gligli/overcycler/manual/GliGli's Overcycler - Build manual/07b - Solder cable to LCD.JPG

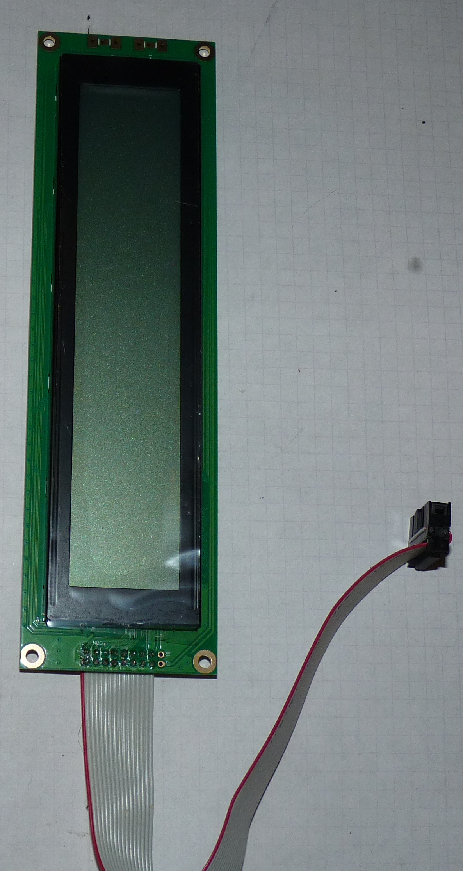
manual/GliGli's Overcycler - Build manual/07b - Solder cable to LCD.JPG
