gligli/overcycler/manual/GliGli's Overcycler - Build manual/12d - Screw panel onto enclosure top.JPG

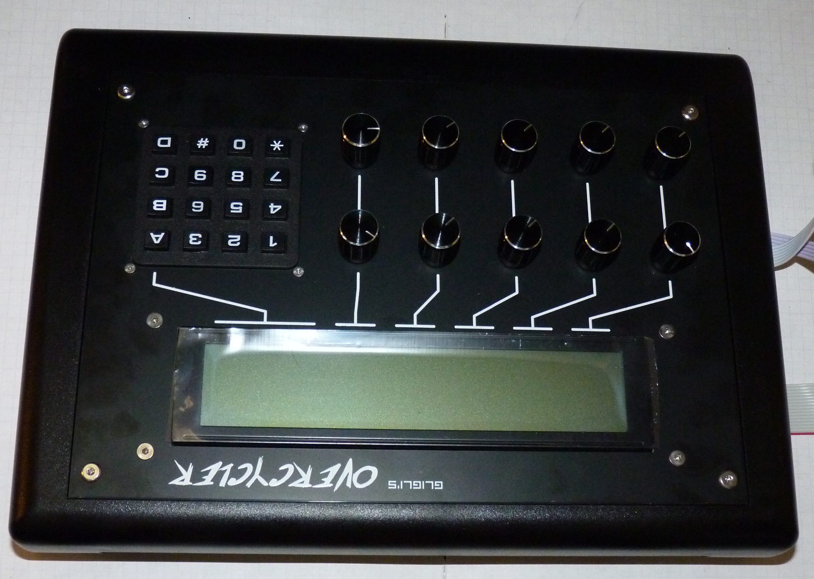
manual/GliGli's Overcycler - Build manual/12d - Screw panel onto enclosure top.JPG
