gligli/overcycler/hardware/spice/vca.ods

time | V(mid) |  | 256
0,00E+00 | -1,26E-03 | 0,00E+00 | 0,0133506639882813 | -1,26E-03 | 1,99999999495049E-06 | 3 | 0 | 3 | 15290 | #NUM! | 0
2,00E-06 | -1,26E-03 | 2,00E-06 |  | 0,0120926829882813 | 0,0233061874998386 | 30547 | 1 | 30577 | 32178,5 | 8722 | 8722
4,00E-06 | -1,26E-03 | 4,00E-06 |  | 0,0254433469765625 | 0,0257475937498386 | 33747 | 2 | 33780 | 34741 | 15828,6334113864 | 15829
8,00E-06 | -1,26E-03 | 8,00E-06 |  | 0,0387940109648438 | 0,0272124374998387 | 35667 | 3 | 35702 | 36374,5 | 19985,7474634195 | 19986
1,60E-05 | -1,26E-03 | 1,60E-05 |  | 0,052144674953125 | 0,0282378281248387 | 37011 | 4 | 37047 | 37559,5 | 22935,2668227728 | 22935
3,20E-05 | -1,26E-03 | 3,20E-05 |  | 0,0654953389414062 | 0,0290190781248387 | 38035 | 5 | 38072 | 38520,5 | 25223,0917779633 | 25223
6,40E-05 | -1,26E-03 | 6,40E-05 |  | 0,0788460029296875 | 0,0297026718748387 | 38931 | 6 | 38969 | 39321,5 | 27092,380874806 | 27092
1,13E-04 | -1,26E-03 | 1,13E-04 |  | 0,0921966669179687 | 0,0302397812498387 | 39635 | 7 | 39674 | 39994 | 28672,8422867147 | 28673
1,62E-04 | -1,26E-03 | 1,62E-04 |  | 0,10554733090625 | 0,0307280624998387 | 40275 | 8 | 40314 | 40602,5 | 30041,9002341592 | 30042
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
