gligli/overcycler/hardware/spice/vcnoise.ods

time | V(n011)
0,00E+00 | 3,08E+00 | 9,96E-04 | 5,06E-02 | 0,01209409729 | 0,0009964454 | 0,0009964454 | 0,0506104486 | 65535
1,00E-09 | 3,08E+00 | 9,96E-04 | 5,06E-02 | 13194 | 0,0130905427 | 0,0200915597 | 0,0235321181 | 30472
2,00E-09 | 3,08E+00 | 9,96E-04 | 5,06E-02 | 1 | 0,0251846400 | 0,0391119379 | 0,0211822659 | 27429
4,00E-09 | 3,08E+00 | 9,96E-04 | 5,06E-02 |  | 0,0372787373 | 0,0580578724 | 0,0198104485 | 25652
8,00E-09 | 3,08E+00 | 9,96E-04 | 5,06E-02 | -0,63212055883 | 0,0493728345 | 0,0769296546 | 0,0188324394 | 24386
1,60E-08 | 3,08E+00 | 9,96E-04 | 5,06E-02 |  | 0,0614669318 | 0,0957275748 | 0,0180711238 | 23400
3,20E-08 | 3,08E+00 | 9,96E-04 | 5,06E-02 |  | 0,0735610291 | 0,1144519220 | 0,0174522776 | 22599
6,40E-08 | 3,08E+00 | 9,96E-04 | 5,06E-02 |  | 0,0856551264 | 0,1331029841 | 0,0169208561 | 21911
1,28E-07 | 3,08E+00 | 9,96E-04 | 5,06E-02 |  | 0,0977492237 | 0,1516810481 | 0,0164647883 | 21320
2,56E-07 | 3,08E+00 | 9,96E-04 | 5,06E-02 |  | 0,1098433210 | 0,1701863995 | 0,0160561739 | 20791
5,12E-07 | 3,08E+00 | 9,96E-04 | 5,06E-02 |  | 0,1219374183 | 0,1886193231 | 0,0156963182 | 20325
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
