gligli/overcycler/enclosure/PT-10 Rear/PT-10 Rear.jpg

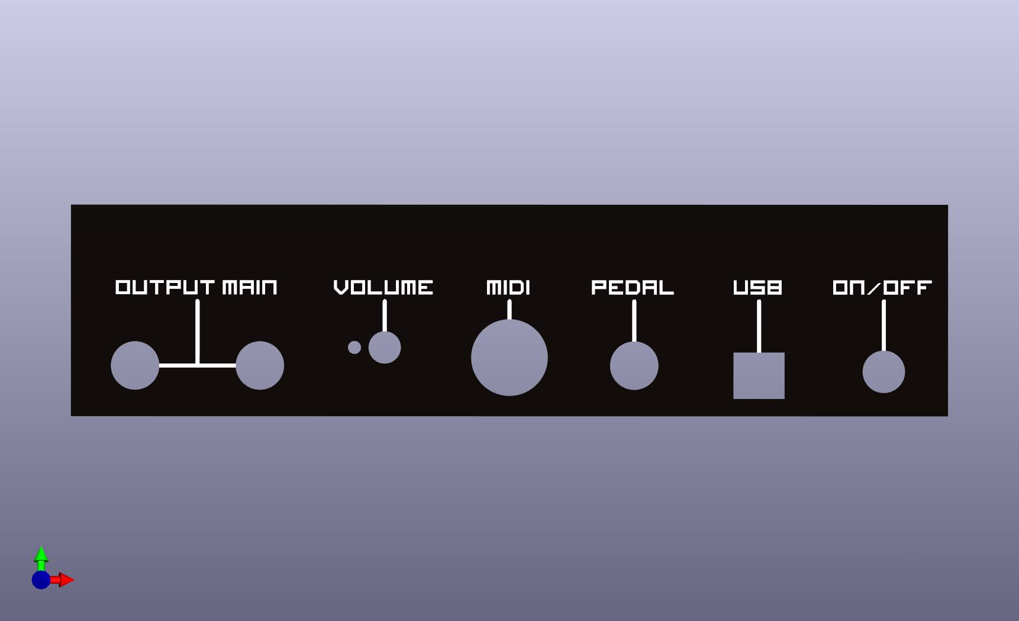
enclosure/PT-10 Rear/PT-10 Rear.jpg
