gligli/overcycler/enclosure/PT-10 Top/PT-10.jpg

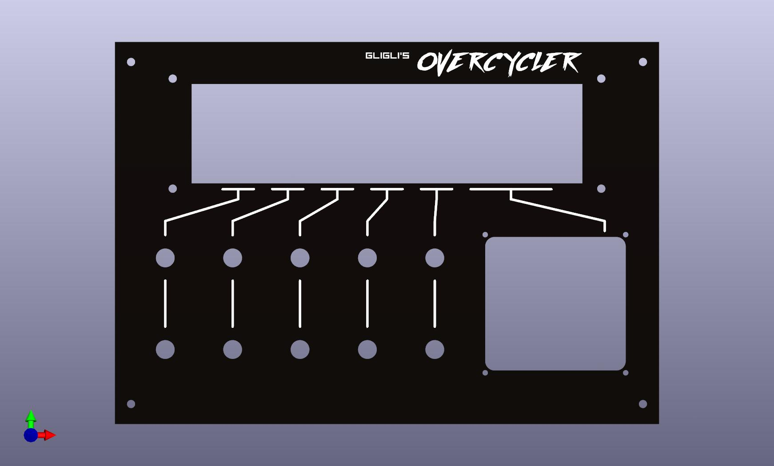
enclosure/PT-10 Top/PT-10.jpg
