gligli/overcycler/enclosure/PT-10 Rear/PT-10 Rear.FCStd

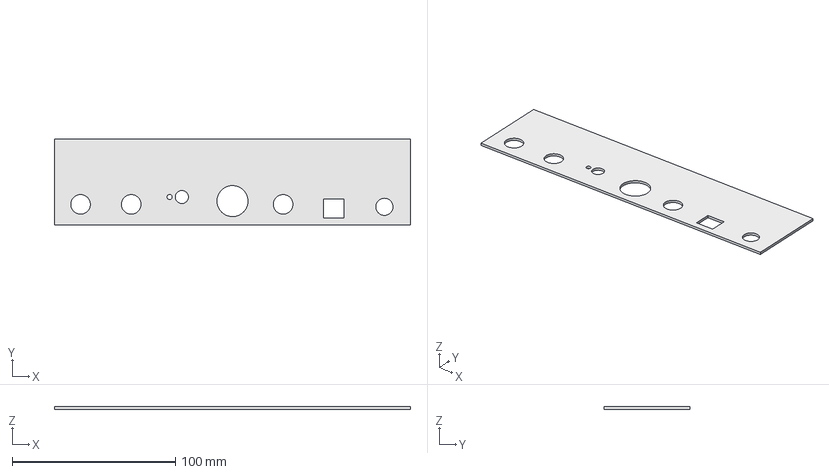
[picture p5: CAD file, 2024-06-20]
enclosure/PT-10 Rear/PT-10 Rear.FCStd
217.9 x 52.6 x 1.60 mm
