gligli/overcycler/enclosure/PT-10 Top/PT-10.dxf

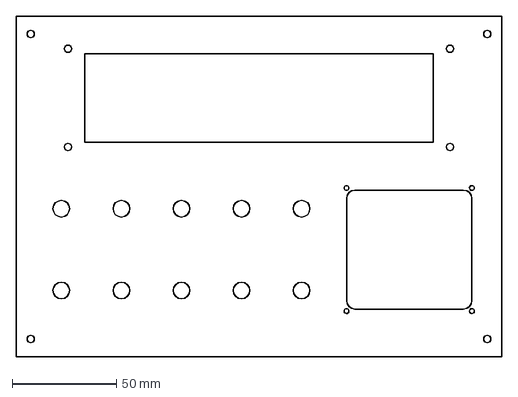
[picture p6: CAD file, 2024-05-10]
enclosure/PT-10 Top/PT-10.dxf
232.4 x 163.3 mm
