gligli/overcycler/enclosure/WH148/WH148.step

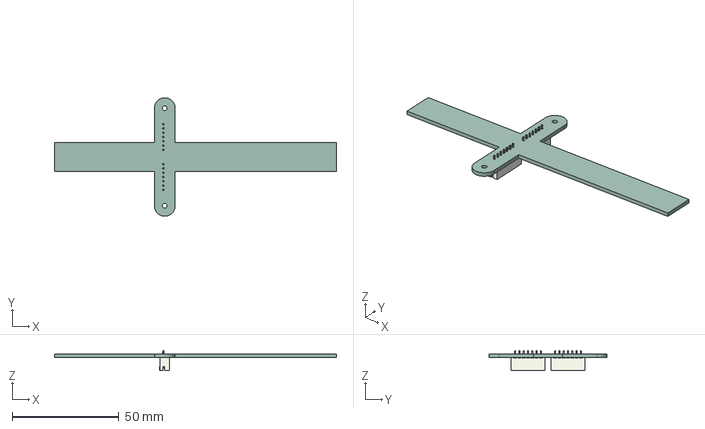
[picture p7: CAD file, 2024-08-11]
enclosure/WH148/WH148.step
132.1 x 55.5 x 9.40 mm
JST_B7B_PH_K x 2
_autosave-WH148_PCB
