gligli/overcycler/enclosure/WH148/PT-10 Top Potentiometer-CorpsPocket001.step

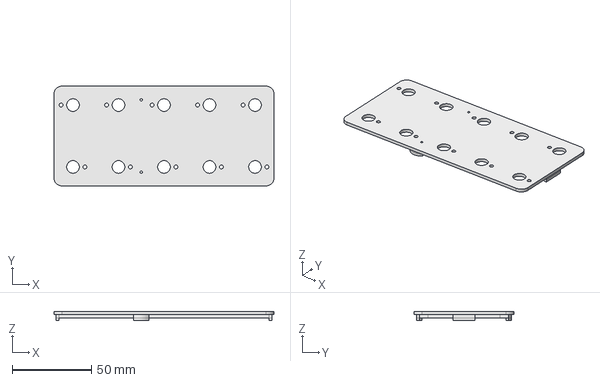
[picture p8: CAD file, 2024-08-11]
enclosure/WH148/PT-10 Top Potentiometer-CorpsPocket001.step
139.1 x 63.1 x 5.60 mm
