gligli/overcycler/enclosure/WH148/PT-10 Top Potentiometer.dxf

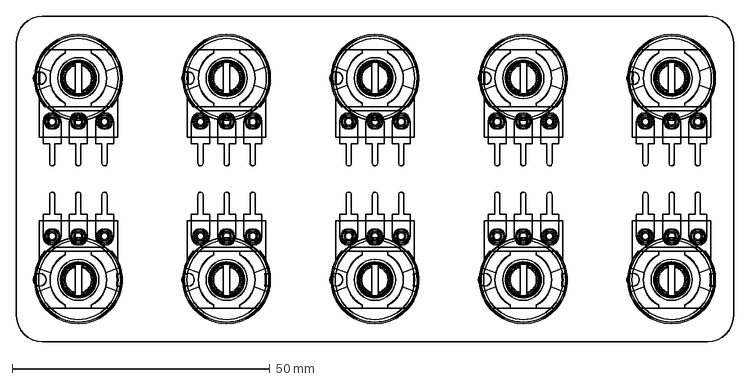
[picture p9: CAD file, 2024-08-11]
enclosure/WH148/PT-10 Top Potentiometer.dxf
139.1 x 63.1 mm
