gligli/overcycler/(list of files, cad)

Other CAD files:
enclosure/PT-10 Rear/PT-10 Rear.dxf
enclosure/PT-10 Top/PT-10 Top Silkscreen.dxf
enclosure/WH148/WH148.FCStd
