gligli/overcycler/manual/GliGli's Overcycler - Build manual/01a - Prepare PCB assembly.JPG

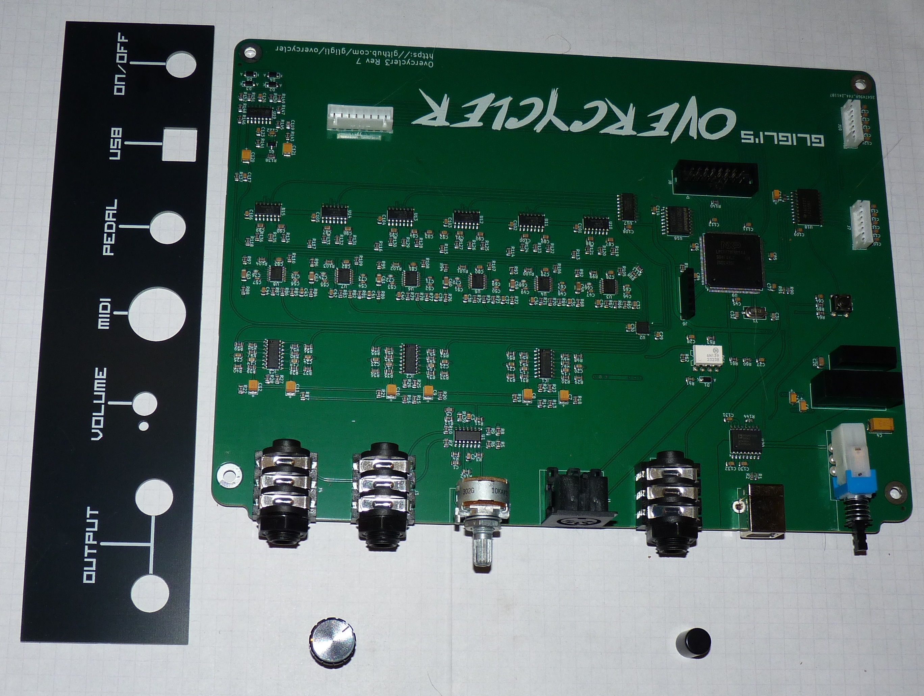
manual/GliGli's Overcycler - Build manual/01a - Prepare PCB assembly.JPG
