gligli/overcycler/manual/GliGli's Overcycler - Build manual/01b - Unscrew and put power knob.JPG

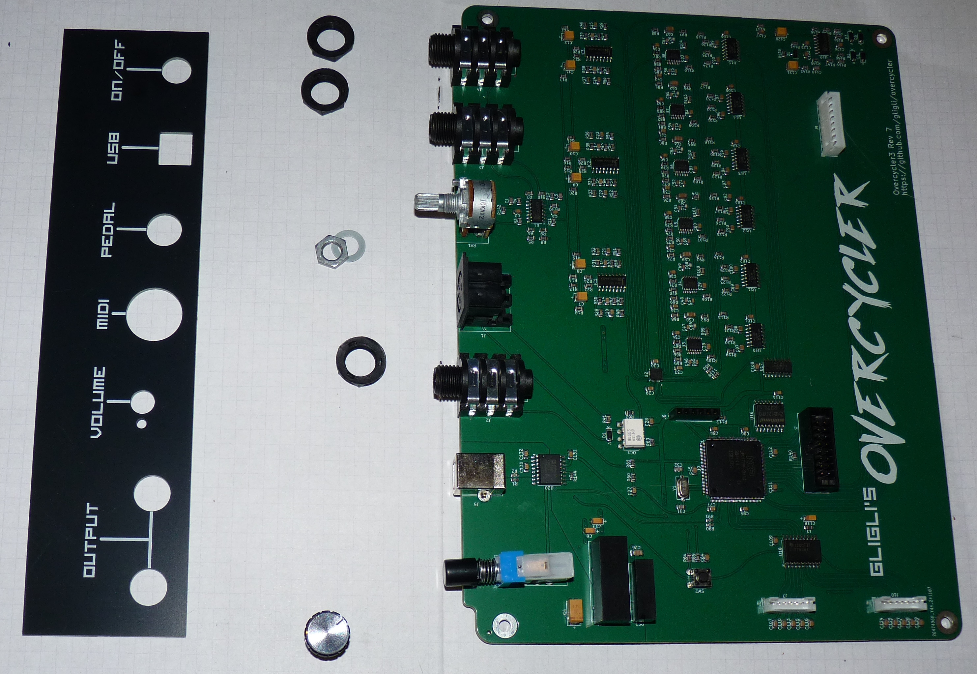
manual/GliGli's Overcycler - Build manual/01b - Unscrew and put power knob.JPG
