gligli/overcycler/manual/GliGli's Overcycler - Build manual/01c - Mount rear panel and put volume knob.JPG

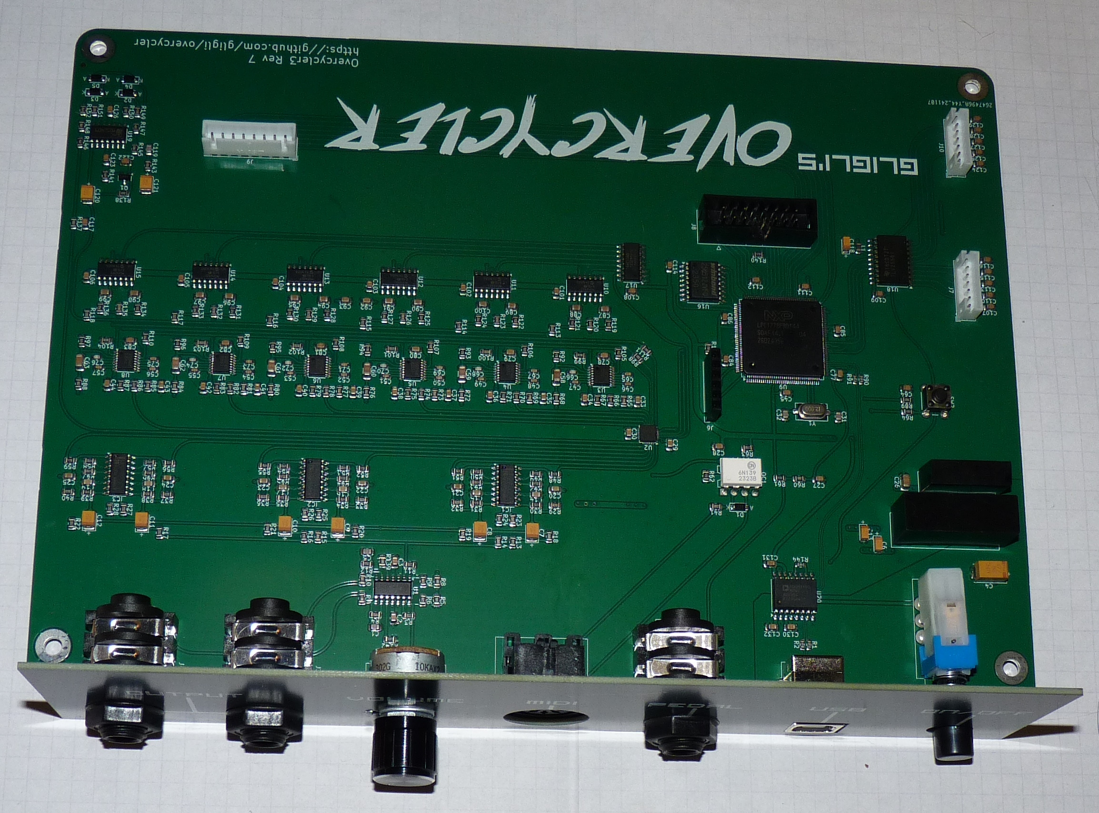
manual/GliGli's Overcycler - Build manual/01c - Mount rear panel and put volume knob.JPG
