gligli/overcycler/manual/GliGli's Overcycler - Build manual/02a - Prepare enclosure bottom assembly.JPG

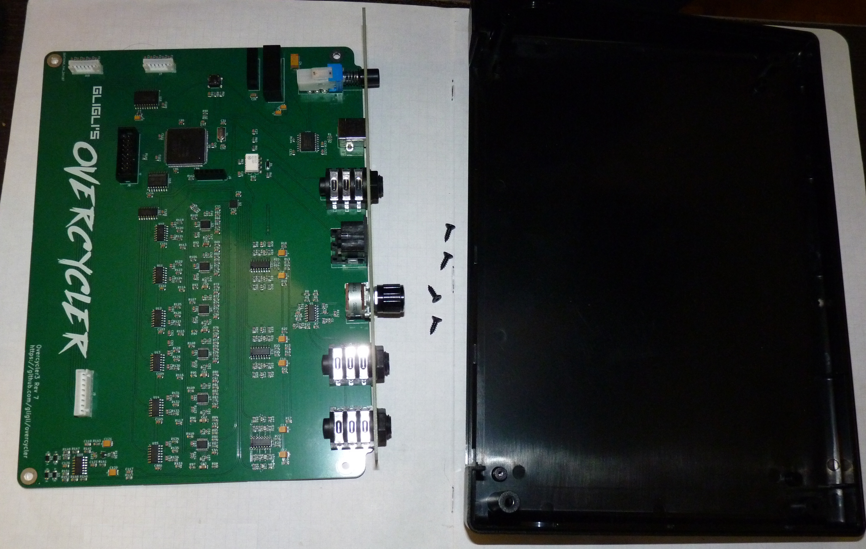
manual/GliGli's Overcycler - Build manual/02a - Prepare enclosure bottom assembly.JPG
