gligli/overcycler/manual/GliGli's Overcycler - Build manual/02b - Screw PCB in enclosure bottom.JPG

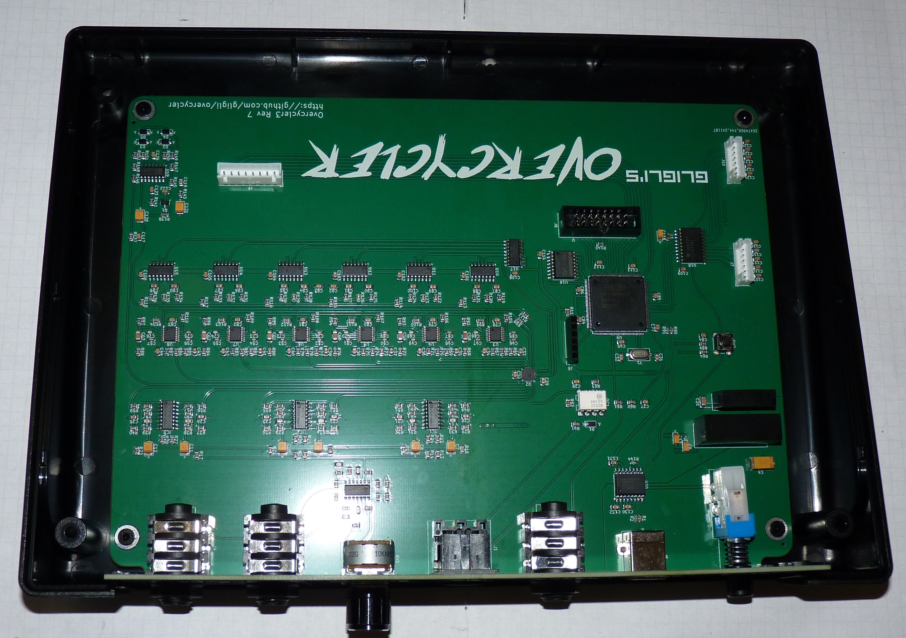
manual/GliGli's Overcycler - Build manual/02b - Screw PCB in enclosure bottom.JPG
