gligli/overcycler/manual/GliGli's Overcycler - Build manual/03a - Prepare potentiometers PCB.JPG

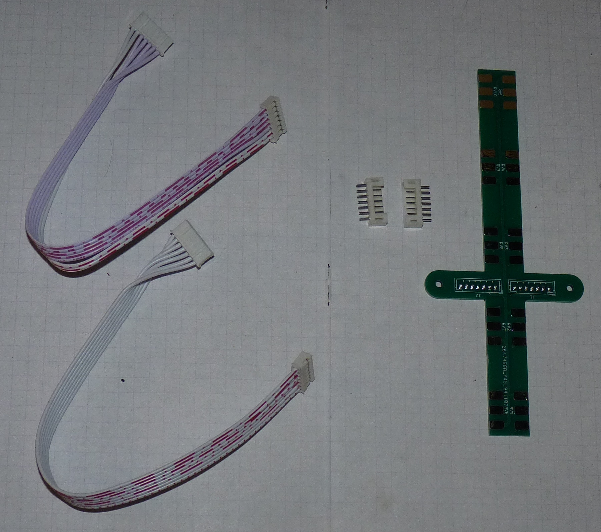
manual/GliGli's Overcycler - Build manual/03a - Prepare potentiometers PCB.JPG
