gligli/overcycler/manual/GliGli's Overcycler - Build manual/03b - Solder connectors and plug cables.JPG

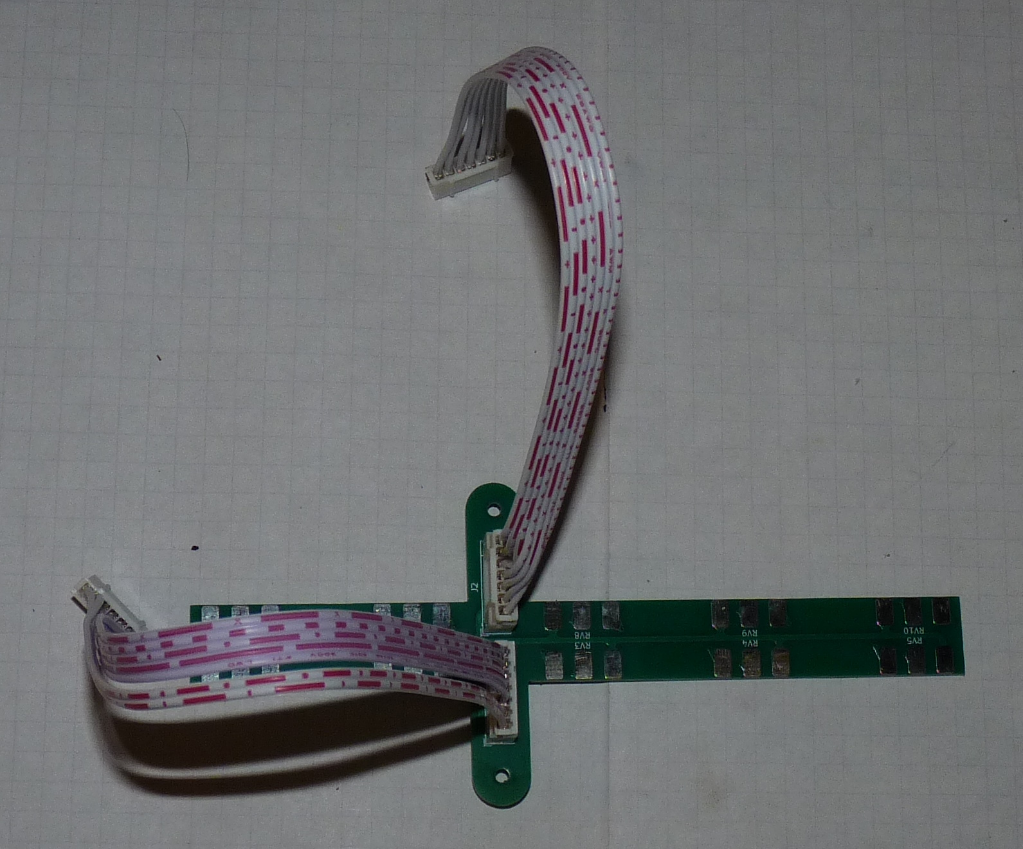
manual/GliGli's Overcycler - Build manual/03b - Solder connectors and plug cables.JPG
