gligli/overcycler/manual/GliGli's Overcycler - Build manual/04a - Prepare potentiometers spacer assembly.JPG

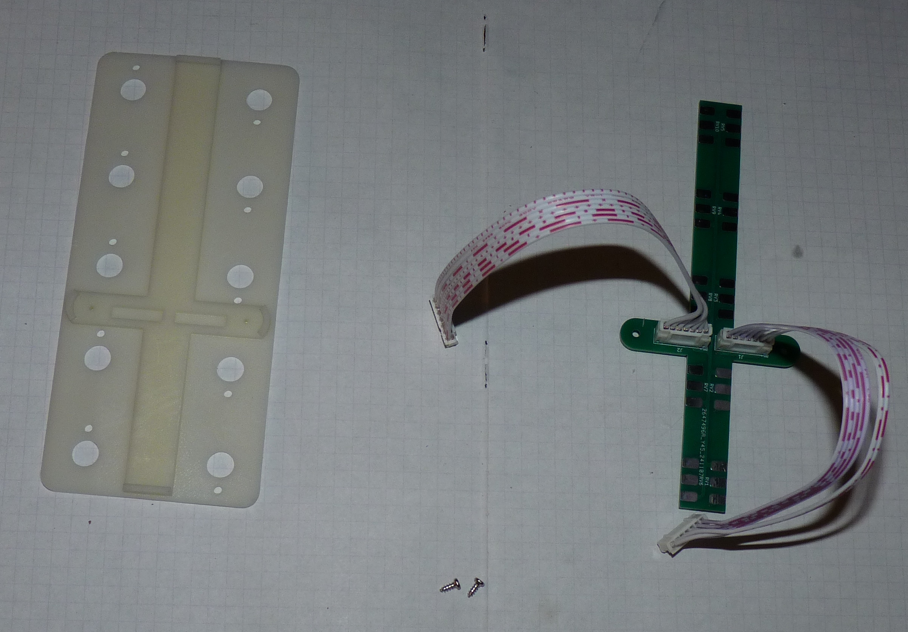
manual/GliGli's Overcycler - Build manual/04a - Prepare potentiometers spacer assembly.JPG
