gligli/overcycler/manual/GliGli's Overcycler - Build manual/04b - Screw PCB on spacer.JPG

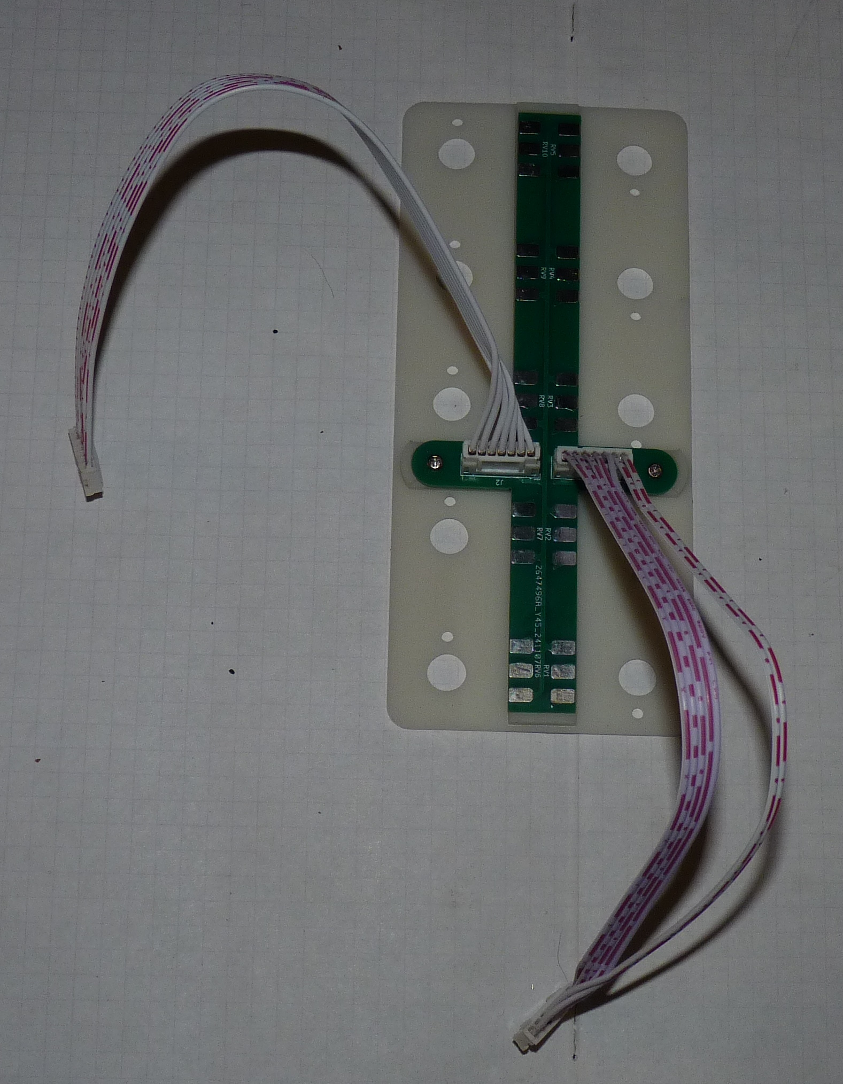
manual/GliGli's Overcycler - Build manual/04b - Screw PCB on spacer.JPG
