gligli/overcycler/manual/GliGli's Overcycler - Build manual/05a - Prepare keypad assembly.JPG

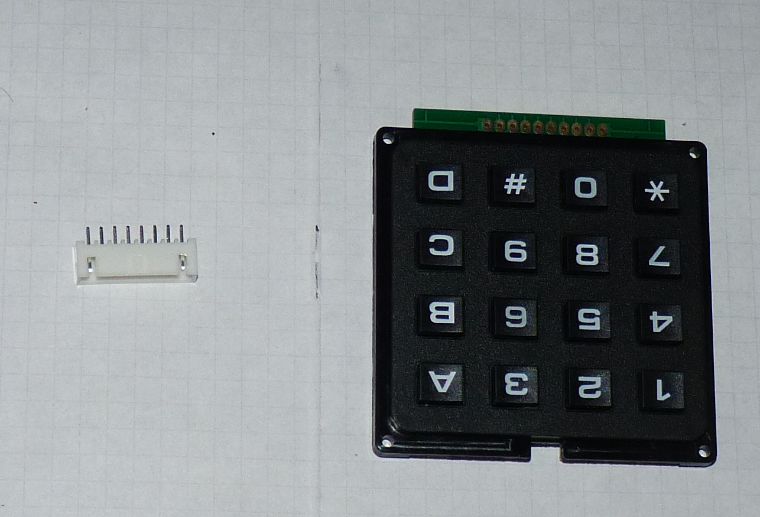
manual/GliGli's Overcycler - Build manual/05a - Prepare keypad assembly.JPG
