gligli/overcycler/manual/GliGli's Overcycler - Build manual/05b - Place connector on keypad.JPG

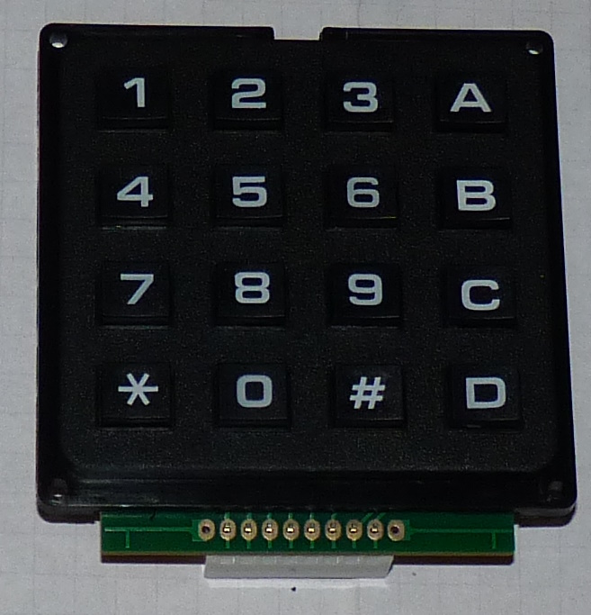
manual/GliGli's Overcycler - Build manual/05b - Place connector on keypad.JPG
