gligli/overcycler/manual/GliGli's Overcycler - Build manual/05c - Place connector on keypad (bis).JPG

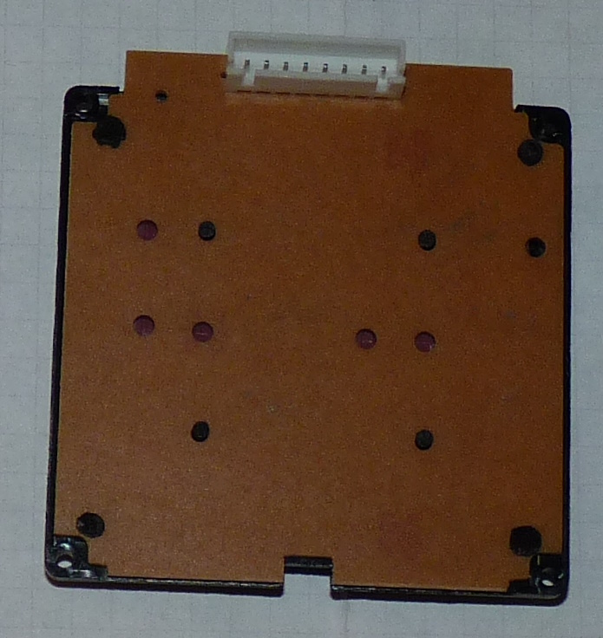
manual/GliGli's Overcycler - Build manual/05c - Place connector on keypad (bis).JPG
