gligli/overcycler/manual/GliGli's Overcycler - Build manual/05d - Solder connector on keypad.JPG

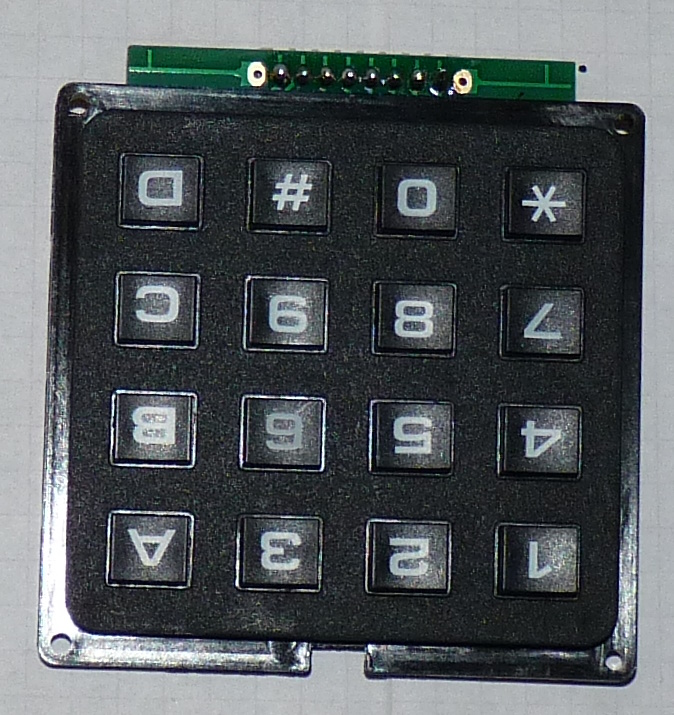
manual/GliGli's Overcycler - Build manual/05d - Solder connector on keypad.JPG
