gligli/overcycler/manual/GliGli's Overcycler - Build manual/06a - Prepare LCD modification.JPG

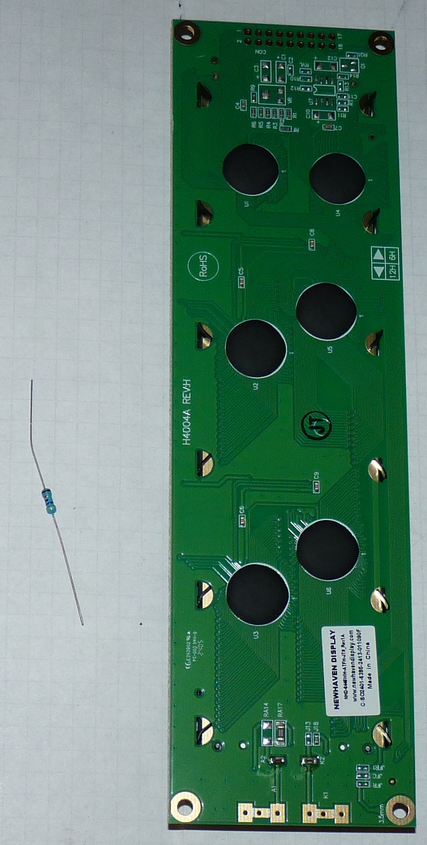
manual/GliGli's Overcycler - Build manual/06a - Prepare LCD modification.JPG
