gligli/overcycler/manual/GliGli's Overcycler - Build manual/06b - Desolder 2 SMT resistors (J18, RA17); solder through hole resistor (RA14); short pads (J13).JPG

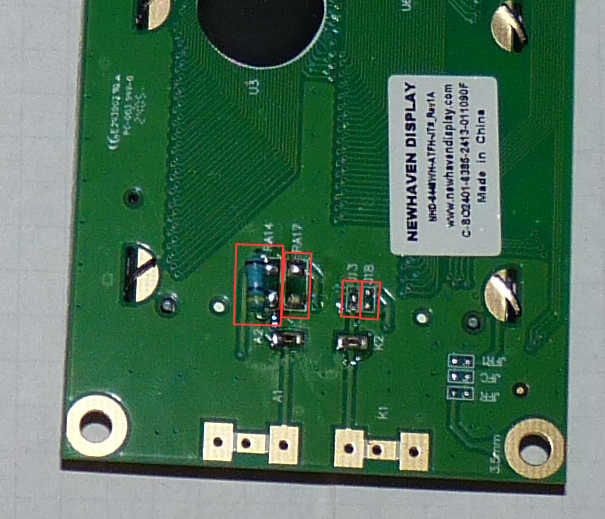
manual/GliGli's Overcycler - Build manual/06b - Desolder 2 SMT resistors (J18, RA17); solder through hole resistor (RA14); short pads (J13).JPG
