gligli/overcycler/manual/GliGli's Overcycler - Build manual/07a - Prepare LCD assembly.JPG

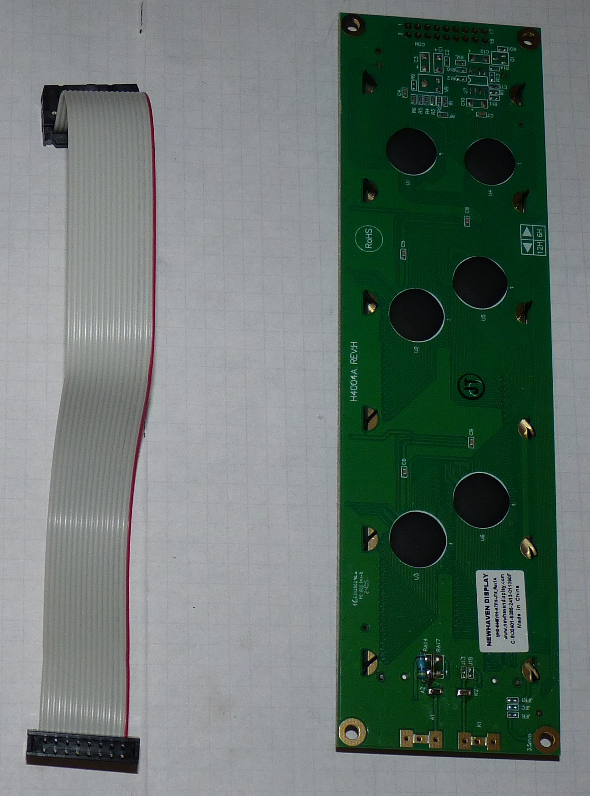
manual/GliGli's Overcycler - Build manual/07a - Prepare LCD assembly.JPG
