gligli/overcycler/manual/GliGli's Overcycler - Build manual/08a - Prepare panel potentiometers.JPG

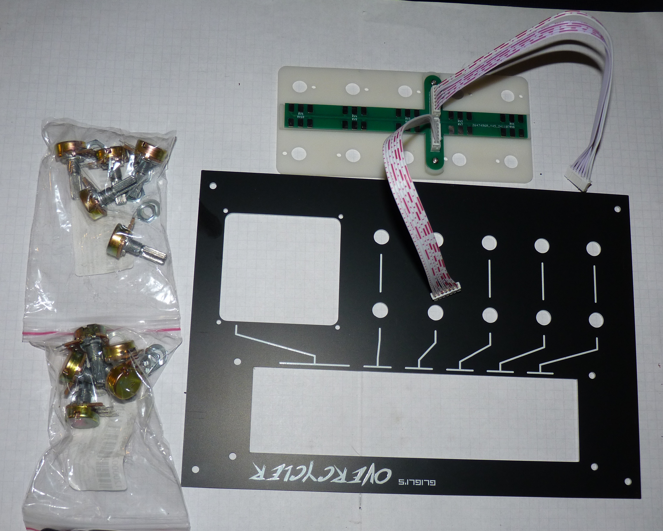
manual/GliGli's Overcycler - Build manual/08a - Prepare panel potentiometers.JPG
