gligli/overcycler/manual/GliGli's Overcycler - Build manual/08b - Position spacer, potentiometers.JPG

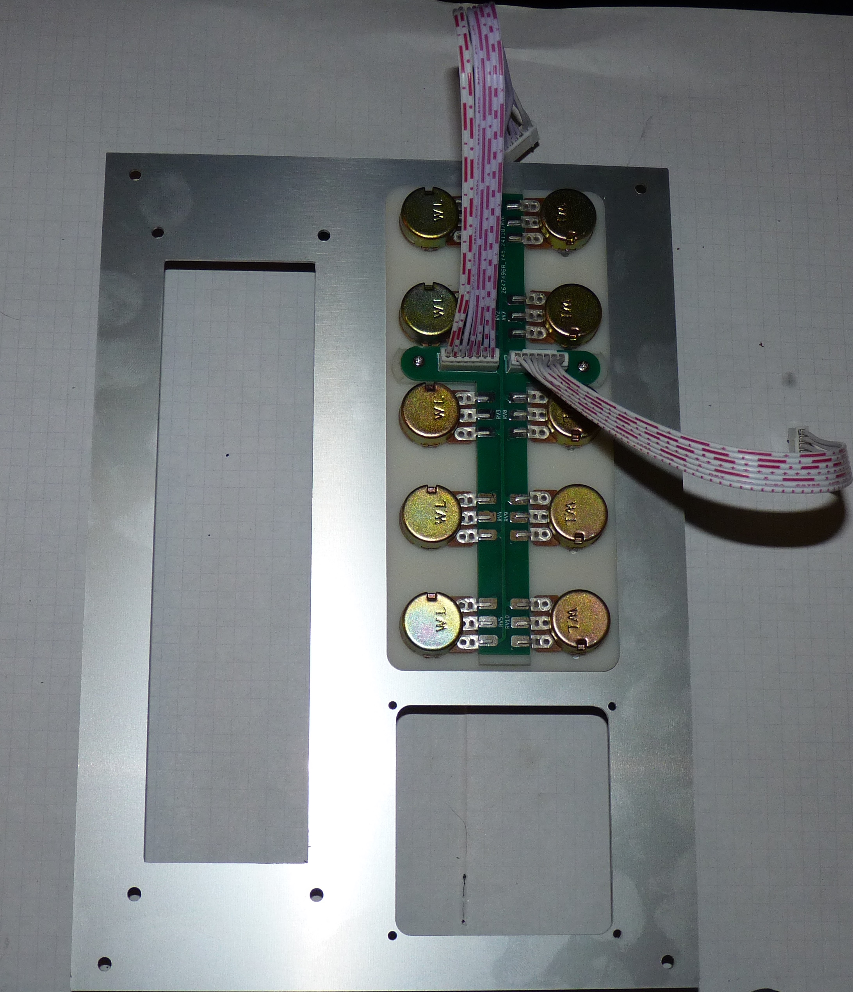
manual/GliGli's Overcycler - Build manual/08b - Position spacer, potentiometers.JPG
