gligli/overcycler/manual/GliGli's Overcycler - Build manual/08c - Screw potentiometers.JPG

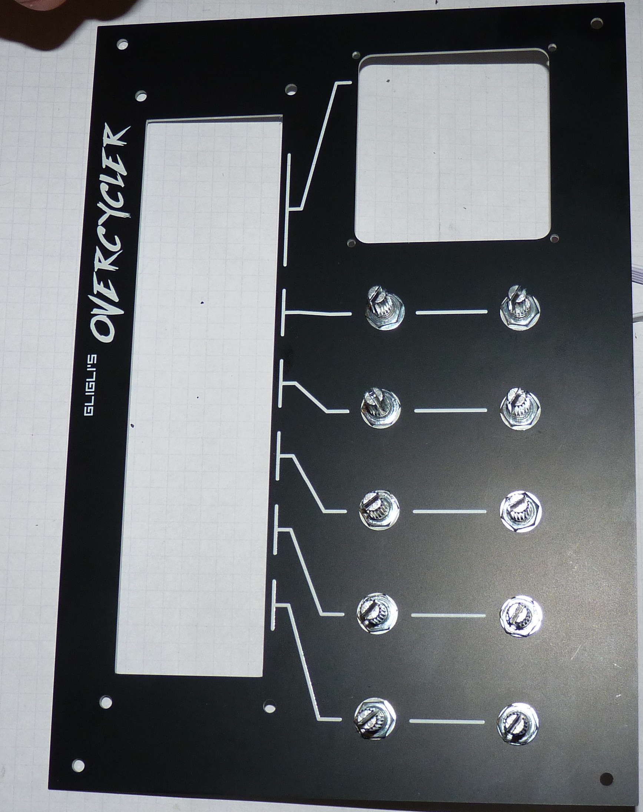
manual/GliGli's Overcycler - Build manual/08c - Screw potentiometers.JPG
