gligli/overcycler/manual/GliGli's Overcycler - Build manual/08d - Place potentiometers knobs.JPG

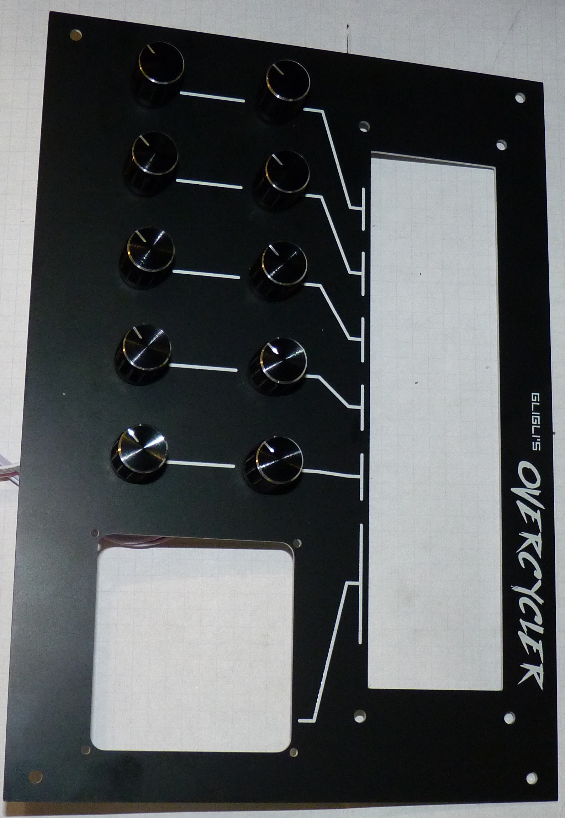
manual/GliGli's Overcycler - Build manual/08d - Place potentiometers knobs.JPG
