gligli/overcycler/manual/GliGli's Overcycler - Build manual/09a - Prepare panel keypad.JPG

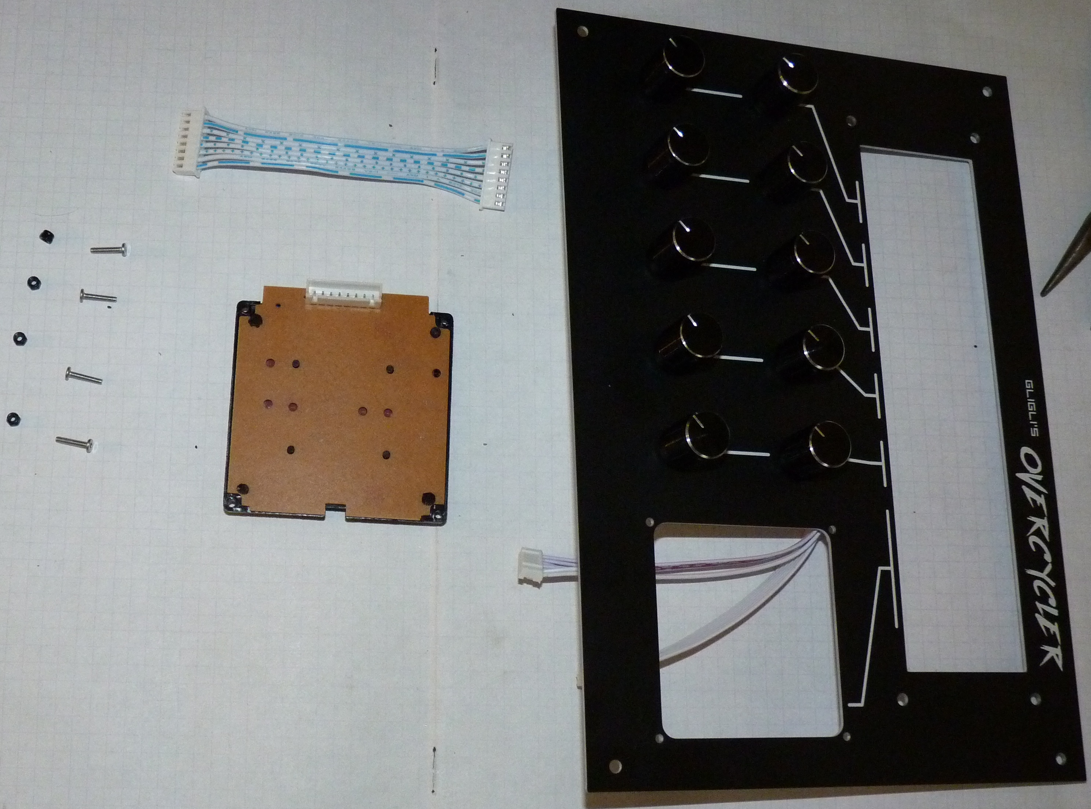
manual/GliGli's Overcycler - Build manual/09a - Prepare panel keypad.JPG
