gligli/overcycler/manual/GliGli's Overcycler - Build manual/09b - Screw keypad onto panel; plug cable.JPG

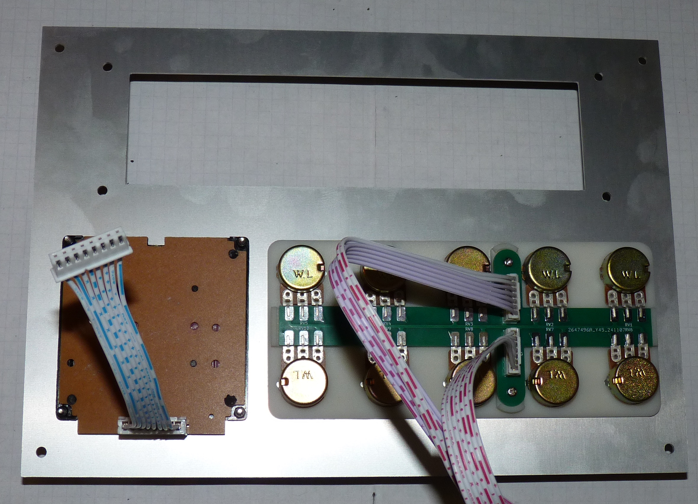
manual/GliGli's Overcycler - Build manual/09b - Screw keypad onto panel; plug cable.JPG
