gligli/overcycler/manual/GliGli's Overcycler - Build manual/09c - Screw keypad onto panel; plug cable (bis).JPG

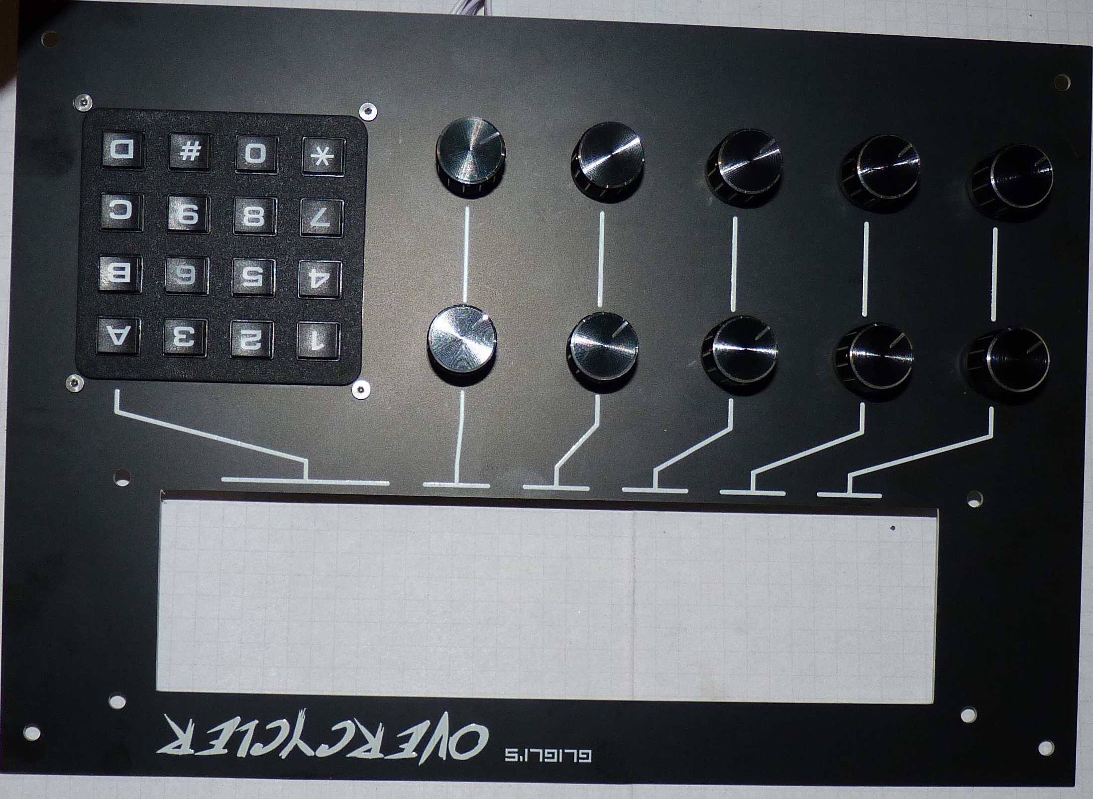
manual/GliGli's Overcycler - Build manual/09c - Screw keypad onto panel; plug cable (bis).JPG
