gligli/overcycler/manual/GliGli's Overcycler - Build manual/10a - Prepare panel LCD.JPG

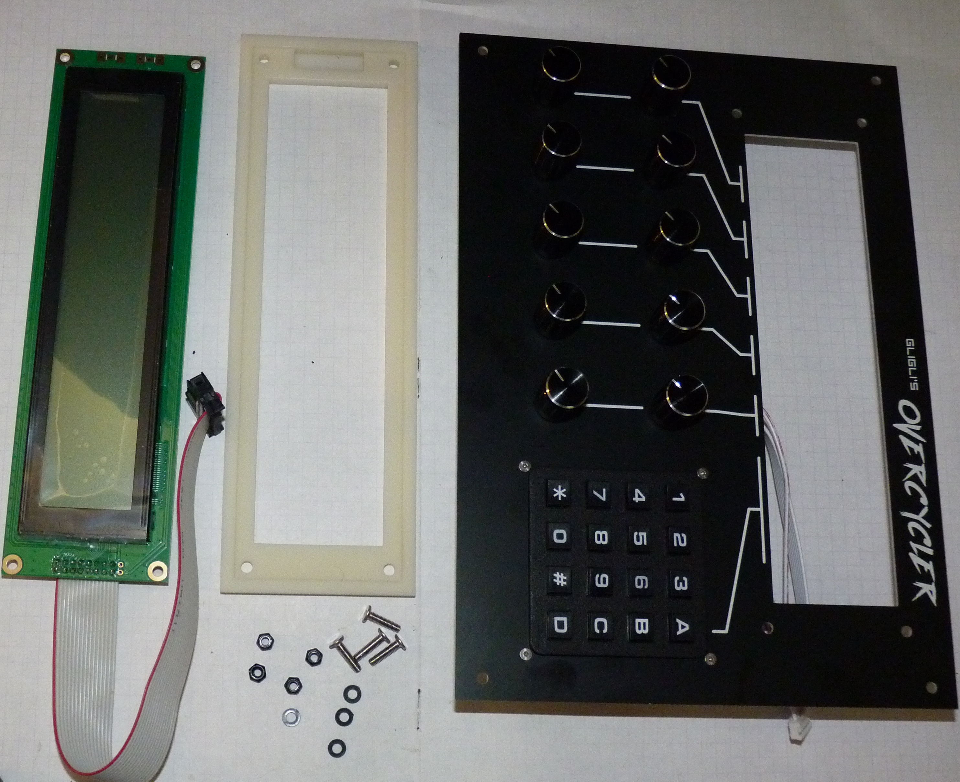
manual/GliGli's Overcycler - Build manual/10a - Prepare panel LCD.JPG
