gligli/overcycler/manual/GliGli's Overcycler - Build manual/10b - Screw LCD onto spacer onto panel.JPG

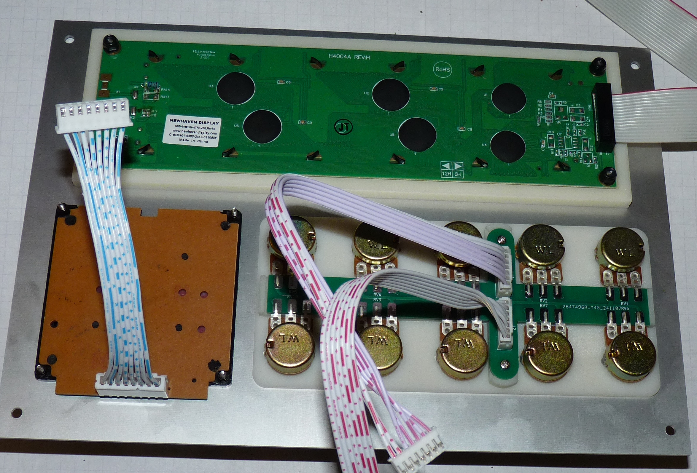
manual/GliGli's Overcycler - Build manual/10b - Screw LCD onto spacer onto panel.JPG
