gligli/overcycler/manual/GliGli's Overcycler - Build manual/10c - Screw LCD onto spacer onto panel (bis).JPG

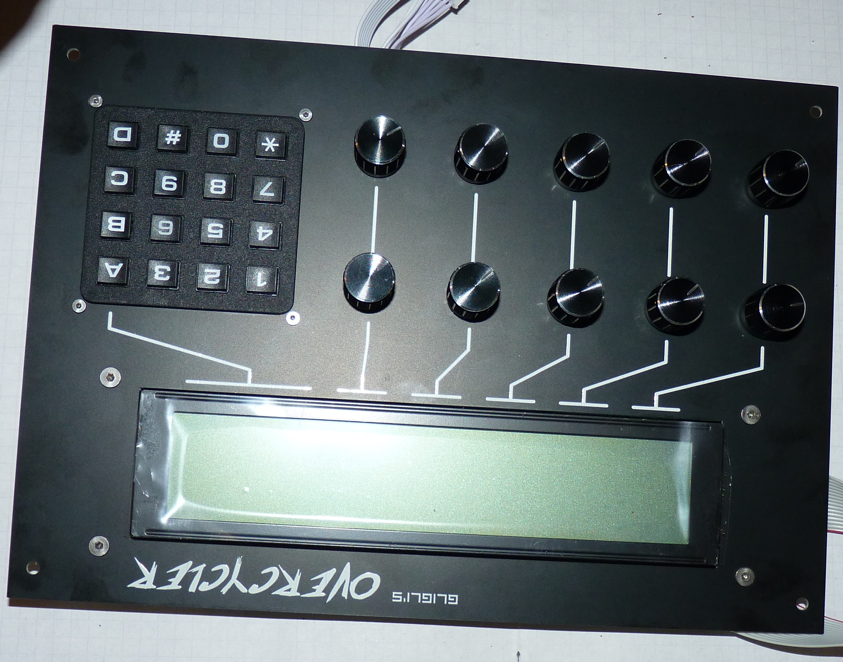
manual/GliGli's Overcycler - Build manual/10c - Screw LCD onto spacer onto panel (bis).JPG
