gligli/overcycler/manual/GliGli's Overcycler - Build manual/11 - Solder potentiometers onto PCB.JPG

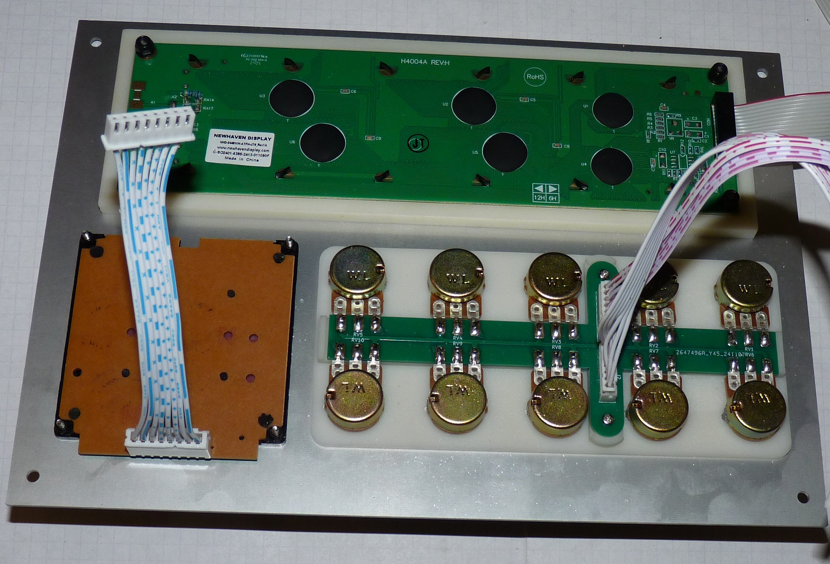
manual/GliGli's Overcycler - Build manual/11 - Solder potentiometers onto PCB.JPG
