gligli/overcycler/manual/GliGli's Overcycler - Build manual/12a - Prepare enclosure top assembly.JPG

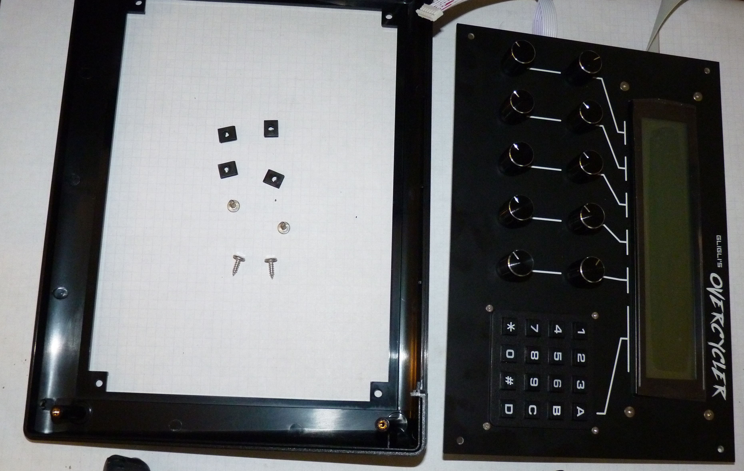
manual/GliGli's Overcycler - Build manual/12a - Prepare enclosure top assembly.JPG
