gligli/overcycler/manual/GliGli's Overcycler - Build manual/12b - Position fasteners.JPG

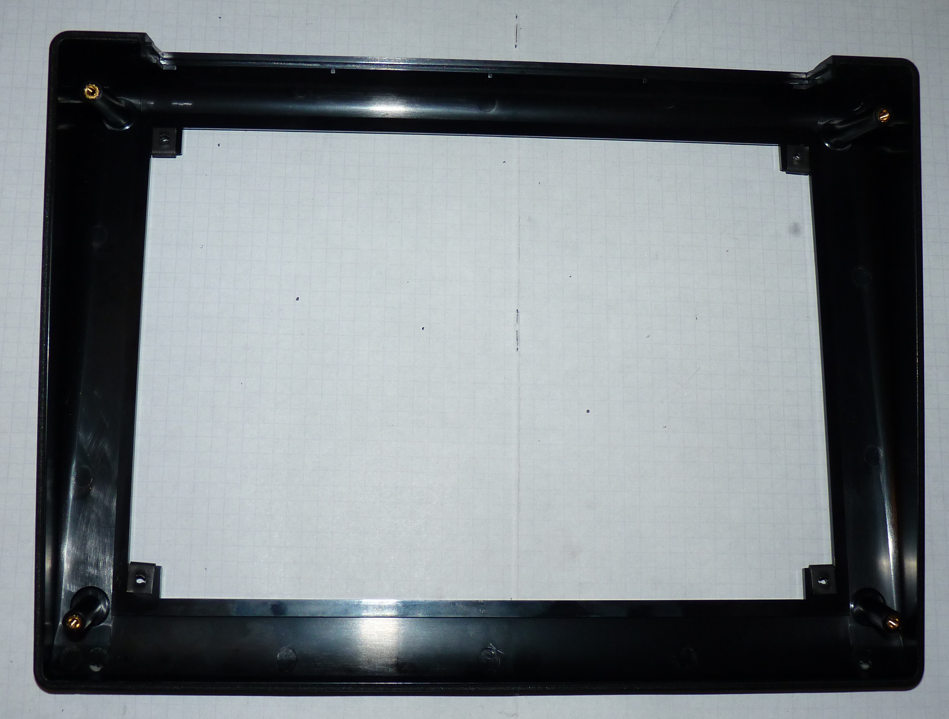
manual/GliGli's Overcycler - Build manual/12b - Position fasteners.JPG
