gligli/overcycler/manual/GliGli's Overcycler - Build manual/12c - Position fasteners (bis).JPG

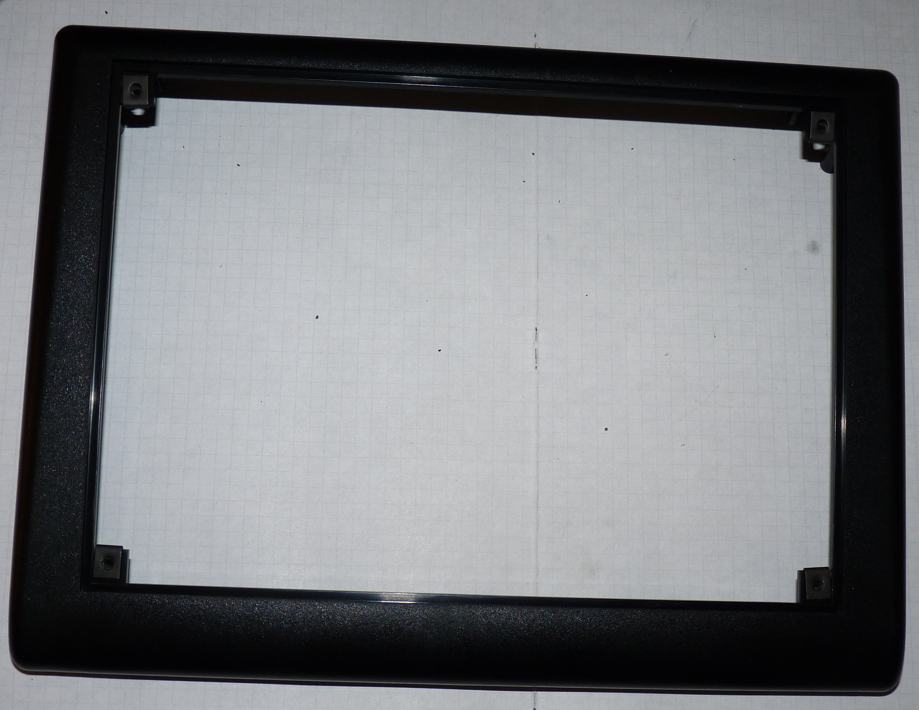
manual/GliGli's Overcycler - Build manual/12c - Position fasteners (bis).JPG
