gligli/overcycler/manual/GliGli's Overcycler - Build manual/13a - Prepare final assembly.JPG

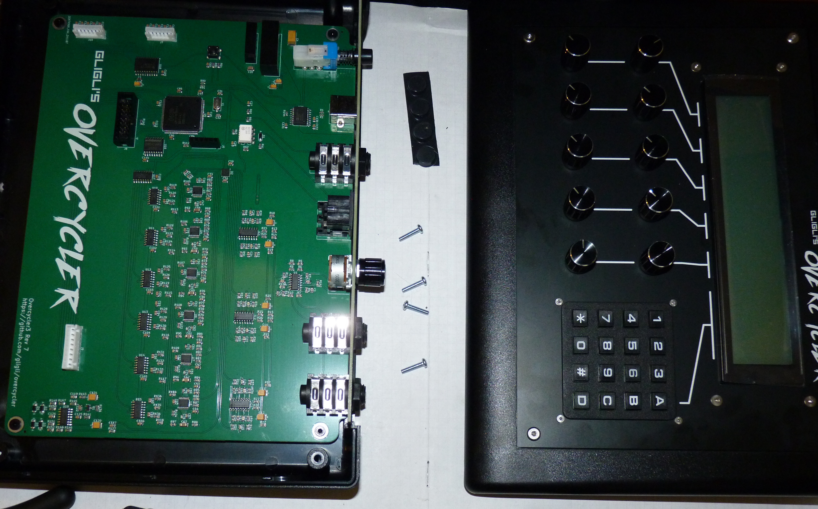
manual/GliGli's Overcycler - Build manual/13a - Prepare final assembly.JPG
