gligli/overcycler/manual/GliGli's Overcycler - Build manual/13b - Position enclosure top onto enclosure bottom.JPG

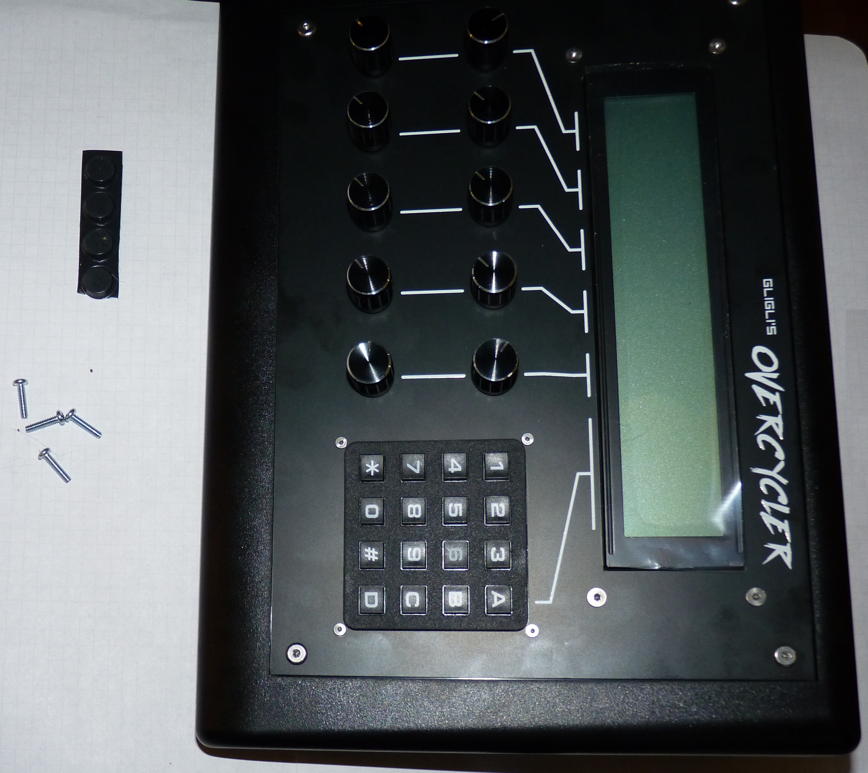
manual/GliGli's Overcycler - Build manual/13b - Position enclosure top onto enclosure bottom.JPG
