gligli/overcycler/manual/GliGli's Overcycler - Build manual/13c - Place rubber pads and screw both enclosure halves.JPG

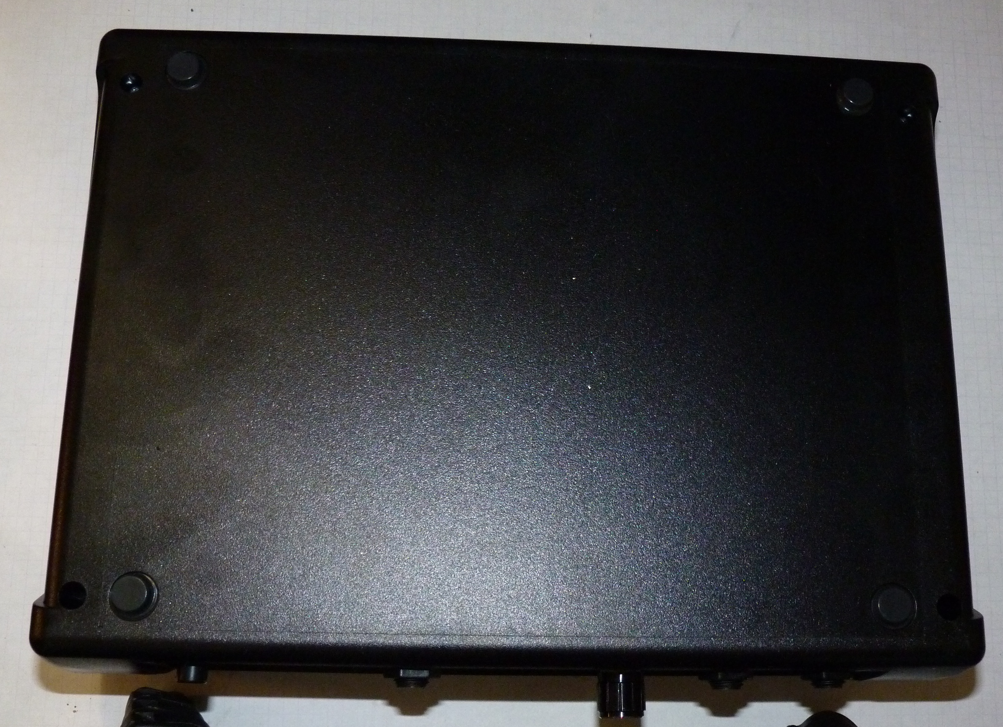
manual/GliGli's Overcycler - Build manual/13c - Place rubber pads and screw both enclosure halves.JPG
