gligli/overcycler/manual/GliGli's Overcycler - Build manual/14 - Enjoy finished GliGli's Overcycler =).JPG

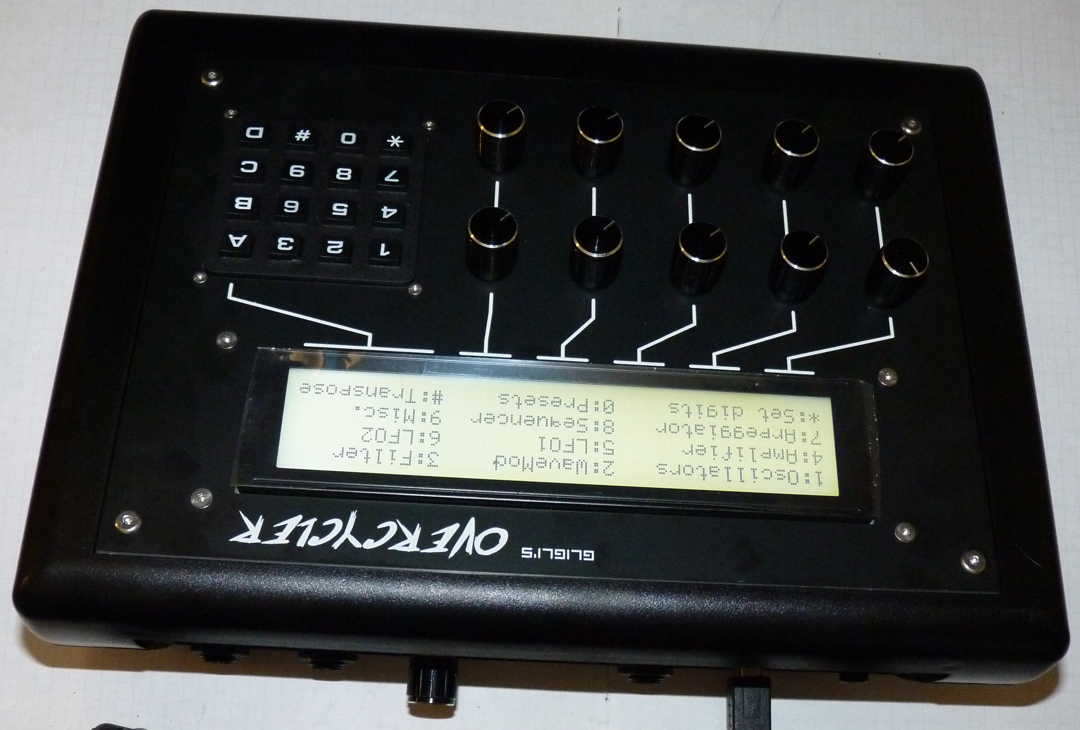
manual/GliGli's Overcycler - Build manual/14 - Enjoy finished GliGli's Overcycler =).JPG
