gligli/overcycler/doc/RK16312A0BKR.pdf

# A wide range of versatile products applicable for various types of control

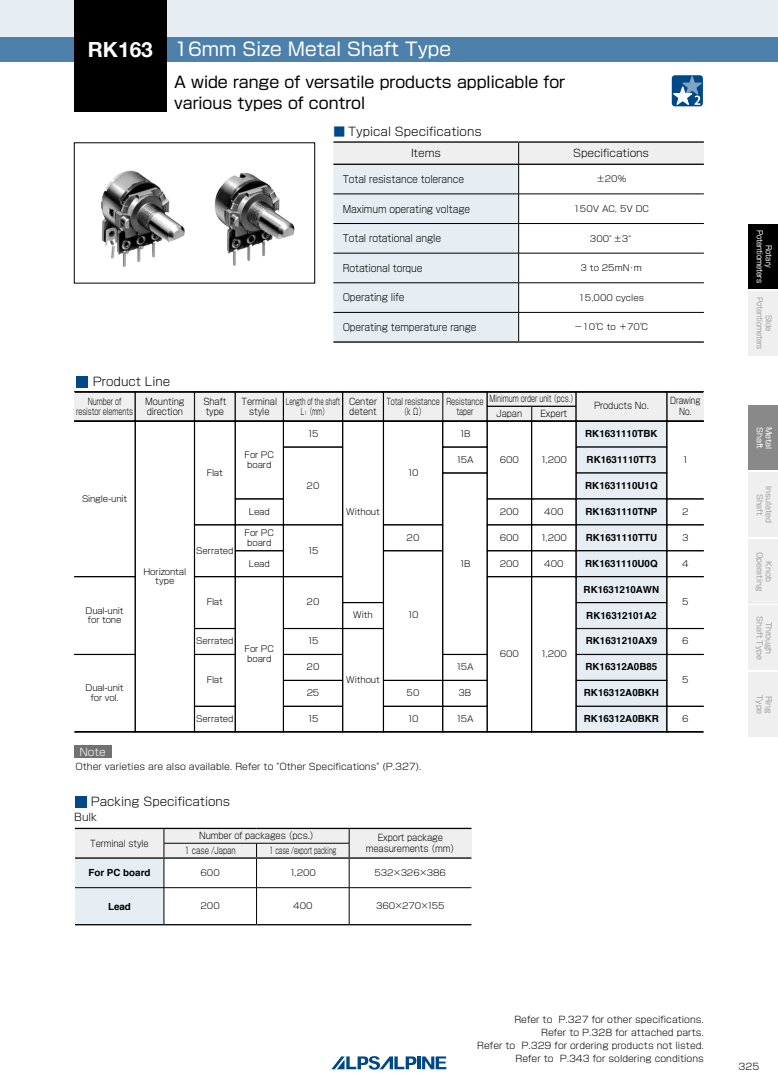
[picture p61: page 1]
Rotary; Potentiometers; Slide; Potentiometers Shaft; Metal Insulated; Shaft; Knob; Operating; Through; Ring; Product Line; Number of resistor elements; Mounting direction; Shaft type; Center detent; Total resistance （k Ω）; Resistance; Japan; Expert; Drawing No.; Single-unit; Dual-unit for tone; Dual-unit for vol.; Horizontal type; Flat; Serrated; Terminal style; For PC board; Lead; Without; With; Products No.; RK1631110TBK; RK1631110TNP; RK1631110TTU; RK1631210AWN; RK16312A0BKH; RK16312A0BKR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

RK163 16mm Size Metal Shaft Type

Minimum order unit （pcs.）
taper

Length of the shaft

Shaft Type Type

Note
Other varieties are also available. Refer to "Other Specifications" (P.327).

Refer to P.327 for other specifications.
Refer to P.328 for attached parts.

Refer to P.329 for ordering products not listed.
Refer to P.343 for soldering conditions

# 326 Rotary

Dimensions | Unit:mm

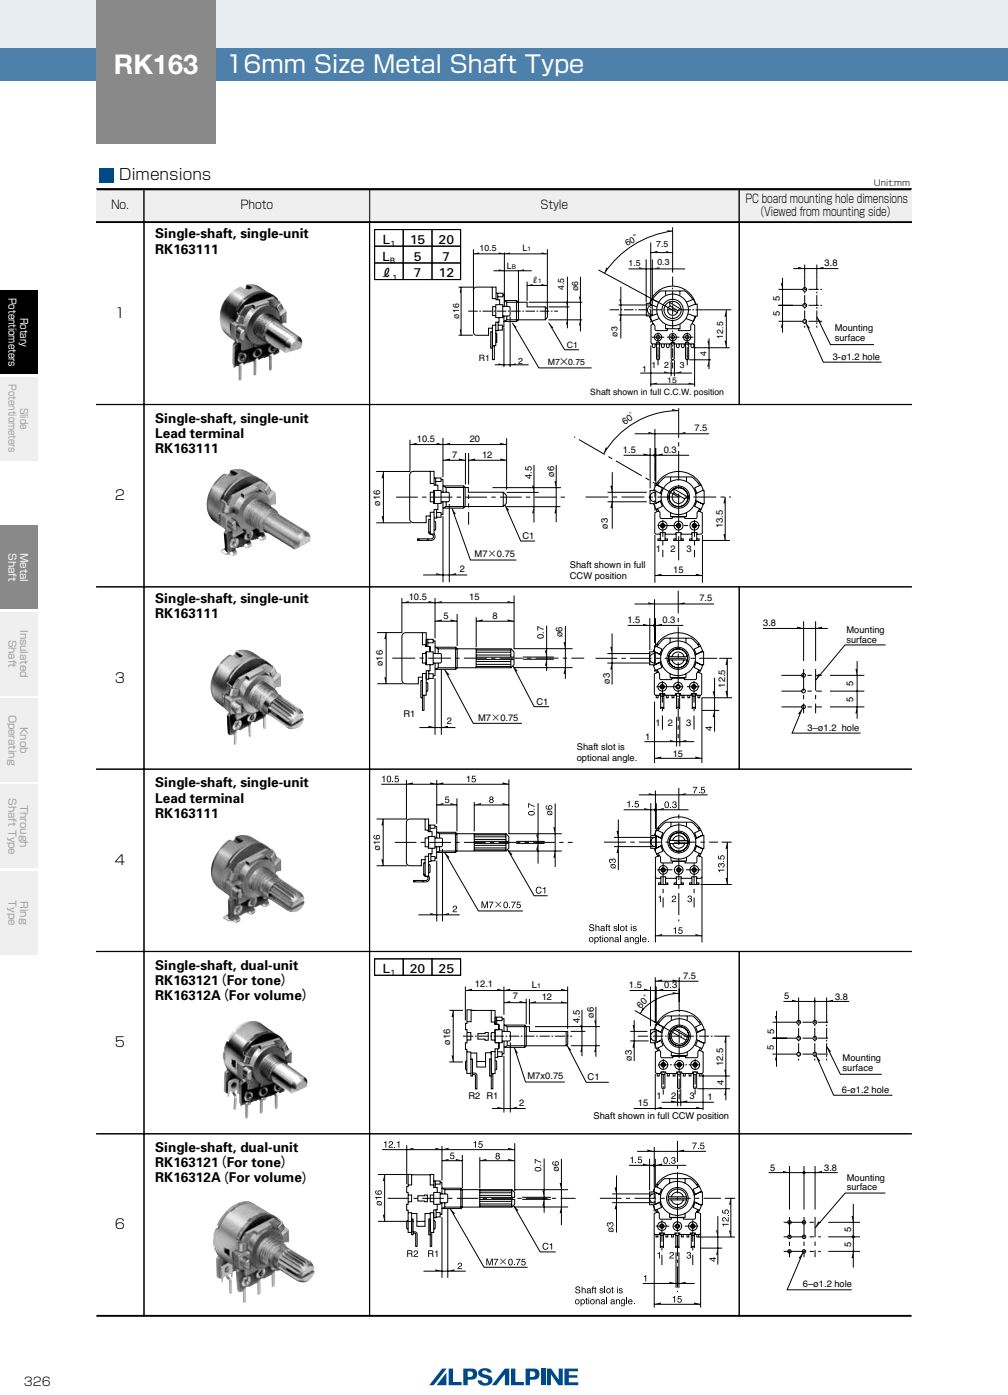
[picture p62: page 2]
Potentiometers; Slide; Potentiometers Shaft; Metal Insulated; Shaft; Knob; Operating; Through; Ring; Photo; Style; PC board mounting hole dimensions; Mounting surface 3-ø1.2 hole; Mounting surface 6-ø1.2 hole; 3–ø1.2 hole; Mounting surface; 6–ø1.2 hole

RK163 16mm Size Metal Shaft Type

Single-shaft, single-unit

（Viewed from mounting side）

Shaft shown in full C.C.W. position

Lead terminal

Shaft shown in full
CCW position

Shaft slot is
optional angle.

Shaft Type Type

Single-shaft, dual-unit
RK163121（For tone）
RK16312A（For volume）

Shaft shown in full CCW position

In addition to the products listed, we can accommodate the follow specifications.

### Total Resistance Variety

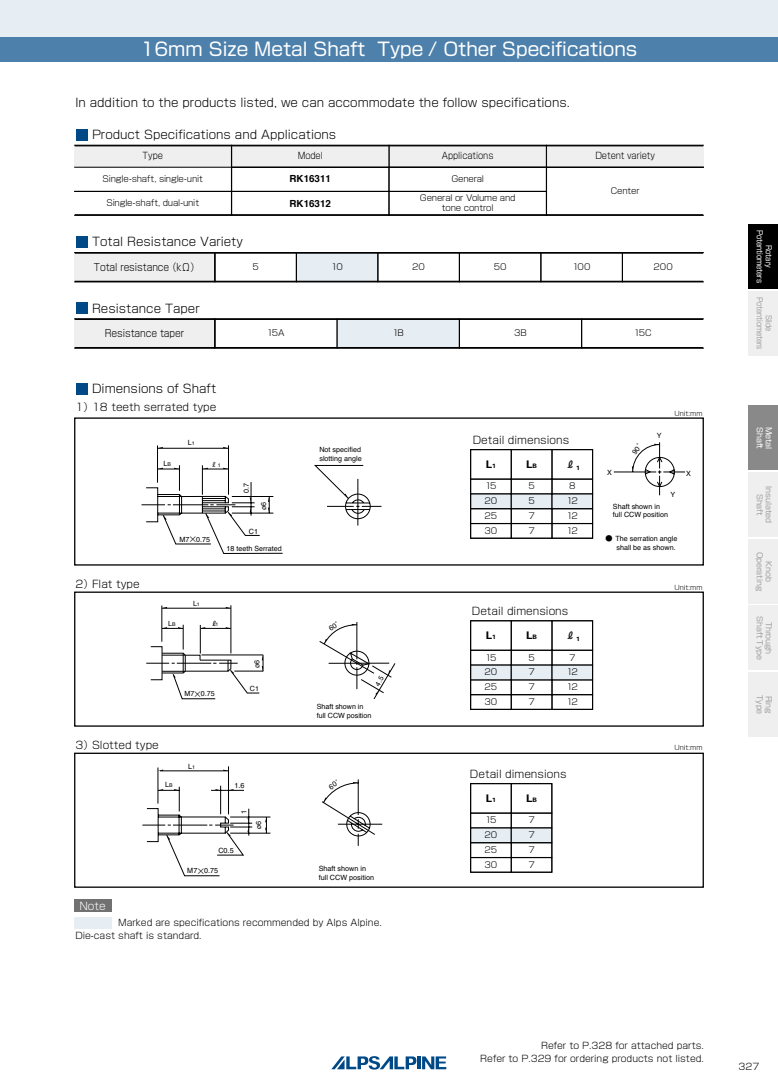
[picture p63: page 3]
Rotary; Potentiometers; Slide; Potentiometers Shaft; Metal Insulated; Shaft; Knob; Operating; Through; Ring; Applications; Total resistance （kΩ）; Center; Model; Detent variety; Resistance Taper; Resistance taper; 18 teeth Serrated ⁰.7; Not specified slotting angle; 2） Flat type; 3） Slotted type; Unit:mm; Detail dimensions; Type

16mm Size Metal Shaft Type / Other Specifications

Product Specifications and Applications

Single-shaft, single-unit

General
General or Volume and
tone control

Single-shaft, dual-unit

Dimensions of Shaft
1） 18 teeth serrated type

Shaft shown in
full CCW position
¡The serration angle
shall be as shown.

Shaft Type Type

Note
Marked are specifications recommended by Alps Alpine.

Die-cast shaft is standard.

Refer to P.328 for attached parts.

Refer to P.329 for ordering products not listed.

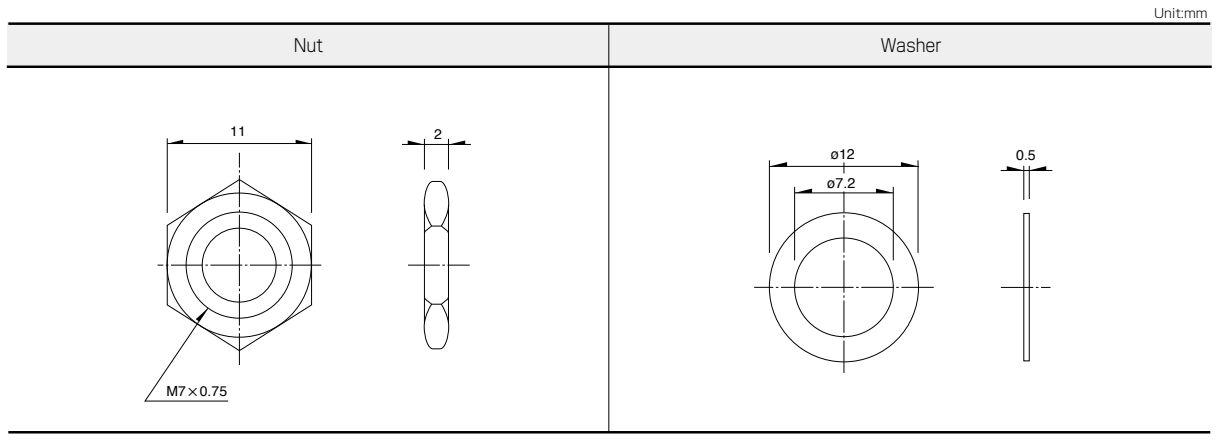
[picture p64: figure]
Nut; Washer; Unit:mm

# 328 Rotary

Potentiometers

Slide

Potentiometers Shaft

Metal Insulated

Shaft

Knob

Operating

Through

Shaft Type Type

Ring

# 16mm Size Metal Shaft Type / Attached Parts

The following parts are included with the product.

Rotary

Potentiometers

Slide

Potentiometers Shaft

Metal Insulated

Shaft

Knob

Operating

Through

Shaft Type Type

Ring

### Sample Part Number

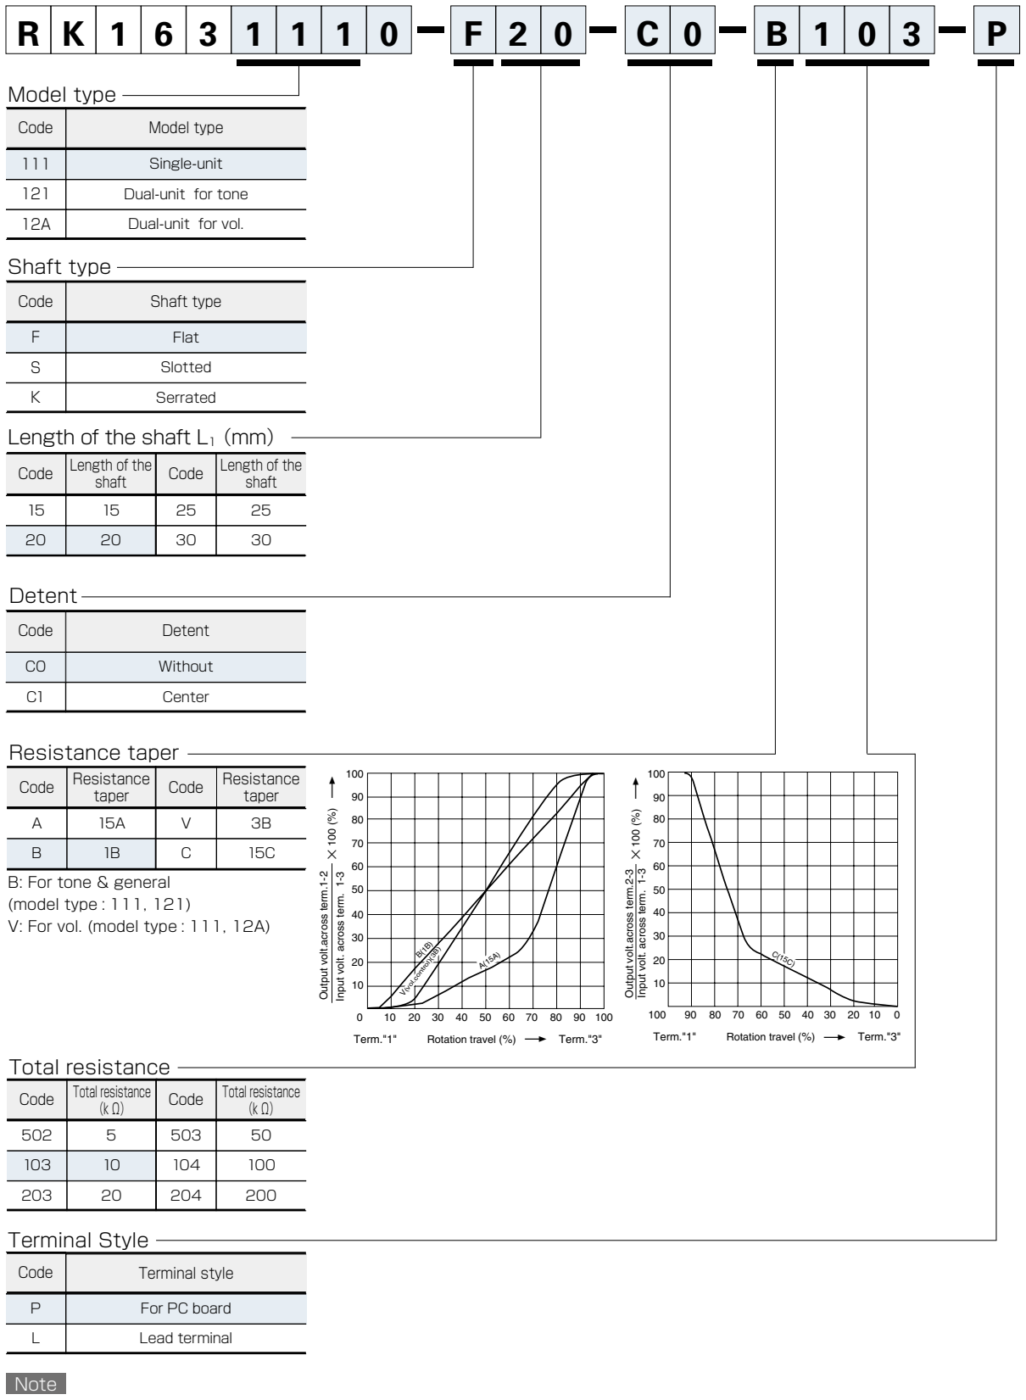
[picture p65: figure]
Detent; Model type; Code; Single-unit; Dual-unit for vol.; Dual-unit for tone; Shaft type; Flat; Slotted; Serrated; Terminal Style; Terminal style; For PC board; Lead terminal; Resistance taper; Resistance taper 15A; Resistance taper 3B; Length of the shaft L1 （mm）; Length of the shaft 15; Length of the shaft 25; Total resistance; Total resistance （k Ω） 5; Total resistance （k Ω） 50; B: For tone & general (model type : 111, 121) V: For vol. (model type : 111, 12A); Note; Output volt.across term.2-3; Input volt. across term. 1-3 100; Term."1"; Rotation travel (%); Term."3"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

Marked are specifications recommended by Alps Alpine.

G 100 (%) J Term."1" Rotation travel (%) J Term."3"

When ordering product varieties that are not listed, specify referring to the examples below.

# 16mm Size Metal Shaft Type / Ordering Products Not Listed

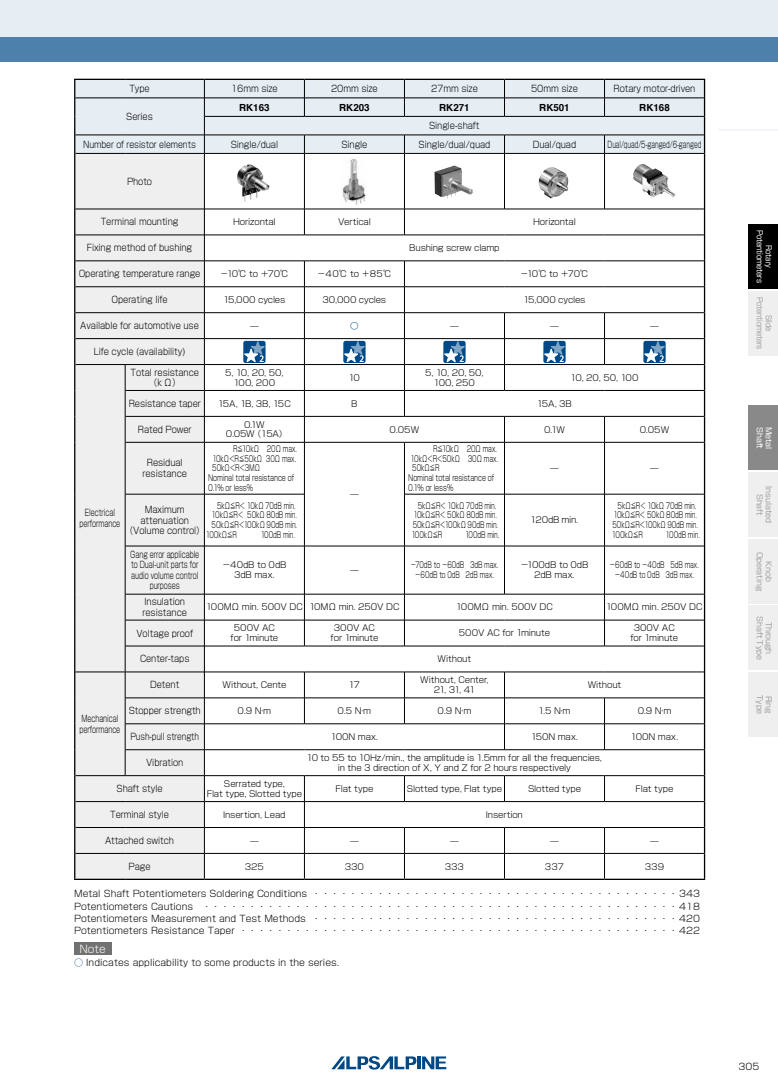
[picture p66: page 6]
Rotary; Potentiometers; Slide; Potentiometers Shaft; Metal Insulated; Shaft; Knob; Operating; Through; Ring; Single-shaft

Type | 16mm size | 20mm size | 27mm size | 50mm size | Rotary motor-driven
Series | RK163 | RK203 | RK271 | RK501 | RK168

Number of resistor elements | Single/dual | Single | Single/dual/quad | Dual/quad | Dual/quad/5-ganged/6-ganged

Photo

Terminal mounting | Horizontal | Vertical | Horizontal

Fixing method of bushing | Bushing screw clamp

Operating temperature range | −10℃ to ＋70℃ | −40℃ to ＋85℃ | −10℃ to ＋70℃

Operating life | 15,000 cycles | 30,000 cycles | 15,000 cycles

Available for automotive use | — | 〇 | — | — | —

Life cycle (availability)
Electrical performance | Total resistance （k Ω） | 5, 10, 20, 50, 100, 200 | 10 | 5, 10, 20, 50, 100, 250 | 10, 20, 50, 100

Resistance taper | 15A, 1B, 3B, 15C | B | 15A, 3B
Rated Power | 0.1W 0.05W （15A） | 0.05W | 0.1W | 0.05W
Residual resistance | R≦10kΩ 20Ω max. 10kΩ＜R≦50kΩ 30Ω max. 50kΩ＜R＜3MΩ Nominal total resistance of 0.1% or less% | — | R≦10kΩ 20Ω max. 10kΩ＜R＜50kΩ 30Ω max. 50kΩ≦R Nominal total resistance of 0.1% or less% | — | —

Maximum attenuation （Volume control） | 5kΩ≦R＜ 10kΩ 70dB min. 10kΩ≦R＜ 50kΩ 80dB min. 50kΩ≦R＜100kΩ 90dB min. 100kΩ≦R 100dB min. | | 5kΩ≦R＜ 10kΩ 70dB min. 10kΩ≦R＜ 50kΩ 80dB min. 50kΩ≦R＜100kΩ 90dB min. 100kΩ≦R 100dB min. | 120dB min. | 5kΩ≦R＜ 10kΩ 70dB min. 10kΩ≦R＜ 50kΩ 80dB min. 50kΩ≦R＜100kΩ 90dB min. 100kΩ≦R 100dB min.

Gang error applicable to Dual-unit parts for audio volume control purposes | −40dB to 0dB 3dB max. | — | −70dB to −60dB　3dB max. −60dB to 0dB　2dB max. | −100dB to 0dB 2dB max. | −60dB to −40dB　5dB max. −40dB to 0dB　3dB max.

Insulation resistance | 100MΩ min. 500V DC | 10MΩ min. 250V DC | 100MΩ min. 500V DC | | 100MΩ min. 250V DC

Voltage proof | 500V AC for 1minute | for 1minute 300V AC | 500V AC for 1minute | | 300V AC for 1minute

Shaft Type Type

Center-taps | Without

Mechanical performance | Detent | Without, Cente | 17 | Without, Center, 21, 31, 41 | Without

Stopper strength | 0.9 N・m | 0.5 N・m | 0.9 N・m | 1.5 N・m | 0.9 N・m

Push-pull strength | 100N max. | | | 150N max. | 100N max.
Vibration | 10 to 55 to 10Hz/min., the amplitude is 1.5mm for all the frequencies, in the 3 direction of X, Y and Z for 2 hours respectively

Shaft style | Serrated type, Flat type, Slotted type | Flat type | Slotted type, Flat type | Slotted type | Flat type

Terminal style | Insertion, Lead | Insertion

Attached switch | — | — | — | — | —

Page | 325 | 330 | 333 | 337 | 339

Metal Shaft Potentiometers Soldering Conditions ・・・・・・・・・・・・・・・・・・・・・・・・・・・・・・・・・・・・・・・・343
Potentiometers Cautions ・・・・・・・・・・・・・・・・・・・・・・・・・・・・・・・・・・・・・・・・・・・・・・・・・・・・418
Potentiometers Measurement and Test Methods ・・・・・・・・・・・・・・・・・・・・・・・・・・・・・・・・・・・・・・・・420
Potentiometers Resistance Taper ・・・・・・・・・・・・・・・・・・・・・・・・・・・・・・・・・・・・・・・・・・・・・・・・422
Note
○ Indicates applicability to some products in the series.

### Reference for Manual Soldering

# Metal Shaft Potentiometers / Soldering Conditions

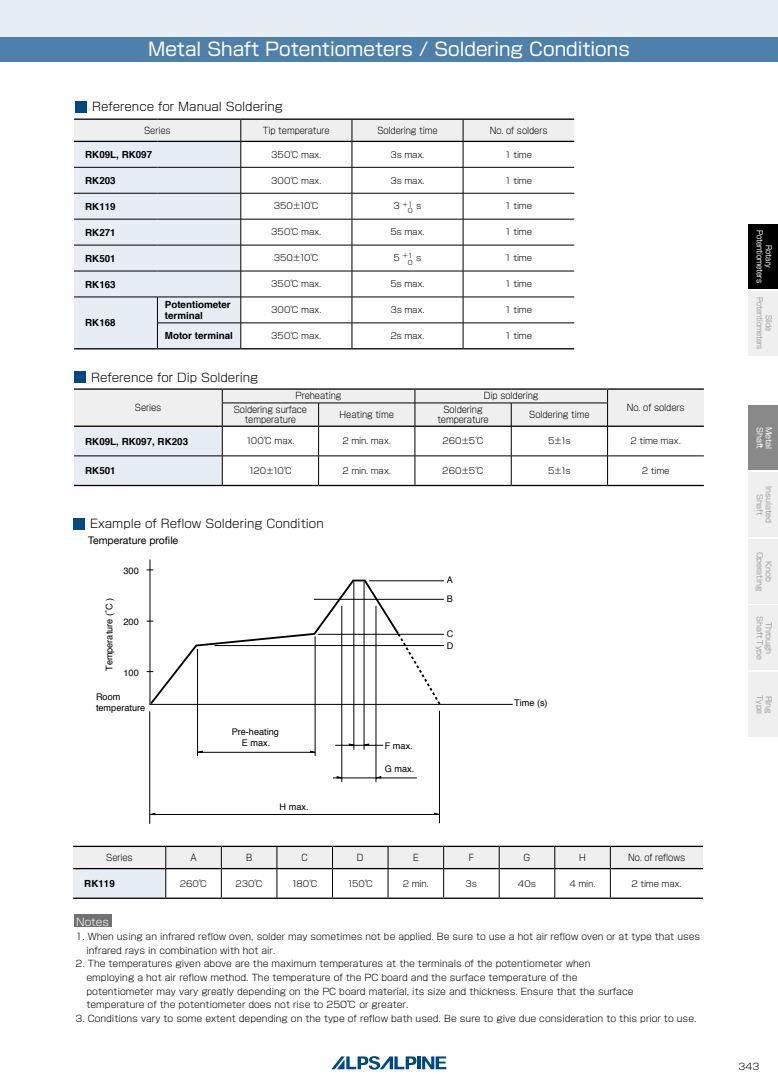
[picture p67: page 7]
Rotary; Potentiometers; Slide; Potentiometers Shaft; Metal Insulated; Shaft; Knob; Operating; Through; Ring; Time (s); G max.; F max.; H max.; E max.; Room; Pre-heating; Series; Tip temperature; Soldering time; No. of solders; 350℃ max.; 3s max.; 1 time; 300℃ max.; 5s max.; Potentiometer; terminal; Motor terminal; 2s max.; 100℃ max.; 2 min. max.; 2 time max.; 2 time; No. of reflows; 2 min.; 4 min.

Reference for Dip Soldering

Series | Preheating | Dip soldering | No. of solders

Soldering surface temperature | Heating time | Soldering temperature | Soldering time

Example of Reflow Soldering Condition
Temperature profile
temperature Temperature ⁽˚C ⁾

Shaft Type Type

Notes
1. When using an infrared reflow oven, solder may sometimes not be applied. Be sure to use a hot air reflow oven or at type that uses
infrared rays in combination with hot air.
2. The temperatures given above are the maximum temperatures at the terminals of the potentiometer when
employing a hot air reflow method. The temperature of the PC board and the surface temperature of the
potentiometer may vary greatly depending on the PC board material, its size and thickness. Ensure that the surface
temperature of the potentiometer does not rise to 250℃ or greater.
3. Conditions vary to some extent depending on the type of reflow bath used. Be sure to give due consideration to this prior to use.
