gligli/overcycler/doc/drw_PT-10.pdf

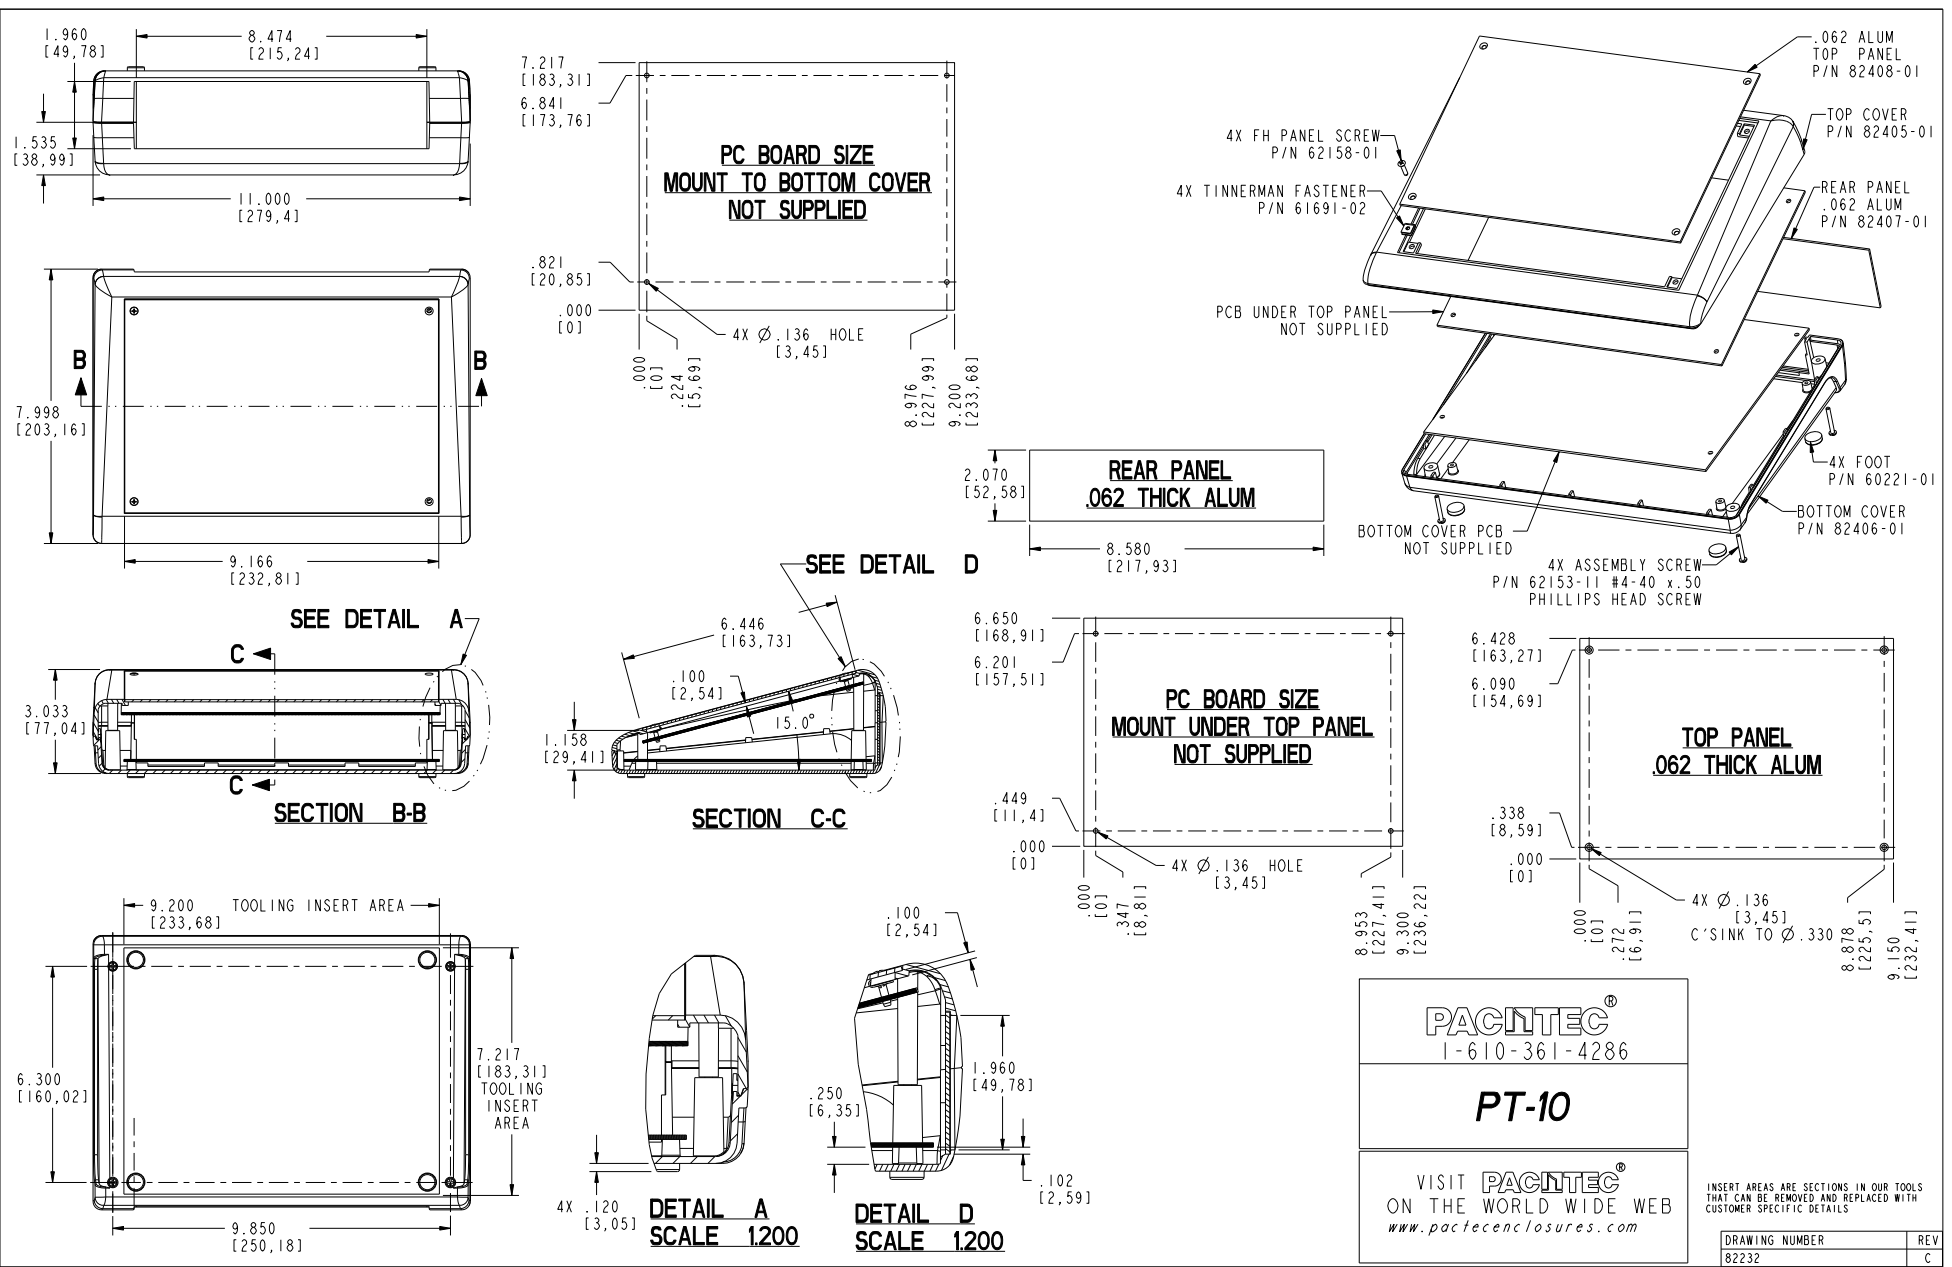
[picture p68: page 1]
