gligli/overcycler/doc/DIN-504-M10.pdf

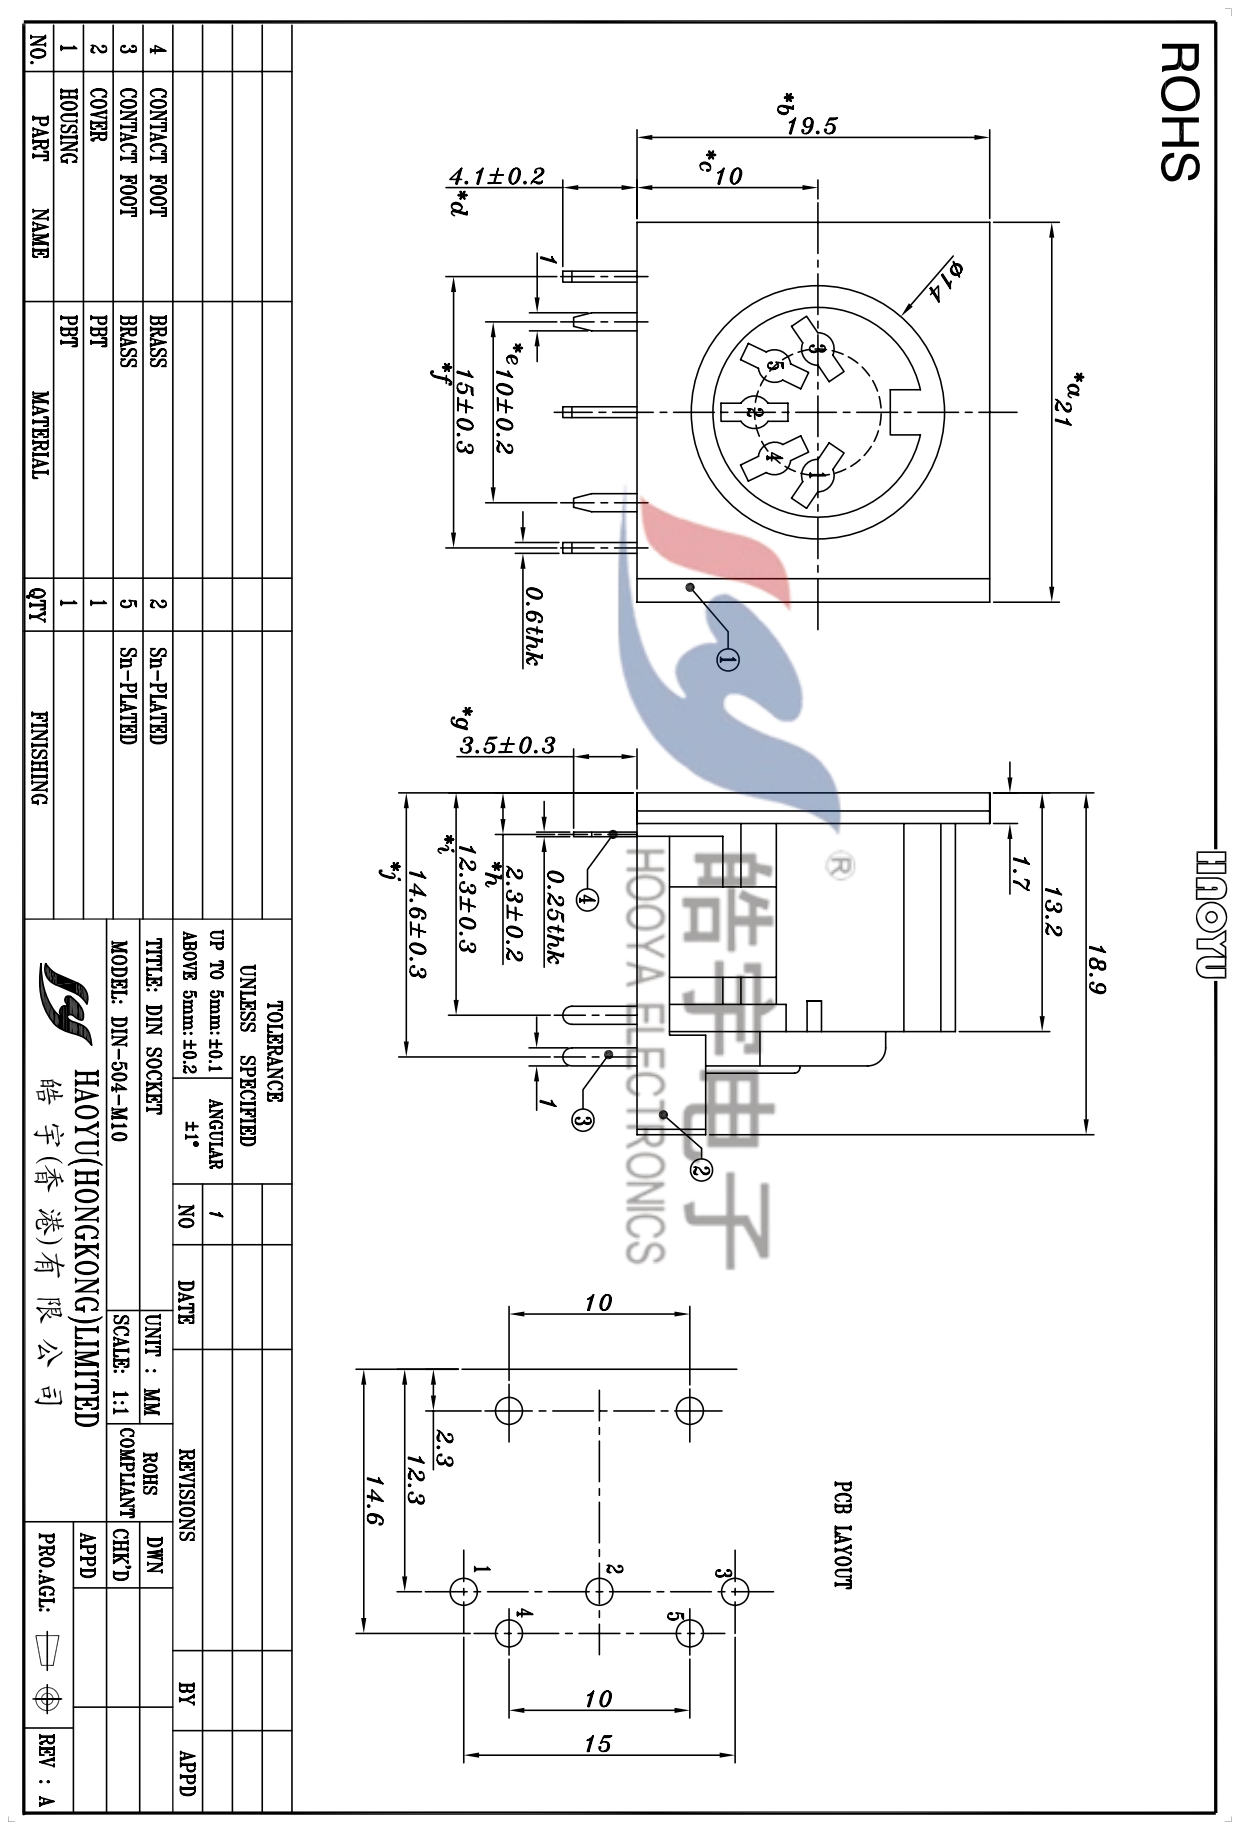
[picture p69: page 1]
