gligli/overcycler/hardware/spice/adcref.asc

C1: cap; 10µ
L1: ind; 10µ
R1: res; 6k
V1: voltage; SINE(3.3 0.15 80000); Rser=2.5
Named nets: 0
.tran 10m
