gligli/overcycler/hardware/spice/out.asc

C1: cap; 100p
C2: cap; 100p
R1: res; 33k
R2: res; 2k2
R3: res; 2k2
R4: res; 47k
R5: res; 47k
R6: res; 47k
R7: res; 120k
R8: res; 56k
R9: res; 82k
R10: res; 82k
R11: res; 56k
R12: res; 120k
R13: res; 47k
R14: res; 33k
R15: res; 10k
R16: res; 10k
R17: res; 1k
R18: res; 1k
R19: res; 330
R20: res; 330
U1: TL072
U2: TL072
U3: TL072
U4: TL072
U5: potentiometer; Rtot=10K wiper=1
U6: potentiometer; Rtot=10K wiper=1
V1: voltage; 5
V2: voltage; 5
V3: voltage; PULSE(-3 3 0 0.0005 0.0005 0 0.0001)
V4: voltage; PULSE(-3 3 0 0.0005 0.0005 0 0.0001)
V5: voltage; PULSE(-3 3 0 0.0005 0.0005 0 0.0001)
V6: voltage; PULSE(-3 3 0 0.0005 0.0005 0 0.0001)
V7: voltage; PULSE(-3 3 0 0.0005 0.0005 0 0.0001)
V8: voltage; PULSE(-3 3 0 0.0005 0.0005 0 0.0001)
Named nets: 0, OUTL, OUTR, ADC_MIX
.tran 0.01
