gligli/overcycler/hardware/spice/vca.asc

C1: cap; 470n
R1: res; 470
R2: res; 470
R3: res; 22k
R4: res; 4k7
R6: res; 10k
R7: res; 820
R8: res; 4k7
U1: LM13700_NS
V1: voltage; 5
V2: voltage; 5
V3: signal; SINE(0 1 10000)
V4: signal; PULSE(0 5 0.05 0.05 0.05 0 0.1)
Named nets: 0, out, mod, in, mid
.tran 0.25
