gligli/overcycler/hardware/spice/vcnoise.asc

B1: bv; V=white(time*100000)*4.2m
C1: cap; 100µ
C2: cap; 100n
C3: cap; 100µ
D1: diode; 1N4148
D2: diode; 1N4148
D3: diode; 1N4148
D4: diode; 1N4148
Q1: BC547B
R1: res; 220k
R2: res; 10k
R3: res; 27k
R4: res; 470
R5: res; 3Meg3
R6: res; 470
R7: res; 10k
R8: res; 10k
R9: res; 100k
R10: res; 4k7
R11: res; 1k
R12: res; 100k
R13: res; 1Meg
R14: res; 10k
U1: TL072
U2: TL072
U3: TL072
U4: TL072
V1: voltage; 5
V2: voltage; 5
V3: voltage; PULSE(0 5 0 0.05 0.05 0 0.1)
V4: voltage; SINE(0 2.1m 10000)
V5: voltage; SINE(175m 0 10000)
Named nets: 0
.tran 0.15
