gligli/overcycler/(list of files, drawings)

Other design files:
hardware/overcycler3.dsn
