gligli/overcycler/enclosure/WH148/WH148.kicad_pcb

## KiCad design enclosure/WH148/WH148.kicad_pcb (2024-08-11)

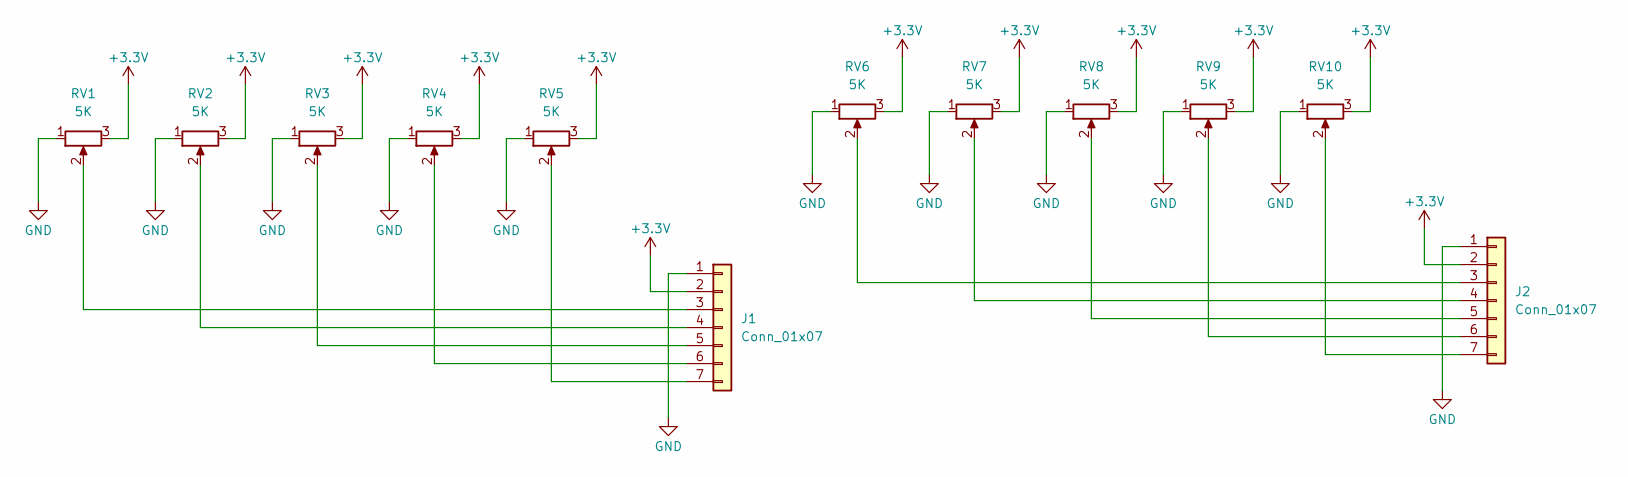
[picture p70: schematic WH148.kicad_sch]

Parts:
J1, J2: Conn_01x07; JST_PH_B7B-PH-K_1x07_P2.00mm_Vertical
RV1, RV2, RV3, RV4, RV5, RV6, RV7, RV8, RV9, RV10: 5K; WH148

Connections:
+3.3V: J1.2, J2.2, RV1.3, RV2.3, RV3.3, RV4.3, RV5.3, RV6.3, RV7.3, RV8.3, RV9.3, RV10.3
GND: J1.1, J2.1, RV1.1, RV2.1, RV3.1, RV4.1, RV5.1, RV6.1, RV7.1, RV8.1, RV9.1, RV10.1
unnamed: J1.3, RV1.2
unnamed: J1.4, RV2.2
unnamed: J1.5, RV3.2
unnamed: J1.6, RV4.2
unnamed: J1.7, RV5.2
unnamed: J2.3, RV6.2
unnamed: J2.4, RV7.2
unnamed: J2.5, RV8.2
unnamed: J2.6, RV9.2
unnamed: J2.7, RV10.2

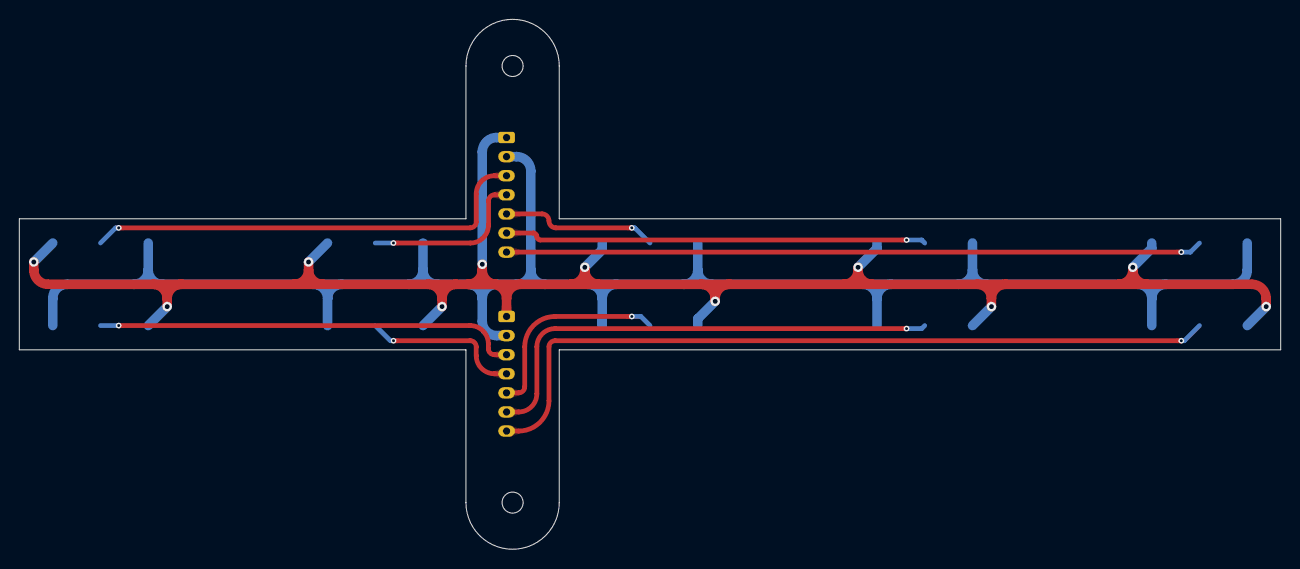
[picture p71: board WH148.kicad_pcb from above]

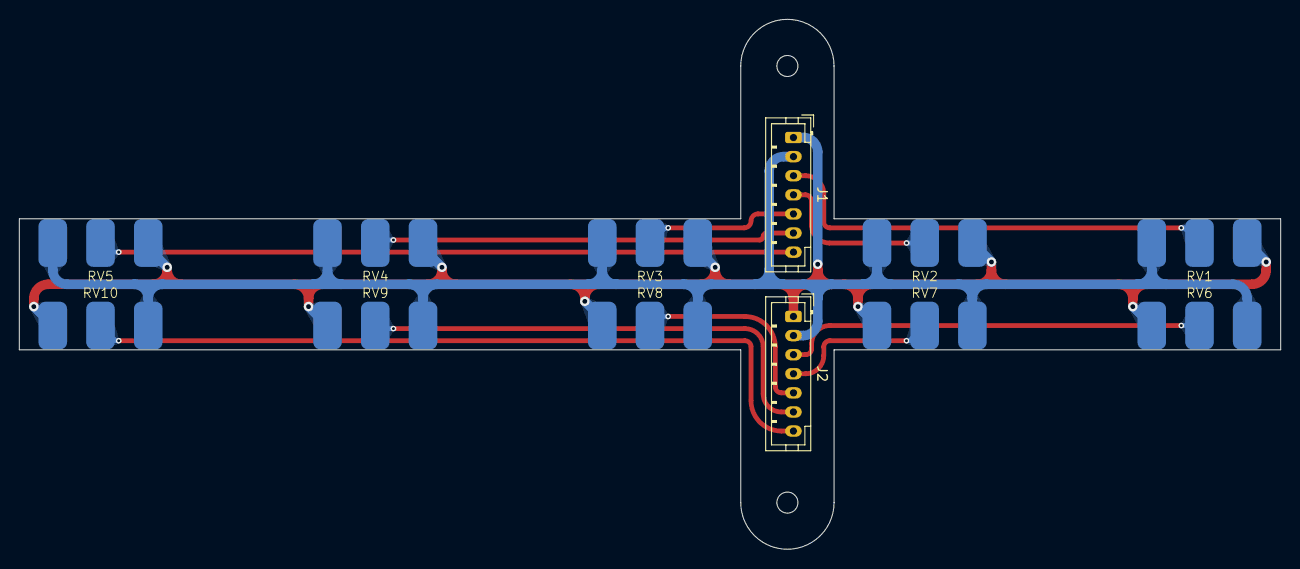
[picture p72: board WH148.kicad_pcb from below]

Board: 2 copper layers, 132.1 x 55.5 mm, 12 parts (12 on the bottom side), 12 nets.
