gligli/overcycler/firmware_17xx/synth/synth.c

///////////////////////////////////////////////////////////////////////////////
// Synthesizer
///////////////////////////////////////////////////////////////////////////////

#include "synth.h"
#include "wtosc.h"
#include "dacspi.h"
#include "scan.h"
#include "ui.h"
#include "uart_midi.h"
#include "midi.h"
#include "adsr.h"
#include "lfo.h"
#include "tuner.h"
#include "assigner.h"
#include "arp.h"
#include "seq.h"
#include "clock.h"
#include "storage.h"
#include "vca_curves.h"
#include "vcnoise_curves.h"
#include "../xnormidi/midi.h"
#include "lpc177x_8x_gpio.h"
#include "lpc177x_8x_pinsel.h"
#include "wave_reader.h"

#define BIT_INPUT_FOOTSWITCH (1<<26)

#define MAX_BANKS 128
#define MAX_BANK_WAVES 256

volatile uint32_t currentTick=0; // 500hz

static struct
{
	int bankCount;
	int curWaveCount;
	char bankNames[MAX_BANKS][MAX_FILENAME];
	char curWaveNames[MAX_BANK_WAVES][MAX_FILENAME];
	
	int8_t bankSorted;
	int8_t curWaveSorted;
	abx_t curWaveABX;
	char curWaveBank[128];
	
	uint16_t sampleData[abxCount][WTOSC_SAMPLE_COUNT];

	DIR curDir;
	FILINFO curFile;
	char lfname[MAX_FILENAME];
} waveData;

static struct
{
	struct wtosc_s osc[SYNTH_VOICE_COUNT][2];
	struct adsr_s filEnvs[SYNTH_VOICE_COUNT];
	struct adsr_s ampEnvs[SYNTH_VOICE_COUNT];
	struct adsr_s wmodEnvs[SYNTH_VOICE_COUNT];
	struct lfo_s lfo[2];
	
	uint16_t oscANoteCV[SYNTH_VOICE_COUNT];
	uint16_t oscBNoteCV[SYNTH_VOICE_COUNT];
	uint16_t filterNoteCV[SYNTH_VOICE_COUNT]; 
	
	uint16_t oscATargetCV[SYNTH_VOICE_COUNT];
	uint16_t oscBTargetCV[SYNTH_VOICE_COUNT];
	uint16_t filterTargetCV[SYNTH_VOICE_COUNT];

	struct
	{
		int16_t benderAmount;
		uint16_t modwheelAmount;
		uint16_t pressureAmount;
		int16_t glideAmount;
		int8_t gliding;

		uint32_t modulationDelayStart;
		uint16_t modulationDelayTickCount;

		syncMode_t syncModeMaster,syncModeSlave;
		int16_t syncPositions[DACSPI_BUFFER_COUNT/2];
	} partState;
} synth;

extern const uint16_t attackCurveLookup[]; // for modulation delay

const uint16_t extClockDividers[16] = {192,168,144,128,96,72,48,36,24,18,12,9,6,4,3,2};

const uint8_t abx2bsp[abxCount] = {spABank_Unsaved, spBBank_Unsaved, spAXOvrBank_Unsaved, spBXOvrBank_Unsaved};
const uint8_t abx2wsp[abxCount] = {spAWave_Unsaved, spBWave_Unsaved, spAXOvrWave_Unsaved, spBXOvrWave_Unsaved};

const abx_t sp2abx[spCount] = 
{
	/*ABank*/abxAMain,
	/*AWave*/abxAMain,
	
	/*ABaseWMod*/abxNone,/*AFilWMod*/abxNone,
	
	/*BBank*/abxBMain,
	/*BWave*/abxBMain,
	
	/*BBaseWMod*/abxNone,/*BWFilMod*/abxNone,/*LFOShape*/abxNone,/*LFOShift*/abxNone,/*LFOTargets*/abxNone,
	/*FilEnvSlow*/abxNone,/*AmpEnvSlow*/abxNone,/*BenderRange*/abxNone,	/*BenderTarget*/abxNone,
	/*ModwheelRange*/abxNone,/*ModwheelTarget*/abxNone,/*Unison*/abxNone,/*AssignerPriority*/abxNone,
	/*ChromaticPitch*/abxNone,/*Sync*/abxNone,
	
	/*AXOvrBank*/abxACrossover,
	/*AXOvrWave*/abxACrossover,
	
	/*FilEnvLin*/abxNone,/*LFO2Shape*/abxNone,/*LFO2Shift*/abxNone,/*LFO2Targets*/abxNone,/*VoiceCount*/abxNone,
	/*PresetType*/abxNone,/*PresetStyle*/abxNone,/*AmpEnvLin*/abxNone,/*FilEnvLoop*/abxNone,/*AmpEnvLoop*/abxNone,
	/*WModEnvSlow*/abxNone,/*WModEnvLin*/abxNone,/*WModEnvLoop*/abxNone,/*PressureRange*/abxNone,/*PressureTarget*/abxNone,
	
	/*BXOvrBank*/abxBCrossover,
	/*BXOvrWave*/abxBCrossover,
};

const char * notesNames[12]=
{
	"C ","C#","D ","Eb","E ","F ","F#","G ","G#","A ","Bb","B "
};

////////////////////////////////////////////////////////////////////////////////
// Non speed critical internal code
////////////////////////////////////////////////////////////////////////////////

static int32_t getStaticCV(cv_t cv)
{
	static const modulationTarget_t cv2mod[cvCount]={modVolume,modVolume,modFilter,modNone,modPitch,modPitch,modWaveMod,modNone,modVolume};
	modulationTarget_t mod=cv2mod[cv];
	int32_t res=0;
	
	if(mod!=modNone)
	{
		if(currentPreset.steppedParameters[spBenderTarget]==mod)
			res+=synth.partState.benderAmount;
		if(currentPreset.steppedParameters[spPressureTarget]==mod)
			res+=(int32_t)synth.partState.pressureAmount*(mod==modPitch?-1:1); // pressure to pitch goes downwards
	}
	
	return __SSAT(res,16);
}

static void handleFinishedVoices(void)
{
	int8_t v;
	
	for(v=0;v<SYNTH_VOICE_COUNT;++v)
	{
		// when amp env finishes, voice is done
		if(assigner_getAssignment(v,NULL) && adsr_getStage(&synth.ampEnvs[v])==sWait)
			assigner_voiceDone(v);
	
		// if voice isn't assigned, silence it
		if(!assigner_getAssignment(v,NULL) && adsr_getStage(&synth.ampEnvs[v])!=sWait)
		{
			adsr_reset(&synth.ampEnvs[v]);
			adsr_reset(&synth.filEnvs[v]);
			adsr_reset(&synth.wmodEnvs[v]);
		}
	}
}

static void refreshTunedCVs(void)
{
	uint16_t cva,cvb,cvf;
	uint8_t note,baseCutoffNote,baseANote,baseBNote,trackingNote;
	int8_t v;

	uint16_t baseAPitch,baseBPitch,baseCutoff;
	int16_t mTune,detune,unisonDetune;

	uint16_t baseCutoffRaw,mTuneRaw,detuneRaw,unisonDetuneRaw,trackRaw;
	uint8_t chrom;
	
	int32_t add;
	
	// get raw values

	mTuneRaw=currentPreset.continuousParameters[cpMasterTune];
	detuneRaw=currentPreset.continuousParameters[cpDetune];
	baseCutoffRaw=currentPreset.continuousParameters[cpCutoff];
	baseAPitch=currentPreset.continuousParameters[cpAFreq]>>2;
	baseBPitch=currentPreset.continuousParameters[cpBFreq]>>2;
	unisonDetuneRaw=currentPreset.continuousParameters[cpUnisonDetune];
	trackRaw=currentPreset.continuousParameters[cpFilKbdAmt];
	chrom=currentPreset.steppedParameters[spChromaticPitch];

	// compute for oscs & filters

	mTune=(mTuneRaw>>7)+INT8_MIN*2;
	detune=(detuneRaw>>8)+INT8_MIN;
	baseCutoff=((uint32_t)baseCutoffRaw*144)>>8; // tuning in C

	baseCutoffNote=baseCutoff>>8;
	baseANote=baseAPitch>>8; // 64 semitones
	baseBNote=baseBPitch>>8;

	baseCutoff&=0xff;

	if(chrom>0)
	{
		baseAPitch=0;
		baseBPitch=0;

		if(chrom>1)
		{
			baseANote-=baseANote%12;
			baseBNote-=baseBNote%12;
		}
	}
	else
	{
		baseAPitch&=0xff;
		baseBPitch&=0xff;
	}

	for(v=0;v<SYNTH_VOICE_COUNT;++v)
	{
		if(!assigner_getAssignment(v,&note))
			continue;
		
		// oscs
		
		add=getStaticCV(cvAPitch)+mTune-(detune>>1);
		cva=satAddU16S32(tuner_computeCVFromNote(v,baseANote+note,baseAPitch,cvAPitch),add);
		
		add=getStaticCV(cvBPitch)+mTune+(detune>>1);
		cvb=satAddU16S32(tuner_computeCVFromNote(v,baseBNote+note,baseBPitch,cvBPitch),add);
		
		unisonDetune=(1+(v>>1))*(v&1?-1:1)*(unisonDetuneRaw>>9);
		cva=satAddU16S16(cva,unisonDetune);
		cvb=satAddU16S16(cvb,unisonDetune);
		
		// filter
		
		trackingNote=MAX(0,baseCutoffNote+((((int8_t)note-MIDDLE_C_NOTE)*(trackRaw>>8))>>8));
			
		add=getStaticCV(cvCutoff);
		cvf=satAddU16S32(tuner_computeCVFromNote(v,trackingNote,baseCutoff,cvCutoff),add);
		
		// glide
		
		if(synth.partState.gliding)
		{
			synth.oscATargetCV[v]=cva;
			synth.oscBTargetCV[v]=cvb;
			synth.filterTargetCV[v]=cvf;

			if(trackRaw<SCAN_POT_DEAD_ZONE)
				synth.filterNoteCV[v]=cvf; // no glide if no tracking for filter
		}
		else			
		{
			synth.oscANoteCV[v]=cva;
			synth.oscBNoteCV[v]=cvb;
			synth.filterNoteCV[v]=cvf;
		}
				
	}
}

static void refreshAssignerSettings(void)
{
	static const uint8_t vc2msk[7]={1,3,7,15,31,63};
 
	assigner_setPattern(currentPreset.voicePattern,currentPreset.steppedParameters[spUnison]);
	assigner_setPriority(currentPreset.steppedParameters[spAssignerPriority]);
	assigner_setVoiceMask(vc2msk[currentPreset.steppedParameters[spVoiceCount]]&settings.voiceMask);
}

static void refreshEnvSettings(int8_t type)
{
	uint16_t atk,dec,sus,rel;
	int8_t slow,lin,loop;
	int8_t i;
	struct adsr_s * a;
		
	for(i=0;i<SYNTH_VOICE_COUNT;++i)
	{
		switch(type)
		{
		case 0:
			a=&synth.ampEnvs[i];
			slow=currentPreset.steppedParameters[spAmpEnvSlow];
			lin=currentPreset.steppedParameters[spAmpEnvLin];
			loop=currentPreset.steppedParameters[spAmpEnvLoop];

			atk=currentPreset.continuousParameters[cpAmpAtt];
			dec=currentPreset.continuousParameters[cpAmpDec];
			sus=currentPreset.continuousParameters[cpAmpSus];
			rel=currentPreset.continuousParameters[cpAmpRel];
			break;
		case 1:
			a=&synth.filEnvs[i];
			slow=currentPreset.steppedParameters[spFilEnvSlow];
			lin=currentPreset.steppedParameters[spFilEnvLin];
			loop=currentPreset.steppedParameters[spFilEnvLoop];

			atk=currentPreset.continuousParameters[cpFilAtt];
			dec=currentPreset.continuousParameters[cpFilDec];
			sus=currentPreset.continuousParameters[cpFilSus];
			rel=currentPreset.continuousParameters[cpFilRel];
			break;
		case 2:
			a=&synth.wmodEnvs[i];
			slow=currentPreset.steppedParameters[spWModEnvSlow];
			lin=currentPreset.steppedParameters[spWModEnvLin];
			loop=currentPreset.steppedParameters[spWModEnvLoop];

			atk=currentPreset.continuousParameters[cpWModAtt];
			dec=currentPreset.continuousParameters[cpWModDec];
			sus=currentPreset.continuousParameters[cpWModSus];
			rel=currentPreset.continuousParameters[cpWModRel];
			break;
		default:
			return;
		}
		
		adsr_setSpeedShift(a,(slow)?4:2);
		adsr_setShape(a,(lin)?0:1,loop);
		adsr_setCVs(a,atk,dec,sus,rel,0,0x0f);
	}
}

static void refreshLfoSettings(void)
{
	static const uint8_t lt2per[] = {0,0,1,2,4,8,16};
	uint16_t lfoAmt,lfo2Amt,dlyAmt;
	uint32_t elapsed;

	lfo_setShape(&synth.lfo[0],currentPreset.steppedParameters[spLFOShape],lt2per[currentPreset.steppedParameters[spLFOTrig]]);
	lfo_setShape(&synth.lfo[1],currentPreset.steppedParameters[spLFO2Shape],lt2per[currentPreset.steppedParameters[spLFO2Trig]]);
	
	lfo_setSpeedShift(&synth.lfo[0],currentPreset.steppedParameters[spLFOSpeed]);
	lfo_setSpeedShift(&synth.lfo[1],currentPreset.steppedParameters[spLFO2Speed]);

	// wait modulationDelayTickCount then progressively increase over
	// modulationDelayTickCount time, following an exponential curve
	dlyAmt=0;
	if(synth.partState.modulationDelayStart!=UINT32_MAX)
	{
		if(currentPreset.continuousParameters[cpModDelay]<SCAN_POT_DEAD_ZONE)
		{
			dlyAmt=UINT16_MAX;
		}
		else if(currentTick>=synth.partState.modulationDelayStart+synth.partState.modulationDelayTickCount)
		{
			elapsed=currentTick-(synth.partState.modulationDelayStart+synth.partState.modulationDelayTickCount);
			if(elapsed>=synth.partState.modulationDelayTickCount)
				dlyAmt=UINT16_MAX;
			else
				dlyAmt=attackCurveLookup[(elapsed<<8)/synth.partState.modulationDelayTickCount];
		}
	}

	lfoAmt=currentPreset.continuousParameters[cpLFOAmt];
	if(currentPreset.steppedParameters[spPressureTarget]==modLFO1)
		lfoAmt=satAddU16U16(lfoAmt,synth.partState.pressureAmount);

	lfo2Amt=currentPreset.continuousParameters[cpLFO2Amt];
	if(currentPreset.steppedParameters[spPressureTarget]==modLFO2)
		lfo2Amt=satAddU16U16(lfo2Amt,synth.partState.pressureAmount);

	if(currentPreset.steppedParameters[spModwheelTarget]==0) // targeting lfo1?
	{
		lfo_setCVs(&synth.lfo[0],
				currentPreset.continuousParameters[cpLFOFreq],
				satAddU16U16(lfoAmt,synth.partState.modwheelAmount));
		lfo_setCVs(&synth.lfo[1],
				 currentPreset.continuousParameters[cpLFO2Freq],
				 scaleU16U16(lfo2Amt,dlyAmt));
	}
	else
	{
		lfo_setCVs(&synth.lfo[0],
				currentPreset.continuousParameters[cpLFOFreq],
				scaleU16U16(lfoAmt,dlyAmt));
		lfo_setCVs(&synth.lfo[1],
				currentPreset.continuousParameters[cpLFO2Freq],
				satAddU16U16(lfo2Amt,synth.partState.modwheelAmount));
	}
}

static void refreshModulationDelay(int8_t refreshTickCount)
{
	int8_t anyPressed, anyAssigned;
	static int8_t prevAnyPressed=0;
	
	anyPressed=assigner_getAnyPressed();	
	anyAssigned=assigner_getAnyAssigned();	

	if(!anyAssigned)
	{
		synth.partState.modulationDelayStart=UINT32_MAX;
	}

	if(anyPressed && !prevAnyPressed)
	{
		synth.partState.modulationDelayStart=currentTick;
	}

	prevAnyPressed=anyPressed;

	if(refreshTickCount)
		synth.partState.modulationDelayTickCount=exponentialCourse(UINT16_MAX-currentPreset.continuousParameters[cpModDelay],12000.0f,2500.0f);
}

static void refreshMisc(void)
{
	// clock

	clock_updateSpeed();

	// glide

	synth.partState.glideAmount=exponentialCourse(currentPreset.continuousParameters[cpGlide],11000.0f,2100.0f);
	synth.partState.gliding=synth.partState.glideAmount<2000;

	// waveforms
	
	for(int i=0;i<SYNTH_VOICE_COUNT;++i)
	{
		if (currentPreset.continuousParameters[cpAVol]>SCAN_POT_DEAD_ZONE)
			wtosc_setSampleData(&synth.osc[i][0],waveData.sampleData[abxAMain],waveData.sampleData[abxACrossover]);
		else
			wtosc_setSampleData(&synth.osc[i][0],NULL,NULL);
			
		if (currentPreset.continuousParameters[cpBVol]>SCAN_POT_DEAD_ZONE)
			wtosc_setSampleData(&synth.osc[i][1],waveData.sampleData[abxBMain],waveData.sampleData[abxBCrossover]);
		else
			wtosc_setSampleData(&synth.osc[i][1],NULL,NULL);
	}
}

static void handleBitInputs(void)
{
	uint32_t cur;
	static uint32_t last=0;
	
	cur=GPIO_ReadValue(3);
	
	// control footswitch 
	 
	if(arp_getMode()==amOff && currentPreset.steppedParameters[spUnison] && !(cur&BIT_INPUT_FOOTSWITCH) && last&BIT_INPUT_FOOTSWITCH)
	{
		assigner_latchPattern();
		assigner_getPattern( currentPreset.voicePattern,NULL);
	}
	else if((cur&BIT_INPUT_FOOTSWITCH)!=(last&BIT_INPUT_FOOTSWITCH))
	{
		if(arp_getMode()!=amOff)
		{
			arp_setMode(arp_getMode(),(cur&BIT_INPUT_FOOTSWITCH)?0:1);
		}
		else
		{
			assigner_holdEvent((cur&BIT_INPUT_FOOTSWITCH)?0:1);
		}
	}

	// this must stay last
	
	last=cur;
}

void synth_refreshFullState(int8_t refreshWaveforms)
{
	if(refreshWaveforms)
		for(abx_t abx=0;abx<abxCount;++abx)
			synth_refreshWaveforms(abx);
	
	refreshModulationDelay(1);
	refreshAssignerSettings();
	refreshLfoSettings();
	refreshEnvSettings(0);
	refreshEnvSettings(1);
	refreshEnvSettings(2);
	refreshMisc();
	refreshTunedCVs();
}

int32_t synth_getVisualEnvelope(int8_t voice)
{
	if(assigner_getAssignment(voice,NULL))
		return synth.ampEnvs[voice].output;
	else
		return -1;
}

uint16_t * synth_getWaveformData(abx_t abx)
{
	return &waveData.sampleData[abx][0];
}

int synth_getBankCount(void)
{
	return waveData.bankCount;
}

int synth_getCurWaveCount(void)
{
	return waveData.curWaveCount;
}

int8_t synth_getBankName(int bankIndex, char * res)
{
	if(bankIndex<0 || bankIndex>=waveData.bankCount)
	{
		res[0]=0;
		return 0;
	}
	
	strcpy(res,waveData.bankNames[bankIndex]);
	return 1;
}

int8_t synth_getWaveName(int waveIndex, char * res)
{
	if(waveIndex<0 || waveIndex>=waveData.curWaveCount)
	{
		res[0]=0;
		return 0;
	}
	
	strcpy(res,waveData.curWaveNames[waveIndex]);
	return 1;
}

int8_t synth_refreshBankNames(int8_t sort, int8_t force)
{
	FRESULT res;
	
	if(waveData.bankSorted==sort && !force) // already loaded and same state
		return 1;
	
	waveData.bankCount=0;

	if((res=f_opendir(&waveData.curDir,SYNTH_WAVEDATA_PATH)))
	{
		rprintf(0,"f_opendir res=%d\n",res);
		return 0;
	}

	if((res=f_readdir(&waveData.curDir,&waveData.curFile)))
		rprintf(0,"f_readdir res=%d\n",res);

	while(!res)
	{
		if(strcmp(waveData.curFile.fname,".") && strcmp(waveData.curFile.fname,".."))
		{
			if(strlen(waveData.curFile.lfname))
				strncpy(waveData.bankNames[waveData.bankCount],waveData.curFile.lfname,MAX_FILENAME);
			else
				strncpy(waveData.bankNames[waveData.bankCount],waveData.curFile.fname,MAX_FILENAME);
			
			++waveData.bankCount;
		}
		
		res=f_readdir(&waveData.curDir,&waveData.curFile);
		if (!waveData.curFile.fname[0] || waveData.bankCount>=MAX_BANKS)
			break;
	}
	
	if(sort)
		qsort(waveData.bankNames,waveData.bankCount,sizeof(waveData.bankNames[0]),stringCompare);
	
	waveData.bankSorted=sort;
	
#ifdef DEBUG
	rprintf(0,"bankCount %d\n",waveData.bankCount);
#endif		
	
	return 1;
}

void synth_refreshCurWaveNames(abx_t abx, int8_t sort)
{
	FRESULT res;
	char fn[128];
	
	strcpy(fn,SYNTH_WAVEDATA_PATH "/");
	strcat(fn,currentPreset.oscBank[abx]);
	
	if(!strcmp(waveData.curWaveBank,fn) && waveData.curWaveSorted==sort && waveData.curWaveABX==abx) // already loaded and same state
		return;
	
	waveData.curWaveCount=0;

#ifdef DEBUG
	rprintf(0,"loading %s\n",fn);
#endif		
	
	if((res=f_opendir(&waveData.curDir,fn)))
	{
		rprintf(0,"f_opendir res=%d\n",res);
		return;
	}

	if((res=f_readdir(&waveData.curDir,&waveData.curFile)))
		rprintf(0,"f_readdir res=%d\n",res);

	while(!res)
	{
		if(strstr(waveData.curFile.fname,".WAV") || strstr(waveData.curFile.fname,".wav"))
		{
			if(strlen(waveData.curFile.lfname))
				strncpy(waveData.curWaveNames[waveData.curWaveCount],waveData.curFile.lfname,MAX_FILENAME);
			else
				strncpy(waveData.curWaveNames[waveData.curWaveCount],waveData.curFile.fname,MAX_FILENAME);
			
			++waveData.curWaveCount;
		}
		
		res=f_readdir(&waveData.curDir,&waveData.curFile);
		if (!waveData.curFile.fname[0] || waveData.curWaveCount>=MAX_BANK_WAVES)
			break;
	}

	if(sort)
		qsort(waveData.curWaveNames,waveData.curWaveCount,sizeof(waveData.curWaveNames[0]),stringCompare);

	waveData.curWaveSorted=sort;
	waveData.curWaveABX=abx;
	strcpy(waveData.curWaveBank,fn);

#ifdef DEBUG
	rprintf(0,"curWaveCount %d %d\n",abx,waveData.curWaveCount);
#endif		
}

void synth_refreshWaveforms(abx_t abx)
{
	int i, chanOffset,bankNum,waveNum;
	char fn[256];
	wave_reader wr;
	int32_t d;
	int32_t smpCnt=0, chanCnt=0;
	int16_t data[WTOSC_SAMPLE_COUNT];
	
	strcpy(fn,SYNTH_WAVEDATA_PATH "/");
	strcat(fn,currentPreset.oscBank[abx]);
	strcat(fn,"/");
	strcat(fn,currentPreset.oscWave[abx]);

#ifdef DEBUG
	rprintf(0,"loading %s\n",fn);
#endif		
	
	if(wave_reader_open(fn,&wr)==WR_NO_ERROR)
	{
		if(wave_reader_get_format(&wr)==1 && wave_reader_get_sample_bits(&wr)==16) // linear 16Bits PCM
		{
			smpCnt=wave_reader_get_num_samples(&wr);
			smpCnt=MIN(smpCnt,WTOSC_SAMPLE_COUNT);
		}
	
		chanCnt=wave_reader_get_num_channels(&wr);
		
		wave_reader_get_samples(&wr,smpCnt,data);
		wave_reader_close(&wr);
		
#ifdef DEBUG
		rprintf(0,"smpCnt %d chanCnt %d\n",smpCnt,chanCnt);
#endif		
		
		smpCnt/=chanCnt; // we want only one channel
		chanOffset=(chanCnt>1 && abx>=abxACrossover)?1:0;

		for(i=0;i<smpCnt;++i)
		{
			d=data[i*chanCnt+chanOffset];
			d=(d*(INT16_MAX-WTOSC_SAMPLES_GUARD_BAND))>>15;
			d-=INT16_MIN;
			data[i]=d;
		}
		
		resample(data,waveData.sampleData[abx],smpCnt,WTOSC_SAMPLE_COUNT);
	}
	
	// also recompute bank/wave indexes

	bankNum=0;
	synth_refreshBankNames(1,0);
	for(i=0;i<synth_getBankCount();++i)
		if(!strcmp(currentPreset.oscBank[abx],waveData.bankNames[i]))
		{
			bankNum=i;
			break;
		}

	waveNum=0;
	synth_refreshCurWaveNames(abx,1);
	for(i=0;i<synth_getCurWaveCount();++i)
		if(!strcmp(currentPreset.oscWave[abx],waveData.curWaveNames[i]))
		{
			waveNum=i;
			break;
		}

	currentPreset.steppedParameters[abx2bsp[abx]]=bankNum;
	currentPreset.steppedParameters[abx2wsp[abx]]=waveNum;
}	

void synth_updateAssignerPattern(void)
{
	if(currentPreset.steppedParameters[spUnison])
		assigner_latchPattern();
	else
		assigner_setPoly();

	assigner_getPattern(currentPreset.voicePattern,NULL);
}

void synth_silenceSynth(void)
{
	// temporarily silence voices
	for(int8_t v=0;v<SYNTH_VOICE_COUNT;++v)
		synth_refreshCV(v,cvAmp,0,1);
	
	assigner_setVoiceMask(0);
	handleFinishedVoices();
}

////////////////////////////////////////////////////////////////////////////////
// Speed critical internal code
////////////////////////////////////////////////////////////////////////////////

static inline void computeGlide(uint16_t * out, const uint16_t target, const uint16_t amount)
{
	uint16_t diff;
	
	if(*out<target)
	{
		diff=target-*out;
		*out+=MIN(amount,diff);
	}
	else if(*out>target)
	{
		diff=*out-target;
		*out-=MIN(amount,diff);
	}
}

static FORCEINLINE uint16_t adjustCV(cv_t cv, uint32_t value)
{
	uint32_t phase;
	
	switch(cv)
	{
	case cvCutoff:
		value=UINT16_MAX-value;
		break;
	case cvAmp:
		phase=value<<8;
		value=computeShape(phase,vcaLinearizationCurve,2);
		break;
	case cvNoiseVol:
		phase=value<<8;
		value=computeShape(phase,vcNoiseLinearizationCurve,1);
		break;
	default:
		/* nothing */;
	}
	
	return value;
}

FORCEINLINE void synth_refreshCV(int8_t voice, cv_t cv, uint32_t value, int8_t noDblBuf)
{
	static const uint8_t ampVoice2CV[SYNTH_VOICE_COUNT]={0,1,2,3,8,9};
	static const uint8_t cutoffVoice2CV[SYNTH_VOICE_COUNT]={4,15,14,13,12,11};
	uint16_t v,channel;
	
	value=__USAT(value,16);
	v=adjustCV(cv,value);

	switch(cv)
	{
	case cvAmp:
		channel=ampVoice2CV[voice];
		break;
	case cvNoiseVol:
		channel=10;
		break;
	case cvResonance:
		channel=5;
		break;
	case cvCutoff:
		channel=cutoffVoice2CV[voice];
		break;
	case cvAVol:
		channel=6;
		break;
	case cvBVol:
		channel=7;
		break;
	default:
		return;
	}
	
	dacspi_setCVValue(channel,v,noDblBuf);
}

static FORCEINLINE void refreshVoice(int8_t v,int32_t wmodAEnvAmt,int32_t wmodBEnvAmt,int32_t filEnvAmt,int32_t pitchAVal,int32_t pitchBVal,int32_t wmodAVal,int32_t wmodBVal,int32_t filterVal,int32_t ampVal)
{
	int32_t vpa,vpb,vma,vmb,vf,vamp;

	// envs

	adsr_update(&synth.ampEnvs[v]);
	adsr_update(&synth.filEnvs[v]);
	adsr_update(&synth.wmodEnvs[v]);

	// filter

	vf=filterVal;
	vf+=scaleU16S16(synth.filEnvs[v].output,filEnvAmt);
	vf+=synth.filterNoteCV[v];
	synth_refreshCV(v,cvCutoff,vf,0);

	// oscs
	
	vma=wmodAVal;
	vma+=scaleU16S16(synth.wmodEnvs[v].output,wmodAEnvAmt);
	vma=__USAT(vma,16);

	vmb=wmodBVal;
	vmb+=scaleU16S16(synth.wmodEnvs[v].output,wmodBEnvAmt);
	vmb=__USAT(vmb,16);

	vpa=pitchAVal;
	if(currentPreset.steppedParameters[spAWModType]==wmFrequency)
		vpa+=vma-HALF_RANGE;

	vpb=pitchBVal;
	if(currentPreset.steppedParameters[spBWModType]==wmFrequency)
		vpb+=vmb-HALF_RANGE;

	// osc A

	vpa+=synth.oscANoteCV[v];
	vpa=__USAT(vpa,16);
	wtosc_setParameters(&synth.osc[v][0],vpa,currentPreset.steppedParameters[spAWModType],vma);

	// osc B

	vpb+=synth.oscBNoteCV[v];
	vpb=__USAT(vpb,16);
	wtosc_setParameters(&synth.osc[v][1],vpb,currentPreset.steppedParameters[spBWModType],vmb);

	// amplifier
	
	vamp=scaleU16U16(synth.ampEnvs[v].output,ampVal);
	synth_refreshCV(v,cvAmp,vamp,0);
}

////////////////////////////////////////////////////////////////////////////////
// Synth main code
////////////////////////////////////////////////////////////////////////////////

void synth_init(void)
{
	int i;
	
	srandom(0x42381337);

	memset(&synth,0,sizeof(synth));
	memset(&waveData,0,sizeof(waveData));
	for(i=0;i<DACSPI_BUFFER_COUNT/2;++i)
		synth.partState.syncPositions[i]=INT16_MIN;
	waveData.bankSorted=-1;
	waveData.curWaveSorted=-1;
	waveData.curWaveABX=-1;

	// init footswitch in

	GPIO_SetDir(3,1<<26,0);
	PINSEL_SetPinMode(3,26,PINSEL_BASICMODE_PLAINOUT);
	PINSEL_SetOpenDrainMode(3,26,DISABLE);
	
	// init wavetable oscs
	for(i=0;i<SYNTH_VOICE_COUNT;++i)
	{
		wtosc_init(&synth.osc[i][0],i*2);
		wtosc_init(&synth.osc[i][1],i*2+1);
	}

	// give it some memory
	waveData.curFile.lfname=waveData.lfname;
	waveData.curFile.lfsize=sizeof(waveData.lfname);

	// init subsystems
	// ui_init() done in main.c
	dacspi_init();
	scan_init();
	tuner_init();
	assigner_init();
	uartMidi_init();
	seq_init();
	arp_init();
	midi_init();
	clock_init();
	
	for(i=0;i<SYNTH_VOICE_COUNT;++i)
	{
		adsr_init(&synth.ampEnvs[i]);
		adsr_init(&synth.filEnvs[i]);
		adsr_init(&synth.wmodEnvs[i]);
	}

	lfo_init(&synth.lfo[0]);
	lfo_init(&synth.lfo[1]);

	// rest the synth on scale middle (prevents analog glitches)
	for(i=0;i<SYNTH_VOICE_COUNT;++i)
	{
		synth.oscANoteCV[i]=synth.oscATargetCV[i]=tuner_computeCVFromNote(i,MIDDLE_C_NOTE,0,cvAPitch);
		synth.oscBNoteCV[i]=synth.oscBTargetCV[i]=tuner_computeCVFromNote(i,MIDDLE_C_NOTE,0,cvBPitch);
		synth.filterNoteCV[i]=synth.filterTargetCV[i]=tuner_computeCVFromNote(i,MIDDLE_C_NOTE,0,cvCutoff);
	}
	
	// load settings from storage & load static stuff

	settings_load();
	synth_refreshBankNames(1,1);

	// load last preset & do a full refresh

	preset_loadCurrent(settings.presetNumber);
	ui_setPresetModified(0);

	synth_refreshFullState(1);

	// set USB mode
	
	usb_setMode(settings.usbMIDI?umMIDI:umPowerOnly,NULL);
}


void synth_update(void)
{
#if 0
	putc_serial0('.');	
#else
	static int32_t frc=0,prevTick=0;
	++frc;
	if(currentTick-prevTick>=TICKER_HZ)
	{
		rprintf(0,"%d u/s\n",frc);
		frc=0;
		prevTick+=TICKER_HZ;
	}
#endif

	scan_update();
	ui_update();
	midi_update();
}

////////////////////////////////////////////////////////////////////////////////
// Synth internal events
////////////////////////////////////////////////////////////////////////////////

// @ 500Hz on 4 phases from from dacspi update
void synth_tickTimerEvent(uint8_t phase)
{
	switch(phase)
	{
		case 0:
			// bit inputs (footswitch)
			handleBitInputs();
			// midi
			midi_processInput();
			break;
		case 1:
			// assigner
			handleFinishedVoices();
			// clocking
			clock_update();
			break;
		case 2:
			// glide
			for(int8_t v=0;v<SYNTH_VOICE_COUNT;++v)
			{
				int16_t amt=synth.partState.glideAmount;

				if(synth.partState.gliding)
				{
					computeGlide(&synth.oscANoteCV[v],synth.oscATargetCV[v],amt);
					computeGlide(&synth.oscBNoteCV[v],synth.oscBTargetCV[v],amt);
					computeGlide(&synth.filterNoteCV[v],synth.filterTargetCV[v],amt);
				}
			}
			break;
		case 3:
			refreshLfoSettings();
			synth.partState.syncModeMaster=currentPreset.steppedParameters[spOscSync]?osmMaster:osmNone;
			synth.partState.syncModeSlave=currentPreset.steppedParameters[spOscSync]?osmSlave:osmNone;
			// 500hz tick counter
			++currentTick;
			break;
		default:
			/* nothing */;
	}
}

// @ 4Khz from dacspi update
void synth_updateCVsEvent(void)
{
	int32_t val,pitchAVal,pitchBVal,wmodAVal,wmodBVal,filterVal,ampVal,wmodAEnvAmt,wmodBEnvAmt,filEnvAmt;
	int32_t resoFactor=0, resVal=0;
	
	// global CVs update

	auto uint32_t getResonanceCompensatedCV(continuousParameter_t cp, cv_t cv)
	{
		return scaleU16U16(currentPreset.continuousParameters[cp],(getStaticCV(cv)-INT16_MIN))*resoFactor/256;
	}
		
	resVal=currentPreset.continuousParameters[cpResonance];
	resVal+=scaleU16S16(currentPreset.continuousParameters[cpLFOResAmt],synth.lfo[0].output);
	resVal+=scaleU16S16(currentPreset.continuousParameters[cpLFO2ResAmt],synth.lfo[1].output);
	resVal=__USAT(resVal,16);

		// compensate resonance lowering volume by abjusting pre filter mixer level
	resoFactor=(35*UINT16_MAX+170*(uint32_t)MAX(0,resVal-2500))/(100*256);
	
	synth_refreshCV(-1,cvResonance,resVal>>1,0); // half scale is already oscillating
	synth_refreshCV(-1,cvAVol,getResonanceCompensatedCV(cpAVol,cvAVol),0);
	synth_refreshCV(-1,cvBVol,getResonanceCompensatedCV(cpBVol,cvBVol),0);
	synth_refreshCV(-1,cvNoiseVol,getResonanceCompensatedCV(cpNoiseVol,cvNoiseVol),0);

	// lfos
		
	lfo_update(&synth.lfo[0]);
	lfo_update(&synth.lfo[1]);
		
	// global computations
	
		// pitch

	pitchAVal=pitchBVal=0;

	val=scaleU16S16(currentPreset.continuousParameters[cpLFOPitchAmt],synth.lfo[0].output>>1);
	if(currentPreset.steppedParameters[spLFOTargets]&otA)
		pitchAVal+=val;
	if(currentPreset.steppedParameters[spLFOTargets]&otB)
		pitchBVal+=val;

	val=scaleU16S16(currentPreset.continuousParameters[cpLFO2PitchAmt],synth.lfo[1].output>>1);
	if(currentPreset.steppedParameters[spLFO2Targets]&otA)
		pitchAVal+=val;
	if(currentPreset.steppedParameters[spLFO2Targets]&otB)
		pitchBVal+=val;

		// filter

	filterVal=scaleU16S16(currentPreset.continuousParameters[cpLFOFilAmt],synth.lfo[0].output);
	filterVal+=scaleU16S16(currentPreset.continuousParameters[cpLFO2FilAmt],synth.lfo[1].output);
	
		// amplifier

	ampVal=UINT16_MAX;

	ampVal-=scaleU16U16(currentPreset.continuousParameters[cpLFOAmpAmt],synth.lfo[0].levelCV>>1);
	ampVal+=scaleU16S16(currentPreset.continuousParameters[cpLFOAmpAmt],synth.lfo[0].output);

	ampVal-=scaleU16U16(currentPreset.continuousParameters[cpLFO2AmpAmt],synth.lfo[1].levelCV>>1);
	ampVal+=scaleU16S16(currentPreset.continuousParameters[cpLFO2AmpAmt],synth.lfo[1].output);

	ampVal=scaleU16U16(ampVal,currentPreset.continuousParameters[cpAmpLevel]);

		// misc

	filEnvAmt=currentPreset.continuousParameters[cpFilEnvAmt];
	filEnvAmt+=INT16_MIN;

	wmodAVal=currentPreset.continuousParameters[cpABaseWMod];
	if(currentPreset.steppedParameters[spAWModType]==wmFrequency)
		wmodAVal=((wmodAVal-HALF_RANGE)>>1)+HALF_RANGE; // half scale for freq mod
	if(currentPreset.steppedParameters[spLFOTargets]&otA)
		wmodAVal+=scaleU16S16(currentPreset.continuousParameters[cpLFOWModAmt],synth.lfo[0].output);
	if(currentPreset.steppedParameters[spLFO2Targets]&otA)
		wmodAVal+=scaleU16S16(currentPreset.continuousParameters[cpLFO2WModAmt],synth.lfo[1].output);
	wmodAVal+=getStaticCV(cvWaveMod);

	wmodBVal=currentPreset.continuousParameters[cpBBaseWMod];
	if(currentPreset.steppedParameters[spBWModType]==wmFrequency)
		wmodBVal=((wmodBVal-HALF_RANGE)>>1)+HALF_RANGE; // half scale for freq mod
	if(currentPreset.steppedParameters[spLFOTargets]&otB)
		wmodBVal+=scaleU16S16(currentPreset.continuousParameters[cpLFOWModAmt],synth.lfo[0].output);
	if(currentPreset.steppedParameters[spLFO2Targets]&otB)
		wmodBVal+=scaleU16S16(currentPreset.continuousParameters[cpLFO2WModAmt],synth.lfo[1].output);
	wmodBVal+=getStaticCV(cvWaveMod);

	wmodAEnvAmt=currentPreset.continuousParameters[cpWModAEnv];
	wmodBEnvAmt=currentPreset.continuousParameters[cpWModBEnv];
	wmodAEnvAmt+=INT16_MIN;
	wmodBEnvAmt+=INT16_MIN;

		// restrict range

	pitchAVal=__SSAT(pitchAVal,16);
	pitchBVal=__SSAT(pitchBVal,16);
	wmodAVal=__USAT(wmodAVal,16);
	wmodBVal=__USAT(wmodBVal,16);
	filterVal=__SSAT(filterVal,16);
	ampVal=__USAT(ampVal,16);

	// voices computations

	for(int8_t v=0;v<SYNTH_VOICE_COUNT;++v)
		refreshVoice(v,wmodAEnvAmt,wmodBEnvAmt,filEnvAmt,pitchAVal,pitchBVal,wmodAVal,wmodBVal,filterVal,ampVal);
}

#define PROC_UPDATE_OSCS_VOICE(v) \
FORCEINLINE static void updateOscsVoice##v(int32_t start, int32_t end) \
{ \
	wtosc_update(&synth.osc[v][0],start,end,synth.partState.syncModeMaster,synth.partState.syncPositions); \
	wtosc_update(&synth.osc[v][1],start,end,synth.partState.syncModeSlave,synth.partState.syncPositions); \
}

PROC_UPDATE_OSCS_VOICE(0);
PROC_UPDATE_OSCS_VOICE(1);
PROC_UPDATE_OSCS_VOICE(2);
PROC_UPDATE_OSCS_VOICE(3);
PROC_UPDATE_OSCS_VOICE(4);
PROC_UPDATE_OSCS_VOICE(5);

void synth_updateOscsEvent(int32_t start, int32_t count)
{
	int32_t end=start+count-1;

	updateOscsVoice0(start,end);
	updateOscsVoice1(start,end);
	updateOscsVoice2(start,end);
	updateOscsVoice3(start,end);
	updateOscsVoice4(start,end);
	updateOscsVoice5(start,end);
}

void synth_assignerEvent(uint8_t note, int8_t gate, int8_t voice, uint16_t velocity, uint8_t flags)
{
#ifdef DEBUG
	rprintf(0,"assign note %d gate %d voice %d velocity %d flags %d\n",note,gate,voice,velocity,flags);
#endif

	uint16_t velAmt;
	
	// mod delay
	refreshModulationDelay(0);

	// prepare CVs
	refreshTunedCVs();

	// set gates (don't retrigger gate, unless we're arpeggiating)
	if(!(flags&ASSIGNER_EVENT_FLAG_LEGATO) || arp_getMode()!=amOff)
	{
		adsr_setGate(&synth.wmodEnvs[voice],gate);
		adsr_setGate(&synth.filEnvs[voice],gate);
		adsr_setGate(&synth.ampEnvs[voice],gate);
	}

	if(gate)
	{
		// handle velocity
		velAmt=currentPreset.continuousParameters[cpWModVelocity];
		adsr_setCVs(&synth.wmodEnvs[voice],0,0,0,0,(UINT16_MAX-velAmt)+scaleU16U16(velocity,velAmt),0x10);
		velAmt=currentPreset.continuousParameters[cpFilVelocity];
		adsr_setCVs(&synth.filEnvs[voice],0,0,0,0,(UINT16_MAX-velAmt)+scaleU16U16(velocity,velAmt),0x10);
		velAmt=currentPreset.continuousParameters[cpAmpVelocity];
		adsr_setCVs(&synth.ampEnvs[voice],0,0,0,0,(UINT16_MAX-velAmt)+scaleU16U16(velocity,velAmt),0x10);
		
		// handle LFOs trigger
		if(currentPreset.steppedParameters[spLFOTrig])
			lfo_reset(&synth.lfo[0]);
		if(currentPreset.steppedParameters[spLFO2Trig])
			lfo_reset(&synth.lfo[1]);
	}
}

void synth_uartMIDIEvent(uint8_t data)
{
#ifdef DEBUG_
	rprintf(0,"uart midi %x\n",data);
#endif

	midi_newData(mpUART, data);
}

void synth_usbMIDIEvent(uint8_t data)
{
#ifdef DEBUG_
	rprintf(0,"usb midi %x\n",data);
#endif

	midi_newData(mpUSB, data);
}

void synth_wheelEvent(int16_t bend, uint16_t modulation, uint8_t mask)
{
	static const int8_t br[]={4,7,12,0};
	static const int8_t mr[]={5,3,1,0};

#ifdef DEBUG_
	rprintf(0,"wheel bend %d mod %d mask %d\n",bend,modulation,mask);
#endif

	if(mask&1)
	{
		uint8_t range=br[currentPreset.steppedParameters[spBenderRange]];
		
		switch(currentPreset.steppedParameters[spBenderTarget])
		{
			case modPitch:
				bend=scaleU16S16(tuner_computeCVFromNote(0,range*2,0,cvAPitch)-tuner_computeCVFromNote(0,0,0,cvAPitch),bend);
				break;
			case modFilter:
				bend=scaleU16S16(tuner_computeCVFromNote(0,range*8,0,cvCutoff)-tuner_computeCVFromNote(0,0,0,cvCutoff),bend);
				break;
			case modVolume:
			case modWaveMod:
				bend=(bend/12)*range;
				break;
		}

		synth.partState.benderAmount=bend;

		if(currentPreset.steppedParameters[spBenderTarget]==modPitch ||
				currentPreset.steppedParameters[spBenderTarget]==modFilter)
			refreshTunedCVs();
	}
	
	if(mask&2)
	{
		synth.partState.modwheelAmount=modulation>>mr[currentPreset.steppedParameters[spModwheelRange]];
		refreshLfoSettings();
	}
}

void synth_pressureEvent(uint16_t pressure)
{
	static const int8_t pr[]={5,3,1,0};

#ifdef DEBUG_
	rprintf(0,"pressure %d\n",pressure);
#endif
	
	synth.partState.pressureAmount=pressure>>pr[currentPreset.steppedParameters[spPressureRange]];

	switch(currentPreset.steppedParameters[spPressureTarget])
	{
		case modPitch:
			synth.partState.pressureAmount>>=2; // less modulation for pitch
			refreshTunedCVs();
			break;
		case modFilter:
			refreshTunedCVs();
			break;
		case modLFO1:
		case modLFO2:
			refreshLfoSettings();
			break;
	}
	
}

void synth_realtimeEvent(midiPort_t port, uint8_t midiEvent)
{
	if(!(port==mpUART && settings.syncMode==symMIDI || port==mpUSB && settings.syncMode==symUSB))
		return;
	
	switch(midiEvent)
	{
		case MIDI_CLOCK:
			clock_extClockTick();
			break;
		case MIDI_START:
			seq_resetCounter(0,0);
			seq_resetCounter(1,0);
			arp_resetCounter(0);
			clock_reset(); // always do a beat reset on MIDI START
			break;
		case MIDI_STOP:
			seq_silence(0);
			seq_silence(1);
			break;
	}
}

void synth_clockEvent(void)
{
	// sequencer

	if(seq_getMode(0)!=smOff || seq_getMode(1)!=smOff)
		seq_update();

	// arpeggiator

	if(arp_getMode()!=amOff)
		arp_update();
}
