gligli/overcycler/firmware_17xx/usb/usbhw_lpc.c

/*
    LPCUSB, an USB device driver for LPC microcontrollers   
    Copyright (C) 2006 Bertrik Sikken (bertrik@sikken.nl)

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
    1. Redistributions of source code must retain the above copyright
       notice, this list of conditions and the following disclaimer.
    2. Redistributions in binary form must reproduce the above copyright
       notice, this list of conditions and the following disclaimer in the
       documentation and/or other materials provided with the distribution.
    3. The name of the author may not be used to endorse or promote products
       derived from this software without specific prior written permission.

    THIS SOFTWARE IS PROVIDED BY THE AUTHOR ``AS IS'' AND ANY EXPRESS OR
    IMPLIED WARRANTIES, INCLUDING, BUT NOT LIMITED TO, THE IMPLIED WARRANTIES
    OF MERCHANTABILITY AND FITNESS FOR A PARTICULAR PURPOSE ARE DISCLAIMED.
    IN NO EVENT SHALL THE AUTHOR BE LIABLE FOR ANY DIRECT, INDIRECT, 
    INCIDENTAL, SPECIAL, EXEMPLARY, OR CONSEQUENTIAL DAMAGES (INCLUDING, BUT
    NOT LIMITED TO, PROCUREMENT OF SUBSTITUTE GOODS OR SERVICES; LOSS OF USE,
    DATA, OR PROFITS; OR BUSINESS INTERRUPTION) HOWEVER CAUSED AND ON ANY
    THEORY OF LIABILITY, WHETHER IN CONTRACT, STRICT LIABILITY, OR TORT
    (INCLUDING NEGLIGENCE OR OTHERWISE) ARISING IN ANY WAY OUT OF THE USE OF
    THIS SOFTWARE, EVEN IF ADVISED OF THE POSSIBILITY OF SUCH DAMAGE.
*/


/** @file
    USB hardware layer
 */

#include "usb_type.h"
#include "usb_debug.h"

#ifdef LPC1778
#include "synth/utils.h"
#include "system/main.h"
#include "drivers/LPC177x_8x.h"
#endif
#ifdef LPC214x
#include "lpc214x.h"
#endif
#ifdef LPC23xx
#include "lpc23xx.h"
#endif
#include "usbhw_lpc.h"
#include "usbapi.h"

#ifdef DEBUG
// comment out the following line if you don't want to use debug LEDs
//#define DEBUG_LED
#endif

#ifdef DEBUG_LED
#ifdef LPC214x
#define DEBUG_LED_ON(x)     IOCLR0 = (1 << x);
#define DEBUG_LED_OFF(x)    IOSET0 = (1 << x);
#define DEBUG_LED_INIT(x)   PINSEL0 &= ~(0x3 << (2*x)); IODIR0 |= (1 << x); DEBUG_LED_OFF(x);
#else
#define DEBUG_LED_ON(x)     FIO2SET = (1 << (x-8));
#define DEBUG_LED_OFF(x)    FIO2CLR = (1 << (x-8));
#define DEBUG_LED_INIT(x)   SCS |= 1; PINSEL10 = 0; FIO2DIR |= (1 << (x-8)); DEBUG_LED_OFF(x);
#endif
#else
#define DEBUG_LED_INIT(x)   /**< LED initialisation macro */
#define DEBUG_LED_ON(x)     /**< turn LED on */
#define DEBUG_LED_OFF(x)    /**< turn LED off */
#endif

/** Installed device interrupt handler */
static TFnDevIntHandler *_pfnDevIntHandler = NULL;
/** Installed endpoint interrupt handlers */
static TFnEPIntHandler  *_apfnEPIntHandlers[16];
/** Installed frame interrupt handlers */
static TFnFrameHandler  *_pfnFrameHandler = NULL;

/** convert from endpoint address to endpoint index */
#define EP2IDX(bEP) ((((bEP)&0xF)<<1)|(((bEP)&0x80)>>7))
/** convert from endpoint index to endpoint address */
#define IDX2EP(idx) ((((idx)<<7)&0x80)|(((idx)>>1)&0xF))



/**
    Local function to wait for a device interrupt (and clear it)
        
    @param [in] dwIntr      Bitmask of interrupts to wait for   
 */
static void Wait4DevInt(U32 dwIntr)
{
    // wait for specific interrupt
    while ((LPC_USB->USBDevIntSt & dwIntr) != dwIntr);
    // clear the interrupt bits
    LPC_USB->USBDevIntClr = dwIntr;
}


/**
    Local function to send a command to the USB protocol engine
        
    @param [in] bCmd        Command to send
 */
static void USBHwCmd(U8 bCmd)
{
    // clear CDFULL/CCEMTY
    LPC_USB->USBDevIntClr = CDFULL | CCEMTY;
    // write command code
    LPC_USB->USBCmdCode = 0x00000500 | (bCmd << 16);
	Wait4DevInt(CCEMTY);
}


/**
    Local function to send a command + data to the USB protocol engine
        
    @param [in] bCmd        Command to send
    @param [in] bData       Data to send
 */
static void USBHwCmdWrite(U8 bCmd, U16 bData)
{
    // write command code
    USBHwCmd(bCmd);

    // write command data
    LPC_USB->USBCmdCode = 0x00000100 | (bData << 16);
    Wait4DevInt(CCEMTY);
}


/**
    Local function to send a command to the USB protocol engine and read data
        
    @param [in] bCmd        Command to send

    @return the data
 */
static U8 USBHwCmdRead(U8 bCmd)
{
    // write command code
    USBHwCmd(bCmd);
    
    // get data
    LPC_USB->USBCmdCode = 0x00000200 | (bCmd << 16);
    Wait4DevInt(CDFULL);
    return LPC_USB->USBCmdData;
}


/**
    'Realizes' an endpoint, meaning that buffer space is reserved for
    it. An endpoint needs to be realised before it can be used.
        
    From experiments, it appears that a USB reset causes USBReEp to
    re-initialise to 3 (= just the control endpoints).
    However, a USB bus reset does not disturb the USBMaxPSize settings.
        
    @param [in] idx         Endpoint index
    @param [in] wMaxPSize   Maximum packet size for this endpoint
 */
static void USBHwEPRealize(int idx, U16 wMaxPSize)
{
    LPC_USB->USBReEp |= (1 << idx);
    LPC_USB->USBEpInd = idx;
    LPC_USB->USBMaxPSize = wMaxPSize;
    Wait4DevInt(EP_RLZED);
}


/**
    Enables or disables an endpoint
        
    @param [in] idx     Endpoint index
    @param [in] fEnable TRUE to enable, FALSE to disable
 */
static void USBHwEPEnable(int idx, BOOL fEnable)
{
    USBHwCmdWrite(CMD_EP_SET_STATUS | idx, fEnable ? 0 : EP_DA);
}


/**
    Configures an endpoint and enables it
        
    @param [in] bEP             Endpoint number
    @param [in] wMaxPacketSize  Maximum packet size for this EP
 */
void USBHwEPConfig(U8 bEP, U16 wMaxPacketSize)
{
    int idx;
    
    idx = EP2IDX(bEP);
    
    // realise EP
    USBHwEPRealize(idx, wMaxPacketSize);

    // enable EP
    USBHwEPEnable(idx, TRUE);
}


/**
    Registers an endpoint event callback
        
    @param [in] bEP             Endpoint number
    @param [in] pfnHandler      Callback function
 */
void USBHwRegisterEPIntHandler(U8 bEP, TFnEPIntHandler *pfnHandler)
{
    int idx;
    
    idx = EP2IDX(bEP);

    ASSERT(idx<32);

    /* add handler to list of EP handlers */
    _apfnEPIntHandlers[idx / 2] = pfnHandler;
    
    /* enable EP interrupt */
    LPC_USB->USBEpIntEn |= (1 << idx);
    LPC_USB->USBDevIntEn |= EP_SLOW;
    
    DBG("Registered handler for EP 0x%x\n", bEP);
}


/**
    Registers an device status callback
        
    @param [in] pfnHandler  Callback function
 */
void USBHwRegisterDevIntHandler(TFnDevIntHandler *pfnHandler)
{
    _pfnDevIntHandler = pfnHandler;
    
    // enable device interrupt
    LPC_USB->USBDevIntEn |= DEV_STAT;

    DBG("Registered handler for device status\n");
}


/**
    Registers the frame callback
        
    @param [in] pfnHandler  Callback function
 */
void USBHwRegisterFrameHandler(TFnFrameHandler *pfnHandler)
{
    _pfnFrameHandler = pfnHandler;
    
    // enable device interrupt
    LPC_USB->USBDevIntEn |= FRAME;

    DBG("Registered handler for frame\n");
}


/**
    Sets the USB address.
        
    @param [in] bAddr       Device address to set
 */
void USBHwSetAddress(U8 bAddr)
{
    USBHwCmdWrite(CMD_DEV_SET_ADDRESS, DEV_EN | bAddr);
}


/**
    Connects or disconnects from the USB bus
        
    @param [in] fConnect    If TRUE, connect, otherwise disconnect
 */
void USBHwConnect(BOOL fConnect)
{
#ifdef LPC1778
  if(fConnect)
  {
	/* P0.29 D1+, P0.30 D1- */
	LPC_IOCON->P0_29 = 0x1;
	LPC_IOCON->P0_30 = 0x1;
  }
#endif

#ifdef LPC23xx
#ifndef LPC2378_PORTB
  if(fConnect)
    FIO2CLR = (1<<9);
  else
    FIO2SET = (1<<9);
#else
  if(fConnect)
    FIO0CLR = (1<<14);
  else
    FIO0SET = (1<<14);
#endif
#endif
    USBHwCmdWrite(CMD_DEV_STATUS, fConnect ? CON : 0);

#ifdef LPC1778
  if(!fConnect)
  {
	delay_ms(5);
	
	/* P0.29, P0.30 pulled low to disconnect */
	LPC_GPIO0->FIODIR |= (1<<29) | (1<<30); // GPIO as output
	LPC_IOCON->P0_29 = 0x400; // GPIO mode / open drain mode
	LPC_IOCON->P0_30 = 0x400;
  }
#endif
}


/**
    Enables interrupt on NAK condition
        
    For IN endpoints a NAK is generated when the host wants to read data
    from the device, but none is available in the endpoint buffer.
    For OUT endpoints a NAK is generated when the host wants to write data
    to the device, but the endpoint buffer is still full.
    
    The endpoint interrupt handlers can distinguish regular (ACK) interrupts
    from NAK interrupt by checking the bits in their bEPStatus argument.
    
    @param [in] bIntBits    Bitmap indicating which NAK interrupts to enable
 */
void USBHwNakIntEnable(U8 bIntBits)
{
    USBHwCmdWrite(CMD_DEV_SET_MODE, bIntBits);
}


/**
    Gets the status from a specific endpoint.
        
    @param [in] bEP     Endpoint number
    @return Endpoint status byte (containing EP_STATUS_xxx bits)
 */
U8  USBHwEPGetStatus(U8 bEP)
{
    int idx = EP2IDX(bEP);

    return USBHwCmdRead(CMD_EP_SELECT | idx);
}


/**
    Sets the stalled property of an endpoint
        
    @param [in] bEP     Endpoint number
    @param [in] fStall  TRUE to stall, FALSE to unstall
 */
void USBHwEPStall(U8 bEP, BOOL fStall)
{
    int idx = EP2IDX(bEP);

    USBHwCmdWrite(CMD_EP_SET_STATUS | idx, fStall ? EP_ST : 0);
}


/**
    Writes data to an endpoint buffer
        
    @param [in] bEP     Endpoint number
    @param [in] pbBuf   Endpoint data
    @param [in] iLen    Number of bytes to write
            
    @return number of bytes written into the endpoint buffer
*/
int USBHwEPWrite(U8 bEP, U8 *pbBuf, int iLen)
{
    int idx;
    
    idx = EP2IDX(bEP);
    
    // set write enable for specific endpoint
    LPC_USB->USBCtrl = WR_EN | ((bEP & 0xF) << 2);
    
    // set packet length
    LPC_USB->USBTxPLen = iLen;
    
    // write data
    while (LPC_USB->USBCtrl & WR_EN) {
        LPC_USB->USBTxData = (pbBuf[3] << 24) | (pbBuf[2] << 16) | (pbBuf[1] << 8) | pbBuf[0];
        pbBuf += 4;
    }

    LPC_USB->USBCtrl = 0;

    // select endpoint and validate buffer
    USBHwCmd(CMD_EP_SELECT | idx);
    USBHwCmd(CMD_EP_VALIDATE_BUFFER);
    
    return iLen;
}


/**
    Reads data from an endpoint buffer
        
    @param [in] bEP     Endpoint number
    @param [in] pbBuf   Endpoint data
    @param [in] iMaxLen Maximum number of bytes to read
            
    @return the number of bytes available in the EP (possibly more than iMaxLen),
    or <0 in case of error.
 */
int USBHwEPRead(U8 bEP, U8 *pbBuf, int iMaxLen)
{
    int i, idx;
    U32 dwData, dwLen;
    
    idx = EP2IDX(bEP);
    
    // set read enable bit for specific endpoint
    LPC_USB->USBCtrl = RD_EN | ((bEP & 0xF) << 2);
    
    // wait for PKT_RDY
    do {
        dwLen = LPC_USB->USBRxPLen;
    } while ((dwLen & PKT_RDY) == 0);
    
    // packet valid?
    if ((dwLen & DV) == 0) {
        return -1;
    }
    
    // get length
    dwLen &= PKT_LNGTH_MASK;
    
    // get data
    dwData = 0;
    for (i = 0; i < dwLen; i++) {
        if ((i % 4) == 0) {
            dwData = LPC_USB->USBRxData;
        }
        if ((pbBuf != NULL) && (i < iMaxLen)) {
            pbBuf[i] = dwData & 0xFF;
        }
        dwData >>= 8;
    }

    // make sure RD_EN is clear
    LPC_USB->USBCtrl = 0;

    // select endpoint and clear buffer
    USBHwCmd(CMD_EP_SELECT | idx);
    USBHwCmd(CMD_EP_CLEAR_BUFFER);
    
    return dwLen;
}




int USBHwISOCEPRead(const U8 bEP, U8 *pbBuf, const int iMaxLen)
{
    int i, idx;
    U32 dwData, dwLen;

    idx = EP2IDX(bEP);

    // set read enable bit for specific endpoint
    LPC_USB->USBCtrl = RD_EN | ((bEP & 0xF) << 2);
    
    //Note: for some reason the USB perepherial needs a cycle to set bits in USBRxPLen before 
    //reading, if you remove this ISOC wont work. This may be a but in the chip, or due to 
    //a mis-understanding of how the perepherial is supposed to work.    
    asm volatile("nop\n"); 

    
    dwLen = LPC_USB->USBRxPLen;
    if( (dwLen & PKT_RDY) == 0 ) {
        LPC_USB->USBCtrl = 0;// make sure RD_EN is clear
        return(-1);
    }

    // packet valid?
    if ((dwLen & DV) == 0) {
        LPC_USB->USBCtrl = 0;// make sure RD_EN is clear
        return -1;
    }

    // get length
    dwLen &= PKT_LNGTH_MASK;

    // get data
    dwData = 0;
    for (i = 0; i < dwLen; i++) {
        if ((i % 4) == 0) {
            dwData = LPC_USB->USBRxData;
        }
        if ((pbBuf != NULL) && (i < iMaxLen)) {
            pbBuf[i] = dwData & 0xFF;
        }
        dwData >>= 8;
    }

    // make sure RD_EN is clear
    LPC_USB->USBCtrl = 0;

    // select endpoint and clear buffer
    USBHwCmd(CMD_EP_SELECT | idx);
    USBHwCmd(CMD_EP_CLEAR_BUFFER);

    return dwLen;
}


/**
    Sets the 'configured' state.
        
    All registered endpoints are 'realised' and enabled, and the
    'configured' bit is set in the device status register.
        
    @param [in] fConfigured If TRUE, configure device, else unconfigure
 */
void USBHwConfigDevice(BOOL fConfigured)
{
    // set configured bit
    USBHwCmdWrite(CMD_DEV_CONFIG, fConfigured ? CONF_DEVICE : 0);
}


/**
    USB interrupt handler
        
    @todo Get all 11 bits of frame number instead of just 8

    Endpoint interrupts are mapped to the slow interrupt
 */
void USBHwISR(void)
{
    U32 dwStatus;
    U32 dwIntBit;
    U8  bEPStat, bDevStat, bStat;
    int i;
    U16 wFrame;

// LED9 monitors total time in interrupt routine
DEBUG_LED_ON(9);

    // handle device interrupts
    dwStatus = LPC_USB->USBDevIntSt;
	
    if (dwStatus & ERR_INT) {
        // clear int
        LPC_USB->USBDevIntClr = ERR_INT;
		// get error status
		bStat = USBHwCmdRead(CMD_DEV_READ_ERROR_STATUS);
		DBG("\nUSBHwISR: ERR_INT_%x_\n",bStat);
    }
	
    // frame interrupt
    if (dwStatus & FRAME) {
        // clear int
        LPC_USB->USBDevIntClr = FRAME;
        // call handler
        if (_pfnFrameHandler != NULL) {
            wFrame = USBHwCmdRead(CMD_DEV_READ_CUR_FRAME_NR);
            _pfnFrameHandler(wFrame);
        }
    }
    
    // device status interrupt
    if (dwStatus & DEV_STAT) {
        /*  Clear DEV_STAT interrupt before reading DEV_STAT register.
            This prevents corrupted device status reads, see
            LPC2148 User manual revision 2, 25 july 2006.
        */
        LPC_USB->USBDevIntClr = DEV_STAT;
        bDevStat = USBHwCmdRead(CMD_DEV_STATUS);
        if (bDevStat & (CON_CH | SUS_CH | RST)) {
            // convert device status into something HW independent
            bStat = ((bDevStat & CON) ? DEV_STATUS_CONNECT : 0) |
                    ((bDevStat & SUS) ? DEV_STATUS_SUSPEND : 0) |
                    ((bDevStat & RST) ? DEV_STATUS_RESET : 0);
            // call handler
            if (_pfnDevIntHandler != NULL) {
DEBUG_LED_ON(8);        
                _pfnDevIntHandler(bStat);
DEBUG_LED_OFF(8);       
            }
        }
    }
    
    // endpoint interrupt
    if (dwStatus & EP_SLOW) {
        // clear EP_SLOW
        LPC_USB->USBDevIntClr = EP_SLOW;
        // check all endpoints
        for (i = 0; i < 32; i++) {
            dwIntBit = (1 << i);
            if (LPC_USB->USBEpIntSt & dwIntBit) {
                // clear int (and retrieve status)
                LPC_USB->USBEpIntClr = dwIntBit;
                Wait4DevInt(CDFULL);
                bEPStat = LPC_USB->USBCmdData;
                // convert EP pipe stat into something HW independent
                bStat = ((bEPStat & EPSTAT_FE) ? EP_STATUS_DATA : 0) |
                        ((bEPStat & EPSTAT_ST) ? EP_STATUS_STALLED : 0) |
                        ((bEPStat & EPSTAT_STP) ? EP_STATUS_SETUP : 0) |
                        ((bEPStat & EPSTAT_EPN) ? EP_STATUS_NACKED : 0) |
                        ((bEPStat & EPSTAT_PO) ? EP_STATUS_ERROR : 0);
                // call handler
                if (_apfnEPIntHandlers[i / 2] != NULL) {
DEBUG_LED_ON(10);       
                    _apfnEPIntHandlers[i / 2](IDX2EP(i), bStat);
DEBUG_LED_OFF(10);
                }
            }
        }
    }
    
DEBUG_LED_OFF(9);       
}


/**
 * Pre-initialises the USB hardware
 * 
 * Sets the USB differential pair to low state to mark USB as disconnected for the host.
 */
void USBHwPreinit (void)
{
#ifdef LPC1778	
	/* P0.29, P0.30 pulled low to disconnect */
	LPC_GPIO0->FIODIR |= (1<<29) | (1<<30); // GPIO as output
	LPC_IOCON->P0_29 = 0x400; // GPIO mode / open drain mode
	LPC_IOCON->P0_30 = 0x400;
#endif
}


/**
    Initialises the USB hardware
        
    This function assumes that the hardware is connected as shown in
    section 10.1 of the LPC2148 data sheet:
    * P0.31 controls a switch to connect a 1.5k pull-up to D+ if low.
    * P0.23 is connected to USB VCC.
    
    Embedded artists board: make sure to disconnect P0.23 LED as it
    acts as a pull-up and so prevents detection of USB disconnect.
        
    @return TRUE if the hardware was successfully initialised
 */
BOOL USBHwInit(void)
{
#ifdef LPC1778	
	/* P0.29 D1+, P0.30 D1- */
	LPC_IOCON->P0_29 = 0x1;
	LPC_IOCON->P0_30 = 0x1;

	/* USB PCLK -> enable USB Per. */
	LPC_SC->PCONP |= (1UL<<31); 

	/* Dev, AHB clock enable */
	LPC_USB->USBClkCtrl =  0x12|(1<<2); 
	while ((LPC_USB->USBClkSt & 0x12) != 0x12);
#endif
	
#ifdef LPC214x
    
    // configure P0.23 for Vbus sense
    PINSEL1 = (PINSEL1 & ~(3 << 14)) | (1 << 14);   // P0.23
    // configure P0.31 for CONNECT
    PINSEL1 = (PINSEL1 & ~(3 << 30)) | (2 << 30);   // P0.31

    // enable PUSB
    PCONP |= (1 << 31);     

    // initialise PLL
    PLL1CON = 1;            // enable PLL
    PLL1CFG = (1 << 5) | 3; // P = 2, M = 4
    PLL1FEED = 0xAA;
    PLL1FEED = 0x55;
    while ((PLL1STAT & (1 << 10)) == 0);

    PLL1CON = 3;            // enable and connect
    PLL1FEED = 0xAA;
    PLL1FEED = 0x55;

#endif

#ifdef LPC23xx
#ifdef LPC2378_PORTB
    PINSEL1 = (PINSEL1 & ~(3 << 30)) | (1 << 30);
    PINSEL3 = (PINSEL3 & ~(3 << 28)) | (2 << 28);
    /* Due to a bug in the LPC23xx chips, the connection functionality must be
    * simulated using GPIO. Hopefully for production this will be fixed and the
    * commented out code will work */
    //PINSEL0 = (PINSEL0 & ~((3 << 26) | (3 << 28))) | (1 << 26) | (1 << 28); /* Doesn't work due to bug in chip */
    PINSEL0 = (PINSEL0 & ~((3 << 26) | (3 << 28))) | (1 << 26);
    FIO0DIR |= (1<<14); /* Set pin to output */
    FIO0SET = (1<<14); /* Set output high to disconnect */
    
#else
    PINSEL1 = (PINSEL1 & ~((3 << 26) | (3 << 28))) | (1 << 26) | (1 << 28);
    PINSEL3 = (PINSEL3 & ~((3 << 4) | (3 << 28))) | (1 << 4) | (2 << 28);
    /* Due to a bug in the LPC23xx chips, the connection functionality must be
    * simulated using GPIO. Hopefully for production this will be fixed and the
    * commented out code will work */
    //PINSEL4 = (PINSEL4 & ~(3 << 18)) | (1 << 18); /* Doesn't work due to bug in chip */
    PINSEL4 = (PINSEL4 & ~(3 << 18)); /* Use pin as GPIO */
    FIO2DIR |= (1<<9); /* Set pin to output */
    FIO2SET = (1<<9); /* Set output high to disconnect */
#endif

    // enable PUSB
    PCONP |= (1 << 31);     

  /* The LPC23xx uses a single PLL, and has multiple clock dividers for each
   * peripheral. These settings assume a PLL frequency of 288 MHz */

    USBCLKCFG = 5; /* 288 MHz / 48 MHz = 6 */

#ifdef LPC2378_PORTB
    USBClkCtrl = (1 << 1) | (1 << 3) | (1 << 4); /* Enable the clocks */
    while (!(USBClkSt & ((1 << 1) | (1 << 3) | (1 << 4))));
    USBPortSel = 0x3; /* Set LPC to use USB Port B pins */
#else
    USBClkCtrl = (1 << 1) | (1 << 4); /* Enable the clocks */
    while (!(USBClkSt & ((1 << 1) | (1 << 4))));
#endif

#endif

    // disable/clear all interrupts for now
    LPC_USB->USBDevIntEn = 0;
    LPC_USB->USBDevIntClr = 0xFFFFFFFF;
    LPC_USB->USBDevIntPri = 0;

    LPC_USB->USBEpIntEn = 0;
    LPC_USB->USBEpIntClr = 0xFFFFFFFF;
    LPC_USB->USBEpIntPri = 0;

    // by default, only ACKs generate interrupts
    USBHwNakIntEnable(0);
    
    // init debug leds
    DEBUG_LED_INIT(8);
    DEBUG_LED_INIT(9);
    DEBUG_LED_INIT(10);

    return TRUE;
}







/**
    This function is used to setup and populated the various elements of a LPC2148 DMA desccriptor such that
    after calling this function, the DMA descriptor could be used as part of a DMA tranfer.
    
        
    @param [in] dmaDescriptor    A pointer to a 4 or 5 element long array of U32's that the DMA descriptor data is to be stored into, it should point to some place in DMA RAM.
    @param [in] nextDdPtr        The value to be placed in the "Next_DD_Pointer" value of the DMA desriptor, set to NULL if there is no next-pointer.
    @param [in] isIsocFlag       Flag to indicate if this DMA descriptor is for an ISOC endpoint (with a 5 element dmaDescriptor array pointer), 1 indicates ISOC, 0 indicates non-ISOC. 
    @param [in] maxPacketSize    The maximum packet size that can be sent/received for the endpoint in question.
    @param [in] dmaLengthIsocNumFrames    For non-ISOC endpoints, the number of bytes in the buffer to be transfered, for ISOC endpoints, the number of frames to be transfered.
    @param [in] dmaBufferStartAddress    Start address for the dma transfer (location to store data for an OUT endpoint, location to pull data from for an IN endpoint), it should point to some place in DMA RAM.
    @param [in] isocPacketSizeMemoryAddress   If a non-ISOC endpoint, set this to NULL, if an ISOC endpoint, then set this to a pointer to an array of U32's that represent how

    @return  void
 */
void USBSetupDMADescriptor(
		volatile U32 dmaDescriptor[], 
		volatile U32 nextDdPtr[],
		const U8 isIsocFlag, 
		const U16 maxPacketSize, 
		const U16 dmaLengthIsocNumFrames,
		void *dmaBufferStartAddress,
		U32 *isocPacketSizeMemoryAddress ) 
{
	dmaDescriptor[1] = 0;
	dmaDescriptor[0] = (U32) nextDdPtr;
	dmaDescriptor[1] |= ((maxPacketSize & 0x3FF) << 5);//Set maxPacketSize
	dmaDescriptor[1] |= (dmaLengthIsocNumFrames << 16);//aka number of ISOC packets if in ISOC mode
	if( isIsocFlag ) {
		dmaDescriptor[1] |= (1<<4);//enable isoc type
	}
	if( nextDdPtr != NULL ) {
		dmaDescriptor[1] |= (1<<2); //mark next DD as valid
	}
	dmaDescriptor[2] = (U32) dmaBufferStartAddress;
	
	if( isIsocFlag && isocPacketSizeMemoryAddress != NULL ) {
		dmaDescriptor[4] = (U32) isocPacketSizeMemoryAddress;
	}
	dmaDescriptor[3] = 0; //mark DD as valid and reset all status bits
}

/**
    This function disables DMA for the endpoint indicated by the paramater.
        
    @param [in] bEndpointNumber the endpoint number to be disabled.

    @return   void
 */
void USBDisableDMAForEndpoint(const U8 bEndpointNumber) {
	int idx = EP2IDX(bEndpointNumber);
	LPC_USB->USBEpDMADis = (1<<idx);
}

/**
    Enables DMA for a particular endpoint.
        
    @param [in] bEndpontNumber The endpoint to to enable DMA for.

    @return 
 */
void USBEnableDMAForEndpoint(const U8 bEndpointNumber) {
	int idx = EP2IDX(bEndpointNumber);
	LPC_USB->USBEpDMAEn = (1<<idx);
}

/**
    This function is used to initialized an ISOC frame array
        
    @param [in|out] isocFrameArr        The array of ISOC frame descriptors to be set, it should point to some place in DMA RAM.
    @param [in] numElements             The number of elements in the isocFrameArr array.
    @param [in] startFrameNumber        Number to start at for numbering each frame.
    @param [in] defaultFrameLength      The frame length to set all the frame descriptors to.

    @return  void
 */
void USBInitializeISOCFrameArray(U32 isocFrameArr[], const U32 numElements, const U16 startFrameNumber, const U16 defaultFrameLength) {
	U16 i;
	U16 frameNumber = startFrameNumber;
	
	for(i = 0; i < numElements; i++ ) {
		isocFrameArr[i] = (frameNumber<<16) | (1<<15) | (defaultFrameLength & 0x3FF);
		frameNumber++;
	}
}

/**
    This function is used to set the DMA descriptor head for the linked list of a particular endpoint.
        
    @param [in] bEp                    The endpoint number to set the DMA linked list head for.
    @param [in|out] udcaHeadArray      The array of pointers that point to the head DD elements for each endpoint, it should point to some place in DMA RAM.
    @param [in|out] dmaDescriptorPtr   The address of the DMA descriptor that is to be the new head, it should point to some place in DMA RAM.

    @return 
 */
void USBSetHeadDDForDMA(const U8 bEp, volatile U32* udcaHeadArray[32], volatile const U32 *dmaDescriptorPtr) {
	udcaHeadArray[EP2IDX(bEp)] = (U32*) dmaDescriptorPtr;
}

/**
    This function is used to initialize the USB DMA controller
        
    @param [in|out] udcaHeadArray   This is a pointer to the array of DMA descriptor linked-list head pointers, it should point to some place in DMA RAM.

    @return 
 */
void USBInitializeUSBDMA(volatile U32* udcaHeadArray[32]) {
	//set following 32 pointers to be null
	int i;
	for(i = 0; i < 32; i++ ) {
		udcaHeadArray[i] = NULL;
	}
	LPC_USB->USBUDCAH = (U32) udcaHeadArray;
}
