gligli/overcycler/firmware_17xx/synth/wtosc.c

///////////////////////////////////////////////////////////////////////////////
// Wavetable oscillator
///////////////////////////////////////////////////////////////////////////////

#include "wtosc.h"
#include "dacspi.h"
#include "osc_curves.h"

#define CLOCK SYNTH_MASTER_CLOCK
#define TICK_RATE DACSPI_TICK_RATE

#define MAX_SAMPLERATE (CLOCK/TICK_RATE)

#define WIDTH_MOD_BITS 14
#define FRAC_SHIFT 12

static FORCEINLINE uint32_t cvToFrequency(uint32_t cv) // returns the frequency shifted by 8
{
	uint32_t v;
	
	v=cv%(12*WTOSC_CV_SEMITONE); // offset in the octave
	v=(v*21)<<8; // phase for computeShape
	v=(uint32_t)computeShape(v,oscOctaveCurve,1)+32768; // octave frequency in the 12th octave
	v=(v<<WIDTH_MOD_BITS)>>(12-(cv/(12*WTOSC_CV_SEMITONE))); // full frequency shifted by WIDTH_MOD_BITS
	
	return v;
}

static FORCEINLINE void updatePeriodIncrement(struct wtosc_s * o, int8_t type)
{
	if(o->pendingUpdate>=type)
	{
		o->period[0]=o->pendingPeriod[0];
		o->period[1]=o->pendingPeriod[1];
		o->increment[0]=o->pendingIncrement[0];
		o->increment[1]=o->pendingIncrement[1];
		
		o->pendingUpdate=0;
	}
}

static FORCEINLINE void handlePhaseUnderflow(struct wtosc_s * o, int32_t bufIdx, oscSyncMode_t syncMode, int16_t * syncPositions)
{
	if(o->phase<0)
	{
		o->phase+=WTOSC_SAMPLE_COUNT;

		updatePeriodIncrement(o,1);
	
		// sync (master side)
		if(syncMode==osmMaster)
		{
			syncPositions[bufIdx]=o->counter;
		}
	}
}

static FORCEINLINE void handleSlaveSync(struct wtosc_s * o, int32_t bufIdx, int16_t * syncPositions)
{
	int16_t *sp=&syncPositions[bufIdx];
	if(*sp>INT16_MIN)
	{
		o->phase=0;
		o->counter=*sp;
		*sp=INT16_MIN;
	}
}

static FORCEINLINE int32_t handleCounterUnderflow_wmOff(struct wtosc_s * o, int32_t bufIdx, oscSyncMode_t syncMode, int16_t * syncPositions)
{
	int32_t curPeriod,curIncrement;
	
	curPeriod=o->period[0];
	curIncrement=o->increment[0];
	
	o->phase-=curIncrement;

	handlePhaseUnderflow(o,bufIdx,syncMode,syncPositions);

	o->counter+=curPeriod;

	o->prevSample3=o->prevSample2;
	o->prevSample2=o->prevSample;
	o->prevSample=o->curSample;

	o->curSample=o->mainData[o->phase];

	return (1<<(FRAC_SHIFT*2))/curPeriod;
}
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
