gligli/overcycler/(commit log)

2013-07-29 global sample rate based oscillators too much aliasing
    [main.c]
2013-07-30 4 voices -- no global sample rate
2013-08-04 timer match based implementation, simpler hardware, still lots of aliasing
2013-08-04 forcing increment to be a multiple of sample count, fixes aliasing -- perfect at last! :D
    [dacspi.h, main.c, synth.c, wtosc.c]
2013-08-04 need to wait for SSP and send LDAC directly after sample (removes a little more aliasing) -- cleanups
2013-08-15 adding schematics / code update
    [overcycler.sch, voice.dsn, voice.kicad_pcb, voice.sch, voiceA.kicad_pcb, voiceB.kicad_pcb, voiceC.kicad_pcb, voiceD.dsn]
2013-08-17 hardware project cleanup
    [voice.dsn, voice.kicad_pcb, voiceA.kicad_pcb, voiceB.kicad_pcb, voiceC.kicad_pcb, voiceD.dsn, voiceD.kicad_pcb, voiceE.dsn]
2013-08-19 ui / midi uart
2013-08-20 mainboard schema WIP
    [overcycler.sch]
2013-08-21 sch update
    [overcycler.dsn, overcycler.kicad_pcb, overcycler.sch, vca.sch]
2013-08-22 mainboard almost ok
    [overcycler.dsn, overcycler.kicad_pcb, overcycler.sch]
2013-08-22 mainboard ok
    [overcycler.kicad_pcb, overcycler.sch]
2013-08-31 hardware updates
    [overcycler.kicad_pcb, overcycler.sch, voice.kicad_pcb, voice.sch]
2013-08-31 new method for spi dacs: autonomous GPDMA
2013-09-01 return of interpolation-based global samplerate system
2013-09-23 adding vca board schematics
    [vca.dsn, vca.kicad_pcb, vca.sch]
2013-09-24 schematics fixes
    [overcycler.kicad_pcb, overcycler.sch, vca.kicad_pcb, vca.sch]
2013-09-30 almost perfect sound (2x oversampling; 150Khz final sample rate; cosine interpolation)
2013-10-01 small schematics cleanups / TODO: main/vca board need fixes
    [vca.kicad_pcb, voice.sch]
2013-10-07 MIDI pitch bend / modwheel support -- speedups
2013-10-07 dacspi fixes & tweaks
    [dacspi.c, dacspi.h]
2013-10-07 working oscs pitch modulation -- still a bit resource hungry
2013-10-08 opti: fixed point computations for osc pitch, pitch modulation now usable
    [osc_curves.h, storage.c, synth.c, wtosc.c, wtosc.h]
2013-10-14 wavetable oscillators refinements -- one more ui param
    [ui.c, wtosc.c, wtosc.h]
2013-10-20 SPI DAC double buffering -- WT Oscs / SPI DAC major improvements
2013-11-10 ui: pot scanner improvements (less noise)
    [midi.c, ui.c]
2013-11-10 wavemod envelopes fixes -- waveforms banks support
    [ffconf.h, midi.c, synth.c, synth.h, ui.c, wtosc.c]
2013-11-24 ui: working preset storage -- misc fixes
    [main.c, midi.c, storage.c, storage.h, synth.c, ui.c]
2013-12-07 wtosc: fix sometimes wrong pitch (eg: arp on the black keys) -- simpler code
    [wtosc.c, wtosc.h]
2013-12-07 ui: adding a rough manual filters tuner
2013-12-08 wtoc: implemented "Width" WaveMod type (universal PWM-like effect)
2014-05-01 hw: fix for potmux noise
    [overcycler.kicad_pcb, overcycler.sch]
2014-05-09 opti: use the GPDMA to generate CV DAC commands allowed me to boost the samplerate and still have better UI speed
2014-05-10 ui: pot scanner adjustments to reduce jitter
    [ui.c]
2014-05-10 fix oscs of tune (wrong samplerate formula)
    [dacspi.h]
2014-05-11 uae linear vca env and no vca linearisation -- tremolo fix
    [synth.c]
2014-05-11 reverting previous vca lin changes, awfully unmusical env attack!
    [synth.c]
2014-05-25 Osc B pitch can now be lower than Osc A
2014-05-25 adding "frequency" wavemod (allows pitch modulation by filter env)
2014-05-29 sch: VCFs output resistors change to drive the VCAs harder
    [voice.kicad_pcb, voice.sch]
2014-05-30 back to 100Mhz CPU, less overall problems/noise/heat/...
    [dacspi.c, dacspi.h, synth.h]
2014-05-30 hardware: VCA board R4 (fully working version)
    [vca.dsn, vca.kicad_pcb, vca.sch]
2014-08-23 groundwork for multitimbrality
2014-08-31 silencing deassigned voices by resetting the envs
    [adsr.c, adsr.h, synth.c]
2014-09-11 sch: fix mainboard footswitch resistor value
    [overcycler.kicad_pcb, overcycler.sch]
2014-09-14 changes for new LM13700-based VCA board
2014-09-14 hw: new LM13700-based VCA / Mixer board schematics
    [vca.sch]
2014-09-16 hw: LM13700 vca board wip
    [vca.dsn, vca.kicad_pcb, vca.sch]
2014-09-16 sh: LM13700 vca board routing finished
    [vca.dsn, vca.kicad_pcb, vca.sch]
2014-09-17 hw: LM13700 vca board improvements
    [vca.dsn, vca.kicad_pcb]
2014-09-17 hw: more improvements
    [vca.kicad_pcb]
2014-09-17 hw: revised mainboard
    [overcycler.dsn, overcycler.kicad_pcb, overcycler.sch]
2014-09-19 dacspi: 96Khz samplerate
2014-09-28 ui: much less pot scan value noise
    [ui.c]
2015-09-10 vca spice model -- beginning of overcycler2 schematics
    [overcycler2.sch]
2015-09-10 simulated master mixer output -- sch fixes
    [overcycler2.sch]
2015-09-10 adding spice for voltage controlled noise generator
2015-09-11 working VC noise gen -- sch tweaks
    [overcycler2.sch]
2015-09-11 DAC / mixer / filter sch ok
    [overcycler2.sch]
2015-09-12 vcf range adjustments
    [overcycler2.sch]
2015-09-12 vca range adjustments -- vca spice model update
    [overcycler2.sch]
2015-09-12 output range adjustments -- output spice model update
    [overcycler2.sch]
2015-09-12 output stage can be pushed a little harder without clipping
    [overcycler2.sch]
2015-09-12 hierarchical sheet for voice
    [overcycler2.sch, voice2.sch]
2015-09-12 adding overcycler2 netlist/cmp/empty pcb
    [overcycler2.sch, voice2.sch]
2015-09-13 adding pcb -- basic pcb placement
    [overcycler2.dsn, overcycler2.kicad_pcb, overcycler2.sch, voice2.sch]
2015-09-13 better pcb placement -- sch fixes
    [overcycler2.dsn, overcycler2.kicad_pcb, overcycler2.sch, voice2.sch]
2015-09-13 better pcb placement (first full autoroute)
    [overcycler2.dsn, overcycler2.kicad_pcb]
2015-09-13 better pcb placement
    [overcycler2.dsn, overcycler2.kicad_pcb, overcycler2.sch]
2015-09-13 autorouted pcb
    [overcycler2.dsn, overcycler2.kicad_pcb, overcycler2.sch]
2015-09-14 better pcb routing -- adding slew rate limiter caps for VCF Fc
    [overcycler2.dsn, overcycler2.kicad_pcb, overcycler2.sch, voice2.sch]
2015-09-15 dacspi: osc tuning fix
    [dacspi.c]
2015-09-15 board v2 -- dac addressing fixes
    [overcycler2.dsn, overcycler2.kicad_pcb, overcycler2.sch, voice2.sch]
2015-09-15 pcb: back to square one, can't rely on gound plane
    [overcycler2.dsn, overcycler2.kicad_pcb]
2015-09-15 clock fix -- 400 presets now
    [main.h, storage.c, synth.c, ui.c]
2015-09-16 rev3 pcb
    [overcycler2.dsn, overcycler2.kicad_pcb]
2015-09-16 pcb r3 ok!
    [overcycler2.kicad_pcb]
2015-09-16 extracted vca/vcnoise linearisation curves from spice models -- proper integration of new CVs
    [vca.ods, vcnoise.ods]
2015-09-16 sch/pcb: making the noise generator a lot more resilient to 50hz ripple
    [overcycler2.kicad_pcb, overcycler2.sch, voice2.sch]
2015-09-16 sch/pcb: whoops! one cap was backwards
    [overcycler2.kicad_pcb, overcycler2.sch]
2015-09-17 now compensating resonance volume loss with the pre-filter mixer -- sch changes to accomodate this before that, cranking up the resonance made the filter/vca lose its overdrive, which was totally cou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
    [overcycler2.kicad_pcb, overcycler2.sch, voice2.sch]
2015-09-17 sch: adding notes in case someone wants to build it
    [overcycler2.sch, voice2.sch]
2015-09-17 dacspi: variable speed for the SSP allows to up the samplerate while keeping CV DACs accesses at low speed
2015-09-20 adding lcd driver -- basic ui redirect to both halves of screen
2015-09-20 ui: changes for bigger display -- displaying both pots and buttons at the same time
2015-09-21 main: init UI before anything else -- dacspi: proper pins for spi mux
2015-09-21 ui: working new keypad wiring -- lcd access refactoring
2015-09-21 ui: visual delimiter between pots and buttons
2015-09-21 pcb r4, one resistor was missing
    [overcycler2.kicad_pcb, overcycler2.sch, voice2.sch]
2015-09-21 ui: working TLV1543 ADC scan
2015-09-21 hw: removing old overcycler1 schematics & pcbs
    [overcycler.dsn, overcycler.kicad_pcb, overcycler.sch, vca.dsn, vca.kicad_pcb, vca.sch, voice.dsn, voice.kicad_pcb]
2015-09-21 pcb r4 cleanup
    [overcycler2.kicad_pcb]
2015-09-22 ui: adc filtering -- fullscreen display improvements -- refactoring
2015-09-22 ui: remove "1" from tune button
2015-09-23 hw: fixing unconnected SPI_MOSI/SPI_SCK (pcb r5)
    [overcycler2.kicad_pcb, overcycler2.sch, voice2.sch]
2015-09-24 wtosc: interpolation fix for very low frequencies
    [wtosc.c]
2015-09-24 hw: lower value pullup for ADC_CLK, makes the adc work much better
    [overcycler2.kicad_pcb, overcycler2.sch, voice2.sch]
2015-09-24 dacspi-ui: back to a decoupled state, working dacspi, noisy ADC
2015-09-24 ui: ADC reading improvements
2015-09-25 ui: using ADC in 16clock transfer mode, less capture noise -- less keypad scan delay
    [ui.c]
2015-09-25 synth: no glitch when changing waveforms
    [synth.c]
2015-09-25 hw: vca sheet update
    [vca.ods]
2015-09-26 ui: displaying samplerate on splash screen
2015-09-26 hw: VCF resonance adjumstments
    [overcycler2.kicad_pcb, overcycler2.sch, voice2.sch]
2015-09-26 ui: relax ADC filtering
2015-09-27 ui: removing sound crackles by minimising the time passed blocking ints also improves UI refresh rate
    [ui.c]
2015-09-27 hw: adjusted noise generator resistor value
    [overcycler2.kicad_pcb, overcycler2.sch, voice2.sch]
2015-09-27 hw: pcb R6 (pad holes adjustments & overall cleanup)
    [overcycler2.kicad_pcb]
2015-09-27 ui: remove debug code -- fullscreen bargraph fix
    [ui.c]
2015-09-29 storage: useful default vibrato speed
    [storage.c]
2015-09-29 wtosc: fix excessive aliasing with sync
    [wtosc.c]
2015-09-30 storage: backwards compatibility fix
    [storage.c]
2015-10-01 main: trying to fix the display sometimes not initializing properly
    [main.c]
2015-10-01 finer grained interruption blocking BLOCK_INT now has a parameter that tells the lowest int priority that will be blocked, 0 blocks nothing
2015-10-02 dacspi: moving all DMA source data to EXT_RAM (speedup) -- finer interrupts lli positionning
2015-10-02 ui: tighter pot scan
    [ui.c]
2015-10-02 wtosc: fix linear interpolation mode
    [wtosc.c]
2015-10-03 wtosc: forced aliasing fix
    [wtosc.c]
2015-10-03 wtosc: trying to fix clicks when changing increment
    [wtosc.c]
2015-10-03 wtosc: misc improvements -- still trying to fix the clicks
    [wtosc.c, wtosc.h]
2015-10-04 wtosc: arm asm multisample -- sync speedup
2015-10-04 dacspi: exactly 96Khz sample rate
2015-10-04 wtosc: width wavemod fix -- lowering oversampling to ensure crisp treble
    [wtosc.c]
2015-10-04 Revert "dacspi: exactly 96Khz sample rate"
    This reverts commit 928fd2e3f63887638e208f17bd888b421114df54.
    [dacspi.c, dacspi.h]
2015-10-04 ui: way too much delay here
    [ui.c]
2015-10-06 Moving to a GCC 4.9 toolchain https://launchpad.net/gcc-arm-embedded/+milestone/4.9-2015-q3-update
2015-10-06 synth/wotsc: hermite interpolation needs a guard band on sample data to work fine!
2015-10-06 wtosc: removal of multisampling -- uses way too much resources
    [wtosc.c]
2015-10-07 synth: further improvements to VCA linearity
    [vca.ods]
2015-10-08 synth: this is no longer needed
    [synth.c]
2015-10-08 adding 2 track sequencer -- adding transpose feature
2015-10-09 wtosc: this comment was wrong
    [wtosc.h]
2015-10-14 ui: parameter name fix
    [ui.c]
2015-10-14 synth: fix LFO to VCA modulation lowering volume
    [synth.c]
2015-11-12 adding crossover WaveMod to OscA blends 2 waveforms and allows blending factor modulation by LFO or (paraphonic) filter envelope
2015-11-12 adding lin/exp choice for filter env
2015-11-14 fix for crash on unison disable -- moving more stuff to EXT_RAM
    [arp.c, assigner.c, assigner.h, seq.c, storage.c, ui.c]
2016-08-20 ui: adding load prev / next preset buttons
2016-08-20 assigner: use less memory to store velocity -- fix for unison disable lockup
    [assigner.c]
2016-08-21 ui: fix crossover display
    [ui.c]
2016-08-21 synth: addding support for waveforms of any sample count below or equal to 600 samples (ProphetVS waveforms support)
2016-08-27 synth: fix crossover samplecount
    [synth.c]
2016-08-28 lfo: adding reverse saw waveform
    [lfo.c, lfo.h, ui.c]
2016-08-28 synth: doubled refresh rate (4Khz interrupt)
2016-08-28 all: replaced the vibrato by a full featured second LFO -- adding LFO to resonance mod
    [lfo.c, storage.c, storage.h, synth.c, ui.c]
2017-11-20 fixes for new toolchain (gcc-arm-none-eabi-6-2017-q2-update-win32)
    [hd44780.c, main.h]
2018-06-29 fixed lfo2wmodamt param -- added voice count param -- refact
    [storage.c, storage.h, synth.c, ui.c]
2019-02-11 back to gcc 5.2 ( arm-eabi-gcc5.3.0-r2.exe ) to fix pots and sync
    [main.h]
2019-04-14 bender to filter cutoff by default -- strength x2 on that modulation
2019-04-14 fix VCnt param display
    [ui.c]
2019-04-14 fixed silencing voices on unison pattern change
    [assigner.c]
2019-04-29 assginer: huge voice stealing fix in poly mode -- optis (less ram, sppedup)
    [assigner.c, assigner.h, synth.c, synth.h]
2020-01-12 hardware: voice sch clarification
    [overcycler2.sch, voice2.sch]
2021-05-29 Adding devkit user manual & schematics
2021-08-25 better buffer_dump (printf based)
2021-08-25 changed VCNoise level (3M3 diode input res)
    [overcycler2.kicad_pcb, overcycler2.sch, voice2.sch]
2022-01-20 updated vcnoise curve for stronger noise generator
    [vcnoise.ods]
2022-01-20 hw: fixed voice tuning note
    [overcycler2.sch, voice2.sch]
2022-01-20 ui: load basic preset (misc page, key 9) -- fixed startup screen speed
    [ui.c]
2022-01-20 synchronous CV updates @ 2500Hz (adsr & lfo speed div) -- sanitized scan llis synth @ 80Khz now, system timer @500hz for slow stuff
2022-01-24 uart_midi: init/ack clarification
2022-05-07 midi: arp transposed fix
    [midi.c]
2022-05-07 preset_packAndRemoveDuplicates (tune page, button 8) -- arp clock fix -- transpose extents reduced to -24->24
    [main.c, main.h, storage.c, storage.h, ui.c]
2023-02-02 crossover bugfixes (copy b to xovr; oob in assigner_getLatestAssigned)
    [assigner.c, ui.c]
2023-09-29 dacspi: 2*16 buffers for oscillators -- synth: 5Khz CV updates
    [dacspi.c, synth.c]
2023-09-30 midi: program change patch load fix -- ui: patch load simplification
    [midi.c, ui.c]
2023-09-30 ui: XoCp from oscillator A
    [ui.c]
2023-10-06 dacspi: lowered MCP4922 SPI frequency (good enough)
2023-10-06 doc: adding utility spreadsheets
    [osc.ods, srate.ods]
2023-10-07 scan: bugfixed LLIs from flash (now properly from EXT_RAM)
    [scan.c]
2023-10-08 New toolchain ( arm-gnu-toolchain-12.3.rel1-mingw-w64-i686-arm-none-eabi.exe )
2023-10-08 wtosc: sync bugfix -- syncResets simplification
    [synth.c, wtosc.c]
2023-10-08 wtosc: aliasing fix, cleanup
    [wtosc.c]
2023-10-09 wtosc: reverted half phase changes (problems with aliasing cv)
    [wtosc.c, wtosc.h]
2023-10-09 ui: fixed disrepancy between settings.presetNumber and ui state
    [ui.c]
2023-10-12 Migrated Overcycler2 hardware to KiCad 7.08
    [overcycler2.kicad_pcb, overcycler2.kicad_sch, overcycler2.sch, voice2.kicad_sch, voice2.sch]
2023-10-14 hardware: OverCycler3 schematics WIP
    [overcycler2.kicad_sch, voice2.kicad_sch]
2023-10-14 hardware: OverCycler3 schematics WIP2
    [overcycler2.kicad_sch, voice2.kicad_sch]
2023-10-16 hardware: OverCycler3 schematics Rev1 OK
    [overcycler2.kicad_sch, voice2.kicad_sch]
2023-10-16 hardware: SSM2044 -> SSI2144
    [voice2.kicad_sch]
2023-10-16 hardware: lib fix
    [voice2.kicad_sch]
2023-10-16 hardware: noise transistor change -- minor fixes
    [overcycler2.kicad_sch, voice2.kicad_sch]
2023-10-17 hardware: USB GND should be tied to GND -- minor fixes
    [overcycler2.kicad_sch, voice2.kicad_sch]
2023-10-17 hardware: adjusted mixer levels
    [overcycler2.kicad_sch, voice2.kicad_sch]
2023-10-19 hardware: sch small changes -- footprints assigned
    [overcycler2.kicad_sch, voice2.kicad_sch]
2023-10-19 hardware: overcycler2 -> overcycler3 rename
    [overcycler3.dsn, overcycler3.kicad_pcb, overcycler3.kicad_sch, voice3.kicad_sch]
2023-10-19 hardware: beginning of overcycler 3 PCB
    [overcycler3.dsn, overcycler3.kicad_pcb, overcycler3.kicad_sch, voice3.kicad_sch]
2023-10-20 hardware: draft PCB placement
    [overcycler3.dsn, overcycler3.kicad_pcb]
2023-10-24 hardware: CV DAC change -- misc changes -- draft routing
    [overcycler3.dsn, overcycler3.kicad_pcb, overcycler3.kicad_sch, voice3.kicad_sch]
2023-10-24 hardware: improved draft routing
    [overcycler3.dsn, overcycler3.kicad_pcb]
2023-10-25 hardware: TLV2556 ADC in SPI -- improved draft routing
    [overcycler3.dsn, overcycler3.kicad_pcb, overcycler3.kicad_sch, voice3.kicad_sch]
2023-10-25 hardware: silkscreen improvements
    [overcycler3.kicad_pcb]
2023-10-29 hardware: chnaged some capacitor values and footprints
    [overcycler3.dsn, overcycler3.kicad_pcb, voice3.kicad_sch]
2023-10-29 hardware: improved routing
    [overcycler3.kicad_pcb]
2023-11-01 dedicated WaveMod page for oscillators
    [storage.c, storage.h, synth.c, ui.c]
2023-11-03 ui: fix "panic off" mangling assigner settings
    [ui.c]
2023-11-07 Revert "wtosc: incModLUT opti" (fixes ProphetVS waves wixed with AKWF)
    [wtosc.c]
2023-11-14 Manual PCB routing by Guimli WIP
    [overcycler3.kicad_pcb, overcycler3.kicad_sch, voice3.kicad_sch]
2023-11-19 Manual PCB routing by Guimli WIP2
    [overcycler3.kicad_pcb, overcycler3.kicad_sch, voice3.kicad_sch]
2023-11-19 Manual PCB routing by Guimli WIP3
    [overcycler3.kicad_pcb]
2023-11-28 Manual PCB routing by Guimli Done!
    [overcycler3.kicad_sch, voice3.kicad_sch]
2023-12-04 hardware: Adding LCSC references
    [overcycler3.kicad_sch, voice3.kicad_sch]
2023-12-17 ui: reworked patch load pots in hundreds/tens/units -- ui: refact
    [midi.c, ui.c]
2023-12-20 hardware: improved LCSC references
    [overcycler3.kicad_sch]
2023-12-21 midi: fix loading empty patch from prog change
    [midi.c]
2023-12-22 synth: volume and crossover as new targets for pitch bender
2023-12-27 ui: numerically set potentiometer value / preset number (bugfixes)
    [ui.c]
2023-12-28 hardware: proper production files for JLCPCB
    [BOM-overcycler3.csv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]
2023-12-29 hardware: proper production files for JLCPCB (oops! diodes were reversed)
    [CPL-overcycler3.csv, overcycler3-CuBottom.gbr, overcycler3-CuTop.gbr, overcycler3-EdgeCuts.gbr, overcycler3-MaskBottom.gbr, overcycler3-MaskTop.gbr, overcycler3-NPTH.drl, overcycler3-PTH.drl]
2024-01-11 main: back to 100Hz disk_timerproc() updates (fixes spurious error on startup)
    [main.c]
2024-01-11 ui: fix "Midi Channel" getting stuck, "Omni" properly identified
    [ui.c]
2024-01-12 synth: base filter tracking note changed to C4 -- cleanup
2024-01-12 main: stop on disk/fs error
    [main.c]
2024-01-19 firmware_17xx: beginning of port to lpc1778/overcycler3 hardware (screen + uart ok)
2024-01-20 utils: buffer_dump rprintf fix
    [utils.c]
2024-01-20 xt26g: basic low level driver for NAND flash
2024-01-21 nand: fatfs over nand starting to work -- xt26g: bugfixes, cleanup
    [diskio.c, main.c, synth.c]
2024-01-22 synth: runs :) -- serial: 57600bps, init by hand to workaround a crash on startup when initing MIDI uart -- cmsis library update
    [LPC177x_8x.h, lpc177x_8x_adc.c, lpc177x_8x_bod.c, lpc177x_8x_can.c, lpc177x_8x_clkpwr.c, lpc177x_8x_clkpwr.h, lpc177x_8x_crc.c, lpc177x_8x_crc.h]
2024-01-23 scan: working pots scan using TLV2556 ADC
2024-01-25 usb: using interrupts instead of polling
2024-01-26 usb: Adding usb_midi, small fixes
    [main.c, midi.c, midi.h, synth.c, synth.h, uart_midi.c]
2024-01-26 usb: Adding usb_power, misc fixes -- ui: adding USB Mode setting
    [main.c, main.h, storage.c, storage.h, synth.c, ui.c]
2024-01-28 dacspi: ported to oc3, refact
    [srate.ods]
2024-01-28 dacspi: voice order bugfix
    [dacspi.c]
2024-01-28 scan: lowered TLV2556 SPI frequency
2024-01-30 tuner: fixed point math, cleanup
    [main.h, tuner.c]
2024-01-30 tuner/scan: worked around a weird buffer overflow bug, no tune on bad settings
    [scan.c, scan.h, synth.c, tuner.c]
2024-01-30 tuner: improved measureAudioPeriod (init fix, dual sided)
    [tuner.c]
2024-01-30 ui: USB bugfix, intro screen button names
    [ui.c]
2024-01-30 synth: lower VCA output level to avoid master mix saturation
    [synth.c]
2024-01-31 usb: cleanup -- warning removal (one oob bug)
    [lpc177x_8x_nvic.c, lpc_types.h, scan.c]
2024-01-31 lfo: wider speed range -- ui: no more spLFOxShift, preparing for adding channel pressure params
2024-02-01 assigner: rework for proper stolen voices restoration in poly mode
    [assigner.c, assigner.h, storage.c, synth.c, synth.h]
2024-02-01 midi: channel pressure implementation
2024-02-02 synth: pressure to pitch goes downwards
2024-02-02 wtosc: WTOSC_MAX_SAMPLES 2048 -- synth: MAX_BANKS 128, MAX_BANK_WAVES 256, init bugfix, cleanup
    [main.h, synth.c, wtosc.h]
2024-02-02 dacspi: reset on init, CV DACs init, tweaks
    [dacspi.c]
2024-02-03 synth: crossover on both oscillators :) -- refact
    [midi.c, storage.c, storage.h, synth.c, synth.h, ui.c]
2024-02-03 wtosc: dual sided crossover, refact -- synth: proper bender/pressure crossover
2024-02-03 storage: bugfix, half volume by default
    [storage.c]
2024-02-03 doc: typo
    [srate.ods]
2024-02-03 dacspi: give priority to the GPDMA controller over anything else to lower jitter
    [LPC177x_8x.h, dacspi.c]
2024-02-03 midi: deferred disk accesses -- synth: bugfix
    [midi.c, midi.h, storage.c, synth.c]
2024-02-05 Makefile: cleanup -- boot: needs USB disk mode, else the synth is still brickable in case no firmware on the disk
2024-02-06 dacspi: better use of channel wait states, allowing 20MHz SPI
    [srate.ods]
2024-02-06 hardware: oc3 hardware R2 (updates from porting the firmware)
    [BOM-overcycler3.csv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]
2024-02-07 scan: init fix, tweaks
    [scan.c, ui.c]
2024-02-07 hardware: oc3 hardware R2 (ferrite on the ADC reference)
    [BOM-overcycler3.csv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]
2024-02-07 scan: more init fix, tweaks
    [scan.c]
2024-02-08 scan: bugfix, reverted to an older version of the locking algo to prevend spurious locks
    [scan.c]
2024-02-08 scan: LLI bugfixes, cleanup
    [scan.c]
2024-02-08 tuner: overall improvements in tuning repeatability -- scan: 10bit mode SSP and 8bit output for sampleMasterMix -- dacspi: fix freeze on reinit
    [dacspi.c, scan.c, scan.h, tuner.c, ui.c]
2024-02-08 tuner: lli pot offset after tune bugfix
    [scan.c]
2024-02-09 wtosc: reactivate guard band (preventing aliasing from clipping)
    [wtosc.h]
2024-02-09 Adding improved .wav parser -- stack was too small
    [synth.c, wave_reader.c, wave_reader.h]
2024-02-09 now using dacspi interrupt do handle timer updates in synth, faster and cleaner -- SystemCoreClockUpdate back into SystemInit
2024-02-10 tuner: fixed out of tuning spurious ui changes, refact -- scan: scan_setMode to enclose scan_sampleMasterMix calls -- ui: fix timeouts init
    [scan.c, scan.h, tuner.c, ui.c]
2024-02-11 dacspi: whoops, low DACSPI_TIMER_MATCH don't work at proper sample rate -- wtosc: WIDTH_MOD_BITS=10, refact -- synth: synth_timerEvent on 10 phases
2024-02-11 scan: out of lock -> current value must be taken into account
2024-02-12 dacspi: 64Khz sample rate / 20Mhz SPI / 4Khz synth updates -- adsr/lfo: removed useless speedDiv -- synth: resonance bugfix
    [srate.ods]
2024-02-12 hardware: missing fillets
    [overcycler3-CuBottom.gbr, overcycler3-CuTop.gbr, overcycler3-EdgeCuts.gbr, overcycler3-MaskBottom.gbr, overcycler3-MaskTop.gbr, overcycler3-NPTH.drl, overcycler3-PTH.drl, overcycler3-PasteBottom.gbr]
2024-02-15 midi: cc table bugfix
    [midi.c]
2024-02-15 ui: fix locked unattainable value, refact, comments
    [ui.c]
2024-02-16 synth: fix disparate sampleCount for A/AXo and B/BXo
    [synth.c]
2024-02-16 ui: fix negative value display, fix disparate sampleCount (bis), include cleanup
    [ui.c]
2024-02-16 ui: fixed bargraph display extents
    [ui.c]
2024-02-17 ui: huge revamp, ui now organized |-|-|-|-| with ABCD as generic buttons and 0-9 as pages
2024-02-18 ui: transpose displayed in note names, bugfixes, refact
    [ui.c]
2024-02-18 synth: fix bank/wave indexes not recomputed, fix reload bank names after USB MSC
    [synth.c, synth.h, ui.c]
2024-02-18 synth: fix wrong assigner pattern after preset load
    [midi.c, synth.c, synth.h, ui.c]
2024-02-19 synth: fixed loading 8.3 bank and wave names, default waveform _basic/saw.wav
    [synth.c, synth.h]
2024-02-19 hardware: adding filters on MIXA/MIXB/MIXN CVs -- needs PCB update
    [overcycler3.kicad_sch, voice3.kicad_sch]
2024-02-21 ui: fix "set digits" for custom param
    [ui.c]
2024-02-21 utils: fix computeShape in hermite mode, comments
    [utils.c]
2024-02-21 vca_curves: improved curve -- vcnoise_curves: tidying
    [vca.ods]
2024-02-23 hardware: adjusted mixer output level (cf. prev commit), USB ground now entirely disconnected from GND
    [overcycler3.kicad_sch, voice3.kicad_sch]
2024-02-23 dacspi: noDblBuf option for dacspi_setCVValue (fixes tuner)
    [dacspi.c, dacspi.h, midi.c, synth.c, synth.h, tuner.c, ui.c]
2024-02-24 wtosc: fixes for exact 50% duty cycle by default
    [wtosc.c]
2024-02-25 synth: slightly boosted pre-filter mixer levels analog, baby :D
2024-02-26 dacspi: fix wrong LFOs speed
    [dacspi.h]
2024-02-26 wtosc: fix high pitches, tweaks
    [wtosc.c]
2024-02-26 synth: added LFO1/2 Speed multiplier, ui+storage changes -- ui: moved 1Tgt/2Tgt back to buttons
2024-02-26 ui: fix tuner display
    [ui.c]
2024-02-28 hardware: TL074->TL064 (with datasheet), remade ADC reference (with spice sim)
    [overcycler3.kicad_sch, voice3.kicad_sch]
2024-03-24 dacspi: bugfix, more log
    [dacspi.c]
2024-03-28 resample all waveforms to 2400 samples on load
2024-04-20 hardware: Schematics rework by Guimli
    [Power_Supply.kicad_sch, overcycler3.kicad_sch, voice3.kicad_sch]
2024-04-20 hardware: sch update (AD5674R replacing AD5328B*2)
    [overcycler3.kicad_sch]
2024-04-25 sch: NAND -> 512Mb NOR FLASH
    [overcycler3.kicad_sch]
2024-04-28 hardware: sch/pcb updates by Guimli
    [Power_Supply.kicad_sch, overcycler3.kicad_pcb, overcycler3.kicad_sch]
2024-04-28 adding enclosure doc
2024-05-07 hardware: pcb updates by Guimli
2024-05-10 Adding enclosure designs
    [PT-10 Rear-B_Cu.gbr, PT-10 Rear-B_Mask.gbr, PT-10 Rear-B_Paste.gbr, PT-10 Rear-B_Silkscreen.gbr, PT-10 Rear-Edge_Cuts.gbr, PT-10 Rear-F_Cu.gbr, PT-10 Rear-F_Mask.gbr, PT-10 Rear-F_Paste.gbr]
2024-05-11 enclosure: fixed Rear
    [PT-10 Rear-B_Cu.gbr, PT-10 Rear-B_Mask.gbr, PT-10 Rear-B_Paste.gbr, PT-10 Rear-B_Silkscreen.gbr, PT-10 Rear-Edge_Cuts.gbr, PT-10 Rear-F_Cu.gbr, PT-10 Rear-F_Mask.gbr, PT-10 Rear-F_Paste.gbr]
2024-05-12 hardware: LCSC review, production files ok
    [BOM-overcycler3.csv, Power_Supply.kicad_sch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]
2024-06-04 ui: ported LCD to new board rev -- hd44780: fixed waits (improve compatibility with LCDs)
    [hd44780.c, hd44780.h, ui.c]
2024-06-04 scan: ported to new board rev
2024-06-06 usb: fix buffer overflow preventing USB from working -- some more ERR_INT error handling in isr
    [usbhw_lpc.c, usbinit.c]
2024-06-13 dacspi: ported to new board rev
    [srate.ods]
2024-06-13 tuner: fix low octave not tuning
    [tuner.c]
2024-06-16 synth: fix modwheel/pressure volume to noise CV
    [synth.c]
2024-06-16 hardware: sch/pcb changes by Guimli (adding USB isolator, misc fixes)
    [BOM-overcycler3.csv, Power_Supply.kicad_sch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]
2024-06-16 hardware: voice mixer -> 820 ohms
    [Power_Supply.kicad_sch, overcycler3.kicad_sch, voice3.kicad_sch]
2024-06-16 hardware: revamped noise generator, now using BC858B
    [overcycler3.kicad_sch]
2024-06-16 hwarware: IA0505S-2W, JETEKPS -> RLT
    [Power_Supply.kicad_sch, overcycler3.kicad_sch]
2024-06-16 hardware: don't add pullup on D+, ADUM3160 handles it
    [Power_Supply.kicad_sch]
2024-06-16 synth: avoid output saturation by limiting the max VCA level
    [synth.c]
2024-06-17 scan: fload based to/from 16bits pot conversion (fixes disrepancies when saving/loading patch)
    [lfo.c, scan.c, scan.h, storage.c, ui.c]
2024-06-19 ui: fix fast "set digits" after pot turning
    [ui.c]
2024-06-19 ui: startup page now a proper page (fixes tranposing for this page)
    [ui.c]
2024-06-19 Add ADuM3160 and correct enclosure rear
    - ADuM3160 added for USB isolation
    - Correction of USB traces to respect 90Ω in two-layer PCBs
    - Integration of Noise circuit modifications
    [PT-10 Rear.FCStd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]
2024-06-22 Replace "Main Output" by "Output"
    - Replace "Main Output" by "Output" on Panel Rear
    - Manually add Teardown
    - Replace 24Ω by 33Ω on USB Isolator
    [PT-10 Rear.kicad_pcb, Power_Supply.kicad_sch, overcycler3.kicad_sch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]
2024-06-22 sch: making the volume pot antilog by adding a wiper resistor
    [overcycler3.kicad_sch]
2024-06-22 Add antilog resistor for volume to PCB
    - Add antilog resistor for volume to PCB
2024-06-23 hardware: add missing D+ pullup resistor (MCU side)
    [Power_Supply.kicad_sch]
2024-06-24 Add USB pullup resistor
    - Add USB pullup resistor
    [Power_Supply.kicad_sch, overcycler3.kicad_sch]
2024-06-24 boot: fix contrast multiplier
    [boot.c]
2024-06-26 fat: set _FS_TINY to avoid many stack overflow
    [ffconf.h]
2024-06-26 wtosc: back to WTOSC_SAMPLE_COUNT = 2400 samples, as it still fits in RAM
2024-06-26 hardware: updated some LCSC references
    [BOM-overcycler3.csv, Power_Supply.kicad_sch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]
2024-06-27 storage: reset wheels/pressure on load, fixes cases of out of tune oscs after load
    [storage.c]
2024-06-29 dacspi: only one timer tick to push 2 values thru SPI
    [srate.ods]
2024-07-02 hardware: lowered voice mixer amplification (10k->2k2)
    [BOM-overcycler3.csv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]
2024-07-02 dacspi: small opti -- synth: VCA CV now full swing -- tuner: fixes
    [dacspi.c, synth.c, tuner.c]
2024-07-03 scan: rework for one-shot pots scanning
    [scan.c, storage.c]
2024-07-03 scan: improved scan_sampleMasterMix, PrescaleValue fix
    [scan.c, scan.h, tuner.c]
2024-07-04 Revert "scan: rework for one-shot pots scanning" Because this caused sound glitches
    [scan.c]
2024-07-04 ui: load/save warnings bugfixes
    [ui.c]
2024-07-04 scan: also revert pot timeout
    [scan.c]
2024-07-04 synth: half scale to avoid VCA clipping
    [synth.c]
2024-07-06 wtosc: improved sync position (fixes aliasing when syncing)
    [synth.c, wtosc.c, wtosc.h]
2024-07-07 disk: 2400 samples for basic waves, adding null wave
2024-07-07 hardware: adding C133 power cap for U17
    [Power_Supply.kicad_sch, overcycler3.kicad_sch, voice3.kicad_sch]
2024-07-07 Revert "hardware: adding C133 power cap for U17"
    This reverts commit 8738242c85995857a35743226940d4cf8740802b.
    [Power_Supply.kicad_sch, overcycler3.kicad_sch, voice3.kicad_sch]
2024-07-07 hardware: 47uF reservoir for 3V3 (properer than prev commit)
    [Power_Supply.kicad_sch]
2024-07-08 hardware: updated PCB and production files (47uF reservoir for 3V3)
    [BOM-overcycler3.csv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]
2024-07-09 hardware: BOM/CPL review, fixes for no stock
    [BOM-overcycler3.csv, Power_Supply.kicad_sch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]
2024-07-12 Correct placement component for production
    [CPL-overcycler3.csv, overcycler3-CuBottom.gbr, overcycler3-CuTop.gbr, overcycler3-EdgeCuts.gbr, overcycler3-MaskBottom.gbr, overcycler3-MaskTop.gbr, overcycler3-NPTH.drl, overcycler3-PTH.drl]
2024-08-01 firmware_17xx: changes for PCB R6 (/!\ not compatible with protos)
    [boot.c, ui.c]
2024-08-10 Addition of a PCB for potentiometer connection
    - Addition of a PCB for potentiometer connection
    - Addition of a missing track on U19
    - Overhaul of component rotation in JLCPCB plugin
    [PT-10 Top Potentiometer-CorpsPocket001.step, PT-10 Top Potentiometer.dxf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]
2024-08-13 hardware: BC858B -> BC856B
    [BOM-overcycler3.csv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]
2024-09-05 hardware: using nexperia BC856B
    [BOM-overcycler3.csv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]
2024-10-04 vca_curves.h: improved linearization (spreadsheet bugfix)
    [vca.ods]
2024-10-07 synth: AXoC/BXoC -> AXoS/BXoS (swap instead of copy) -- sine as default crossover waveform
    [storage.c, synth.h, ui.c, ui_pages.h, utils.c, utils.h]
2024-10-11 wtosc: major rewrite, unrolled for only one wavemod at a time (speedup!) -- crossover bugfix
    [synth.c, synth.h, tuner.c, ui_pages.h, utils.c, utils.h, wtosc.c, wtosc.h]
2024-10-13 storage: patch names feature -- ui: no warning when saving patch in same slot
2024-10-13 wtosc: crossover extents bugfix
    [wtosc.c]
2024-10-15 lfo: rework for more musical waveforms phase
    [sine.ods]
2024-10-18 ui: first button press just displays the list of options if there is one
2024-10-25 wtosc: reverted buggy optimisation (fixes aliasing on highest notes)
    [synth.h, wtosc.c, wtosc.h]
2024-10-25 wtosc: incModLUT bugfix (fixes undersample on lowest notes)
    [wtosc.c]
2024-10-25 Revert "wtosc: reverted buggy optimisation (fixes aliasing on highest notes)" -- Optimisation made proper (still slightly faster)
    This reverts commit 1c1a69aa995f36cdd01cb4f7e6ac3b96cb7aee70.
    [wtosc.c]
2024-10-25 ui_pages: oops! (cnTrspV indicating the wrong key)
    [ui_pages.h]
2024-10-25 synth: refreshTunedCVs fixes (by default, rest the synth on scale middle; code speed bugfix)
    [synth.c]
2024-10-26 ui: bugfixes from prev commit
    [ui.c]
2024-10-28 ui: twice the wait for deferred cnLPrv / cnLNxt (prevents spurious loads while scrolling through presets)
    [ui.c]
2024-10-28 harware: changed some LCSC refs to accomodate for stock
    [BOM-overcycler3.csv, Power_Supply.kicad_sch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]
2024-10-29 synth: glide bugfix; only do "rest the synth on scale middle" at init this fixes a bug introduced in commit feb84889adf2b5ca16189f810d6e66c3d21cf705
    [synth.c]
2024-10-29 assigner: tiny bugfix; cleanup
    [assigner.c]
2024-10-29 synth: synth_silenceSynth, replaces silencing the voices by hand
    [midi.c, synth.c, synth.h, ui.c]
2024-10-29 wtosc: wmWidth bugfix eg: play lowest notes on patch 3 then play highest notes and they had a glitched attack
    [wtosc.c]
2024-10-29 wtosc: WTOSC_HIGHEST_NOTE = 108; no interpolation reduction if no grit; max duty cycle is now dependant on pitch overall try to reduce bugs or limit aliasing on highest notes
    [osc_curves.h, wtosc.c, wtosc.h]
